krayon/pinball-OPP/MPF/SS3/images/sal_girl.jpg

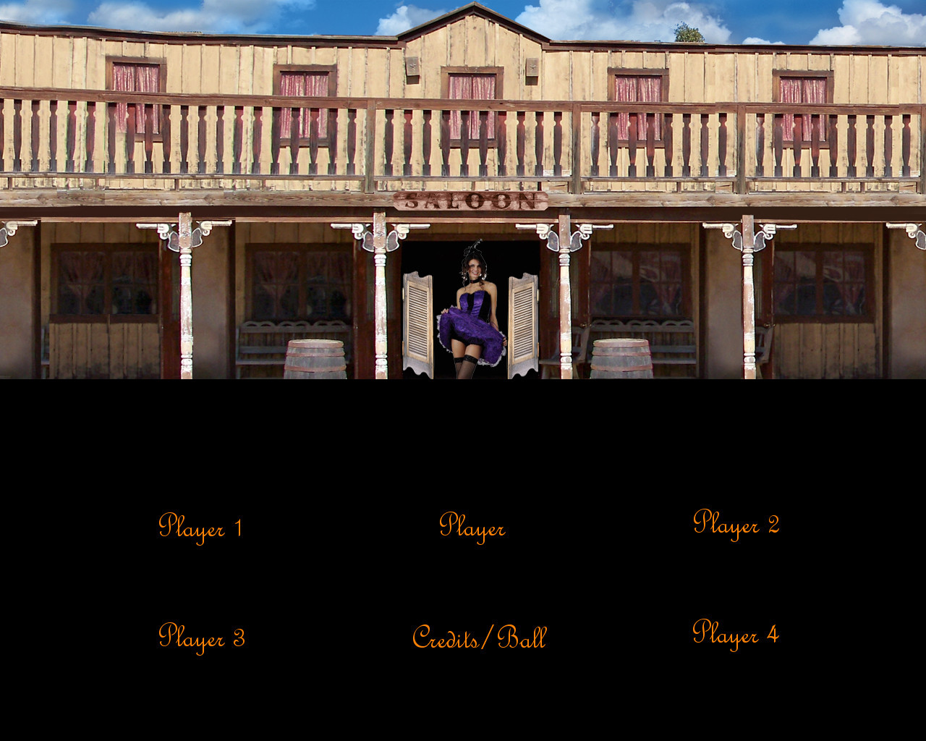
MPF/SS3/images/sal_girl.jpg
