krayon/pinball-OPP/Docs/opp_inside.jpg

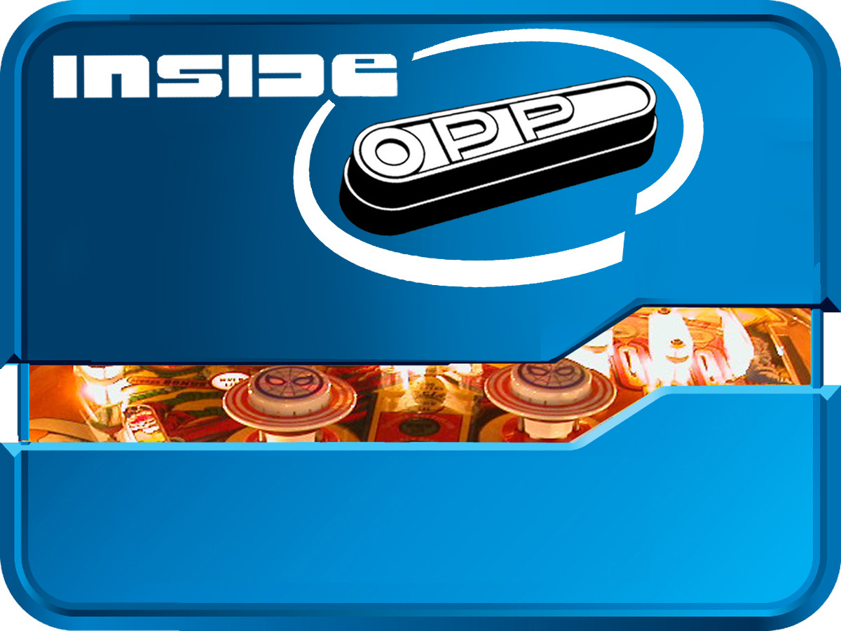
Docs/opp_inside.jpg
