krayon/pinball-OPP/Eclipse/0200-CodeDownload/CodeDownload.odt

CodeDownload

Software Design Document

Released under GPL

(Project: Code Download)

Rev 1.2

Revision Chart

Version | Author(s) | Description | Date
0.1 | Hugh Spahr | Initial version | 10/19/05
1.0 | Hugh Spahr | Initial Release | 11/12/2007
1.1 | Hugh Spahr | Added support for Freescale Processors | 04/24/2008
1.2 | Hugh Spahr | Added smaller Freescale Processor | 04/05/12

###### Contents

# Purpose

Code Download is a java executable application that allows customers to update application software using a serial port. It also provides the ability to verify that the embedded code matches a hex or srec object file.

# Product Overview

Code Download will be used for all products that use the boot loader. The user chooses the correct COM port and a connect message is sent to verify a valid link. The PIC or Freescale processor is chosen to load the correct configuration bit mask or memory map. The user can then dump EEPROM memory, program memory, or choose a hex object file to download or verify.

# Applicable Documents

None

# Terms, Definitions & Acronyms

SDD Software Design Document

CRC Cyclic Redundancy Checksum

HEC Header Error Correction

ATM Asynchronous Transfer Mode

GUI Graphical User Interface

DLL Dynamic Linked Library

# System Design Description Overview

Code Download contains java files that create the GUI and a hex filter to find object files. It also contains third party code for interfacing with a serial port, grouping all of the class files into a single jar file, and windows drivers to create a native executable. The majority of the code is in a single java file. The remainder of the pieces is used during the build process to allow for easy deployment of the application.

# Major File and Data Structures

## CodeDownload.java

CodeDownload.java contains the code for the GUI. It requires java 1.5.0 or above. The program first discovers if it is running out of a jar file. If so, it extracts the windows device driver out of the jar file and writes it to the working directory. The GUI is started and creates the menu bar, status bar, button bar, and information tabs.

A 500ms timer is used to pick up commands from the user. If a button is pressed, a bit is set in a bit mask field and processed when the timer expires. Only a single command is allowed at a time. Once a button is pressed, the rest of the buttons are “grayed” out so they aren’t active except for the connect button which is changed to cancel command button. The cancel command cancels the currently running command before transmitting another message so that the unit is ready to accept the next command.

### Menu Bar

The menu bar allows user to select the object file, serial port, baud rate, and processor. Program revision and a help message can also be accessed using the menu bar.

### Status Bar

Status bar contains COM port configuration, checksum, connection status, selected processor, and selected object file. The COM port configuration lists current COM port, baud rate, and serial port parameters. Checksum lists the checksum of the currently selected object file but is currently unimplemented. Connection status lists whether a valid connection message has been received across the serial port. Processor lists the processor that has been chosen through the menu bar. File status lists the location of the current file image that is loaded in memory.

### Button Bar

Button bar contains Connect, Download, Verify, Read Flash, Read EEPROM, Boot and a command status window. Connect sends a connect message and verifies a valid response is received. Download transmits the current file image to the unit, and runs verify on the memory after the download has completed. (Note: The code download takes approximately five minutes for a 56K file, while the verify takes approximately three minutes.) Verify insures that the program memory image on the unit matches the file image. Read Flash reads the flash memory from the unit displays it on the Prog Mem tab. Read EEPROM reads the EEPROM memory from the unit and displays it on the EEPROM tab. The Boot button resets the unit and jumps to the application if the application CRC is correct. The CRC is compared to the first flash memory location after the end of code to insure that it is correct. The command status window shows the command that is running and whether commands are being sent or received.

### Information Tabs

Five different tabs of information can be displayed. The tabs include Main, Msgs, Prog Mem, EEPROM and EEPROM Write. The Main tab displays generic high level messages such as connect msg sent, connect msg received, COM port selected, or object file read successfully. The Msgs tab displays all of the messages that have been sent and received in a hex byte format. This tab is normally used for debugging a failed command. The Prog Mem tab displays program memory read from the unit. It is not populated until the Read Flash command is run. The EEPROM tab displays the EEPROM memory read from the unit. It is not populated until the Read EEPROM is run. The EEPROM Write tab is used to write a byte of information into the EEPROM. The address and data windows need to be filled out, then the Write button can be pressed to write the byte to memory.

## HexFilter.java

HexFilter.java contains the code to only show files with the .hex or .sx extension when choosing an object file.

## RXTXcomm.jar (from rxtx.org)

RXTXcomm.jar is a library file that contains the java classes to interface with serial ports. It has the ability to open, close, read, and write on serial communication channels.

## rxtxSerial.dll (from rxtx.org)

RxtxSerial.dll is the native windows DLL that enables serial communication on a PC. Note: The rxtx package also contains librxtxSerial.so to be used on boxes running *nix. Since this wasn’t tested, it is not included in the jar file.

## one-jar-boot-0.95.jar

Java library utility to encapsulate multiple java classes into a single jar file. This allows classes and libraries to be combined so an executable jar can be formed.

## Launch4j application

The launch4j application encapsulates a java executable jar into a native executable for a PC. Launch4j allows a user to simply double click on the application to run it. The application verifies that a valid version of java is found, and if not, it takes the user to the Sun website to download the newest version of java. Since CodeDownload contains windows native DLLs, the application must be deployed as two files: an executable program, and an executable jar file. The executable jar file is needed so that the DLL can be extracted from it and the java code can be linked to this DLL.

# Build Instructions

Build instructions are located in the subversion repository as build_notes.txt.

# Appendix

No supporting documentation.

CodeDownload Page 7 Software Design Document – Rev 1.2 April 5, 2012

Hugh Spahr © 2005-2012
