krayon/pinball-OPP/CodeWarrior8bit/0100-StdLib/stdlib.odt

Standard Library

Software Design Document

(Project: StdLib)

Project # : Not applicable

P/N: Not applicable

Rev 0.4

This program is free software: you can redistribute it and/or modify it under the terms of the GNU General Public License as published by the Free Software Foundation, either version 3 of the License, or (at your option) any later version.

This program is distributed in the hope that it will be useful, but WITHOUT ANY WARRANTY; without even the implied warranty of MERCHANTABILITY or FITNESS FOR A PARTICULAR PURPOSE. See the GNU General Public License for more details.

You should have received a copy of the GNU General Public License along with this program. If not, see <http://www.gnu.org/licenses/>.

| PREPARED: | APPROVAL: LEAD ENGINEER | APPROVAL: ENGINEERING MANAGER
NAME | Hugh Spahr
SIGNED
DATE

Revision History

Version | Primary Author(s) | Description of Version | Date Completed
0.1 | Hugh Spahr | Initial version | April 22, 2008
0.2 | Hugh Spahr | Added i2c functions, added code headers | December 1, 2009
0.3 | Hugh Spahr | Added SPI functions | March 5, 2010
0.4 | Hugh Spahr | Added proper GPL banner. | May 1, 2012

# Purpose

The Standard Library provides a standard group of functionality for the HCS08 family of Freescale microcontrollers. The main features include:

- Timing functions such as tick, time stamping, one-shot and repetitive events.
- Logging and K_FATAL functions store in non-volatile storage.
- Pulse Width Modulation utilities
- Analog to Digital Conversion utilities
- Count functions for frequency calculations
- EEPROM erase/write functions
- Serial Port Transmit/Receive utilities
- Initialize digital input/output ports

# Product Overview

StdLib is a standard library for the HCS08 which enables re-use of code. By creating a library, only the functions that are needed are added to the end firmware. Use of a library allows bugs found in one project to be fixed in other projects. This document identifies the APIs

# Applicable Documents

None

# Terms, Definitions & Acronyms

ADC Analog to Digital Converter

API Application Program Interface

EEPROM Electrically Eraseable Programmable Read Only Memory

msb most significant bit

PWM Pulse Width Modulation

RTC Real Time Clock

SDD Software Design Document

TPM Timer Pulse-Width Modulator

# System Design Description Overview

StdLib is broken into separate code files based on the function. This enables the linker to remove code if it is not used in a project. The core functionality is included by all projects using the Standard Library. These include the timing and logging (including EEPROM/Flash write). It is assumed that the HCS08 is initialized with a 16 MHz processor clock, an 8 MHz bus clock, and serial port 1 is initialized as 19.2 kbps, 8, N, 1. This setup is not re-created here.

# Timing Functions

The system tick provides a tick timer with a period from 1 to 255 ms.

The system timer uses TPM2 timer with a 1 µs resolution. This means that the maximum period of a PWM channel can be 500 KHz.

The following timing structures are used for timing functions:

typedef struct

{

U16 usec;

U16 msec;

U16 sec;

} STDLI_TIMER_T;

typedef struct

{

STDLI_TIMER_T startTime;

STDLI_TIMER_T elapsedTime;

} STDLI_ELAPSED_TIME_T;

#define STDLI_REPETITIVE_EVT 0x8000

typedef struct stdli_timer_s

{

U16 time;

void (*timeout_fp)(U16 cbParm);

U16 cbParm;

U16 timeoutTicks; /* Filled by utility */

struct stdli_timer_s *next_p; /* Filled by utility */

} STDLI_TIMER_EVENT_T;

## Start Timing Clock

/*

* ===============================================================================

*

* Name: stdltime_start_timing_clock

*

* ===============================================================================

*/

/**

* Start the timing clock.

*

* Start the 1 us timing clock. This allows timestamping and logging functions to

* store the time of the event.

*

* @param poll [in] TRUE if polled instead of interrupt driven

* @return None

*

* @pre None

* @note This does not use the RTC circuitry of the HCS08. It uses timer 2 to

* enable resolutions down to 1 us. This must be called before

* stdltime_start_tick. This assumes the bus clock is 8 MHz.

*

* ===============================================================================

*/

void stdltime_start_timing_clock(

BOOL poll) /* True if polled */

## Poll Timer

/*

* ===============================================================================

*

* Name: stdltime_timer2_poll

*

* ===============================================================================

*/

/**

* Poll timer

*

* Check if a timer overflow occurred. If so, call the interrupts service routine

* to process and clear the interrupt.

*

* @param None

* @return None

*

* @pre None

* @note None

*

* ===============================================================================

*/

void stdltime_timer2_poll(void)

## Get Current Time

/*

* ===============================================================================

*

* Name: stdltime_get_curr_time

*

* ===============================================================================

*/

/**

* Get current time

*

* Read the current time and pass it back to the calling function

*

* @param time_p [out] ptr to structure with current time

* @return None

*

* @pre None

* @note None

*

* ===============================================================================

*/

void stdltime_get_curr_time(

STDLI_TIMER_T *time_p) /* ptr to returned current time struct */

## Get Elapsed Time

/*

* ===============================================================================

*

* Name: stdltime_get_elapsed_time

*

* ===============================================================================

*/

/**

* Get elapsed time

*

* Read the current time. Subtract the starting time and pass the difference

* back as elapsed time.

*

* @param elapsed_p [in/out]ptr to structure with start and elapsed time

* @return None

*

* @pre None

* @note None

*

* ===============================================================================

*/

void stdltime_get_elapsed_time(

STDLI_ELAPSED_TIME_T *elapsed_p) /* ptr to elapsed time struct*/

## Start Tick

/*

* ===============================================================================

*

* Name: stdltime_start_tick

*

* ===============================================================================

*/

/**

* Start system tick

*

* Start the system tick timer.

*

* @param numMsec [in] number of msec between ticks

* @return None

*

* @pre stdltime_start_tick - must have been called to reset numTickFunc.

* @note Uses timer 2, same as timing clock

*

* ===============================================================================

*/

void stdltime_start_tick(

U8 numMsec) /* num msec per system tick */

## Register Timer Function (One-shot, repetitive or every system tick)

/*

* ===============================================================================

*

* Name: stdltime_reg_timer_func

*

* ===============================================================================

*/

/**

* Register a timer function as either one-shot, repetitive, or system tick

*

* A system tick timer is indicated by setting the time variable to one. Since

* the callback_fp, and passedParam are copied, the passed structure can be

* allocated on the stack.

*

* A one-shot timer is indicated when the time variable > 1 system tick,

* and the msb of the time variable is clear. The passed structure is added

* to the timer linked list so it must be statically allocated.

*

* A repetitive timer is indicated when the time variable > 1 system tick,

* and the msb of the time variable is set using the STDLI_REPETITIVE_EVT

* define. The passed structure is added to the timer linked list, so it

* must be statically allocated.

*

* @param timeEvt_p [in] ptr to time event structure to be inserted

* @param offset [in] offset to the first timer event (only repetitive)

* @return None

*

* @pre None

* @note Interrupts are disabled so events can be added at non-interrupt

* level.

*

* ===============================================================================

*/

STDLI_ERR_E stdltime_reg_timer_func(

STDLI_TIMER_EVENT_T *timeEvt_p, /* ptr to time event struct to insert */

U8 offset) /* offset to first timer event, only

* for repetetive timers

*/

# Digital I/O Functions

The following enumeration is used to identify ports for read/write port operations, and to set pins as input/output, low/high drive strength for outputs, and internal pullup enable for inputs for configuration.

typedef enum

{

STDLI_DIG_PORT_A = 0x00,

STDLI_DIG_PORT_B = 0x01,

STDLI_DIG_PORT_C = 0x02,

STDLI_DIG_PORT_D = 0x03,

STDLI_DIG_PORT_E = 0x04,

STDLI_DIG_PORT_F = 0x05,

STDLI_DIG_PORT_G = 0x06,

STDLI_DIG_PORT_MASK = 0x07,

STDLI_DIG_OUT = 0x10,

STDLI_DIG_HI_DRIVE = 0x20,

STDLI_DIG_PULLUP = 0x40,

STDLI_DIG_SMALL_MODEL = 0x80, /* set if PTAPE = 0x1840, PTBPE = 0x1844 */

} STDLI_DIG_PORT_INFO_E;

## Configure digital port

/*

* ===============================================================================

*

* Name: stdldigio_config_dig_port

*

* ===============================================================================

*/

/**

* Configure digital port

*

* Configure the digital port by setting up direction, pullups if it is an input,

* or drive strength if it is an output.

*

* @param portInfo [in] port, input/output, drive, and pullup

* @param mask [in] mask of bits to change

* @param data [in] data for output bits

* @return None

*

* @pre None

* @note None

*

* ===============================================================================

*/

void stdldigio_config_dig_port(

STDLI_DIG_PORT_INFO_E portInfo, /* port, input/output, drive, and pullup */

U8 mask, /* mask of data bits to change */

U8 data) /* data if output bits, unused if input */

## Read digital port

/*

* ===============================================================================

*

* Name: stdldigio_read_port

*

* ===============================================================================

*/

/**

* Read digital port

*

* Use a mask to read and return the digital port data.

*

* @param port [in] port such as STDLI_DIG_PORT_A

* @param mask [in] mask of bits to change

* @return data data read

*

* @pre None

* @note None

*

* ===============================================================================

*/

U8 stdldigio_read_port(

STDLI_DIG_PORT_INFO_E port, /* data port, ex. NATHI_DIG_PORT_A */

U8 mask) /* mask of data bits to read */

## Write digital port

/*

* ===============================================================================

*

* Name: stdldigio_write_port

*

* ===============================================================================

*/

/**

* Write digital port

*

* Write to a digital port using a bit mask.

*

* @param port [in] port such as STDLI_DIG_PORT_A

* @param mask [in] mask of bits to change

* @param data [in] data to be written

* @return None

*

* @pre None

* @note None

*

* ===============================================================================

*/

void stdldigio_write_port(

STDLI_DIG_PORT_INFO_E port, /* data port, ex. STDLI_DIG_PORT_A */

U8 mask, /* mask of data bits to written */

U8 data) /* data to write */

# ADC Functions

The following enumeration is used to identify the ADC port. The structure is used to register an ADC channel to be sampled.

typedef enum

{

STDLI_ADC_PORT0 = 0x00,

STDLI_ADC_PORT1 = 0x01,

STDLI_ADC_PORT2 = 0x02,

STDLI_ADC_PORT3 = 0x03,

STDLI_ADC_PORT4 = 0x04,

STDLI_ADC_PORT5 = 0x05,

STDLI_ADC_PORT6 = 0x06,

STDLI_ADC_PORT7 = 0x07,

STDLI_ADC_PORT8 = 0x08,

STDLI_ADC_PORT9 = 0x09,

STDLI_ADC_PORT10 = 0x0a,

STDLI_ADC_PORT11 = 0x0b,

STDLI_ADC_PORT12 = 0x0c,

STDLI_ADC_PORT13 = 0x0d,

STDLI_ADC_PORT14 = 0x0e,

STDLI_ADC_PORT15 = 0x0f,

STDLI_ADC_PORT16 = 0x10,

STDLI_ADC_PORT17 = 0x11,

STDLI_ADC_PORT18 = 0x12,

STDLI_ADC_PORT19 = 0x13,

STDLI_ADC_PORT20 = 0x14,

STDLI_ADC_PORT21 = 0x15,

STDLI_ADC_PORT22 = 0x16,

STDLI_ADC_PORT23 = 0x17,

STDLI_ADC_TEMP_SENSOR = 0x1a,

STDLI_ADC_BANDGAP = 0x1b,

STDLI_ADC_REFHI = 0x1d,

STDLI_ADC_REFLO = 0x1e,

STDLI_ADC_MOD_DISABLE = 0x1f,

STDLI_ADC_PORT_MASK = 0x1f,

STDLI_ADC_POLL_MODE = 0x40, /* set if ADC channel is polled */

STDLI_ADC_DIG_SMALL_MODEL = 0x80, /* set if PTAPE = 0x1840, PTBPE = 0x1844 */

} STDLI_ADC_PORT_E;

typedef struct stdli_adc_chan_s

{

STDLI_ADC_PORT_E chan;

void (*adcSample_fp)(U16 cbParam, U16 sample);

U16 cbParm;

struct stdli_adc_chan_s *next_p; /* Filled by utility */

} STDLI_ADC_CHAN_T;

## Initialize ADC

/*

* ===============================================================================

*

* Name: stdladc_init_adc

*

* ===============================================================================

*/

/**

* Initialize the ADC

*

* Initialize the ADC including setting up a clock

*

* @param adcCfg [in] STDLI_ADC_FAST every 1 ms, STDLI_ADC_SLOW once/tick

* @return None

*

* @pre None

* @note None

*

* ===============================================================================

*/

void stdladc_init_adc(void)

## Register ADC channel

/*

* ===============================================================================

*

* Name: stdladc_reg_adc_chan

*

* ===============================================================================

*/

/**

* Register the ADC channel to be sampled

*

* Register the ADC channel by adding it to the ADC linked list. If the

* ADC channel is previously configured, an error is returned. Set up the

* pin control and the digital port.

*

* @param chanInfo [in] ptr to ADC chan, and callback info

* @return None

*

* @pre None

* @note None

*

* ===============================================================================

*/

STDLI_ERR_E stdladc_reg_adc_chan(

STDLI_ADC_CHAN_T *adcChan_p) /* ptr to ADC chan, callback info */

## Poll ADC Complete

/*

* ===============================================================================

*

* Name: stdladc_adc_complete_poll

*

* ===============================================================================

*/

/**

* Poll ADC Complete

*

* Check if ADC complete occurred. If so, call the interrupts service routine

* to process and clear the interrupt.

*

* @param None

* @return None

*

* @pre None

* @note None

*

* ===============================================================================

*/

void stdladc_adc_complete_poll(void)

## Start ADC sampling

/*

* ===============================================================================

*

* Name: stdladc_start_adc_sampling

*

* ===============================================================================

*/

/**

* Start the ADC sampling

*

* At the next 1 ms clock tick, the ADC will start sampling, and move from the

* lowest channel to the highest channel.

*

* @param None

* @return STDLI_ADC_NO_CHAN_REG - No ADC channels registered

*

* @pre None

* @note None

*

* ===============================================================================

*/

STDLI_ERR_E stdladc_start_adc_sampling(void)

# EEPROM/Flash Functions

The following functions are used to erase or write to EEPROM/Flash.

## Initialize EEPROM address

/*

* ===============================================================================

*

* Name: stdleeprom_init_eeprom_addr

*

* ===============================================================================

*/

/**

* Initialize EEPROM address

*

* Initialize EEPROM address. The EEPROM address allows the library to support

* multiple processors.

*

* @param addr_p [in] ptr to first addr of eeprom

* @return None

*

* @pre None

* @note None

*

* ===============================================================================

*/

void stdleeprom_init_eeprom_addr(

U8 *addr_p) /* ptr to first addr of eeprom */

## Start EEPROM Sector Erase

/*

* ===============================================================================

*

* Name: stdleeprom_start_sector_erase

*

* ===============================================================================

*/

/**

* Start EEPROM sector erase

*

* Initiate a sector erase in the EEPROM.

*

* @param addr_p [in] ptr to EEPROM sector address to erase

* @return None

*

* @pre None

* @note None

*

* ===============================================================================

*/

void stdleeprom_start_sector_erase(

U8 *addr_p) /* ptr to sector addr in eeprom */

## Check Command Done

/*

* ===============================================================================

*

* Name: stdleeprom_check_cmd_done

*

* ===============================================================================

*/

/**

* Check if an EEPROM cmd is done

*

* Check if the EEPROM cmd is done by checking if the FCCF bit is set.

*

* @param None

* @return None

*

* @pre None

* @note None

*

* ===============================================================================

*/

BOOL stdleeprom_check_cmd_done(void)

## Start EEPROM Write

/*

* ===============================================================================

*

* Name: stdleeprom_start_write

*

* ===============================================================================

*/

/**

* Start EEPROM write byte

*

* Initiate a write byte to the EEPROM.

*

* @param addr_p [in] ptr to EEPROM sector address to write

* @param data [in] data to write

* @return None

*

* @pre None

* @note User must insure that the data is erased.

*

* ===============================================================================

*/

void stdleeprom_start_write(

U8 *addr_p, /* ptr to addr in eeprom to write */

U8 data) /* data to write */

## Start Flash Sector Erase

/*

* ===============================================================================

*

* Name: stdleeprom_start_flash_sector_erase

*

* ===============================================================================

*/

/**

* Start Flash sector erase

*

* Initiate a sector erase in the Flash.

*

* @param addr_p [in] ptr to Flash sector address to erase

* @return None

*

* @pre None

* @note None

*

* ===============================================================================

*/

void stdleeprom_start_flash_sector_erase(

U8 *addr_p) /* ptr to sector addr in eeprom */

## Start Flash Write

/*

* ===============================================================================

*

* Name: stdleeprom_start_flash_write

*

* ===============================================================================

*/

/**

* Start Flash write byte

*

* Initiate a write byte to the Flash.

*

* @param addr_p [in] ptr to Flash sector address to write

* @param data [in] data to write

* @return None

*

* @pre None

* @note User must insure that the data is erased.

*

* ===============================================================================

*/

void stdleeprom_start_flash_write(

U8 *addr_p, /* ptr to addr in eeprom to write */

U8 data) /* data to write */

# Event Functions

The structure is used as an event log:

typedef struct

{

U32 event;

U32 timeStamp;

U16 data[2];

} STDLI_EVENT_LOG_T;

## Initialize event log

/*

* ===============================================================================

*

* Name: stdlevt_init_log_event

*

* ===============================================================================

*/

/**

* Initialize the event log.

*

* Initialize the event log. It must be handed in the address of the first event

* log entry, the address of the end of the log, and the starting EEPROM address.

* The EEPROM address allows the library to support multiple processors. If the

* event log is to be stored in Flash instead of EEPROM, eeprom_p must be 0.

*

* @param firstEvt_p [in] ptr to first event log entry

* @param endLog_p [in] ptr to the end of the log

* @param eeprom_p [in] ptr to first addr of EEPROM, or 0 for Flash

* @return STDLI_NO_EVENTS_AVAIL - Event log is completely filled

*

* @pre None

* @note First and end addresses must be within the EEPROM memory.

*

* ===============================================================================

*/

STDLI_ERR_E stdlevt_init_log_event(

STDLI_EVENT_LOG_T *firstEvt_p, /* ptr to first event log entry */

U8 *endLog_p, /* ptr to the end of the log */

U8 *eeprom_p) /* EEPROM start or 0 for log in Flash */

## Log Event

/*

* ===============================================================================

*

* Name: stdlevt_log_event

*

* ===============================================================================

*/

/**

* Log an event

*

* This function is usually called through a macro. The macro fills out the

* fileId and lineNum. The current time is grabbed, and the next unused event

* is located. The log record is stored in the EEPROM. If this is a k_fatal

* event, the processor is reset.

*

* @param eventId [in] (event << 20) | (fileId << 12) | lineNum

* @param data1 [in] 16 bits of extra info which is event specific

* @param data2 [in] 16 bits of extra info which is event specific

* @param k_fatal [in] TRUE if this is a k_fatal event.

* @return None

*

* @pre stdlevt_start_timing_clock

* @note None

*

* ===============================================================================

*/

void stdlevt_log_event(

U32 eventId, /* event id, includes event/file/line */

U16 data1, /* event spec data */

U16 data2, /* event spec data */

BOOL kFatal) /* TRUE if this is a k_fatal */

## STDLI_K_FATAL_M

/*

* ===============================================================================

*

* Name: STDLI_K_FATAL_M

*

* ===============================================================================

*/

/**

* The K_FATAL macro

*

* The K_FATAL macro fills out an event record with current fileId and lineNum.

* The current time is grabbed, and the next unused event is located.

* The log record is stored in the EEPROM. The processor is reset.

*

* @param eventId [in] 12 bit event identifier

* @param data1 [in] 16 bits of extra info which is event specific

* @param data2 [in] 16 bits of extra info which is event specific

* @return None

*

* @pre stdltime_start_timing_clock

* @note Processor is reset

*

* ===============================================================================

*/

#define STDLI_K_FATAL_M(event, data1, data2) \

## STDLI_LOG_EVENT_M

/*

* ===============================================================================

*

* Name: STDLI_LOG_EVENT_M

*

* ===============================================================================

*/

/**

* The LOG_EVENT macro

*

* The LOG_EVENT macro fills out an event record with current fileId and lineNum.

* The current time is grabbed, and the next unused event is located.

* The log record is stored in the EEPROM.

*

* @param eventId [in] 12 bit event identifier

* @param data1 [in] 16 bits of extra info which is event specific

* @param data2 [in] 16 bits of extra info which is event specific

* @return None

*

* @pre stdltime_start_timing_clock

* @note None

*

* ===============================================================================

*/

#define STDLI_LOG_EVENT_M(event, data1, data2) \

# Serial Functions

The following enumeration is used to identify the serial port:

typedef enum

{

STDLI_SER_PORT_1 = 0x00,

STDLI_SER_PORT_2 = 0x01,

STDLI_NUM_SER_PORT = 0x02,

STDLI_POLL_SER_PORT = 0x80,

} STDLI_SER_PORT_E;

The following structure is used to initialize the serial port:

typedef struct

{

U8 *txBuf_p;

U8 txBufSize;

void (*rxSerChar_fp)(U16 cbParm, U8 data);

U16 cbParm;

U8 curTxHead; /* Filled by utility */

U8 curTxTail; /* Filled by utility */

BOOL txAct; /* Filled by utility */

U8 pollBit; /* Filled by utility */

} STDLI_SER_INFO_T;

## Initialize serial module

/*

* ===============================================================================

*

* Name: stdlser_ser_module_init

*

* ===============================================================================

*/

/**

* Initialize the serial port module

*

* Initialize the global serial port data.

*

* @param None

* @return None

*

* @pre None

* @note None

*

* ===============================================================================

*/

void stdlser_ser_module_init(void)

## Initialize serial port

/*

* ===============================================================================

*

* Name: stdlser_init_ser_port

*

* ===============================================================================

*/

/**

* Initialize a serial port

*

* Initialize head and tail to 0, and make xmt inactive. Configure the port

* to 19.2 kbps, 8, N, 1, and enable the rcv interrupt.

*

* @param portNum [in] Either STDLI_SER_PORT_1 or STDLI_SER_PORT_2

* OR in STDLI_POLL_SER_PORT if polling

* @param serInfo_p [in] Info for the serial port state. Since the passed

* structure is not copied, it must be statically

* allocated. Serial state contains ptr to txBuf,

* size of txBuf, rxChar callback function addr,

* callback parameter handed to rxChar function.

* @return None

*

* @pre stdlser_init_ser_module must be called first.

* @note None

*

* ===============================================================================

*/

void stdlser_init_ser_port(

STDLI_SER_PORT_E portNum, /* Serial port number or poll port*/

STDLI_SER_INFO_T *serInfo_p) /* Ser state, txBuf addr, txBuf size, rx

* callback func.

*/

## Poll Serial Port

/*

* ===============================================================================

*

* Name: stdlser_portx_poll

*

* ===============================================================================

*/

/**

* Poll the serial port

*

* Poll the serial port to see if any data has been transmitted or received.

*

* @param None

* @return None

*

* @pre None

* @note None

*

* ===============================================================================

*/

void stdlser_port1_poll(void)

void stdlser_port2_poll(void)

## Transmit data

/*

* ===============================================================================

*

* Name: stdlser_xmt_data

*

* ===============================================================================

*/

/**

* Function for transmitting data on a serial port

*

* Copy xmt data to the xmt data queue if space is available. If no space is

* avail, either block waiting for space (while petting the watchdog), or return

* the number of chars that were sent.

*

* @param portNum [in] Either STDLI_SER_PORT_1 or STDLI_SER_PORT_2

* @param blocking [in] TRUE if wait forever put the tx data on the queue

* @param data_p [in] Ptr to data to xmt

* @param numChar [in] Num chars to xmt

* @return Num chars sent, always numChar if blocking = TRUE

*

* @pre stdlser_init_ser_port must be called first.

* @note None

*

* ===============================================================================

*/

U8 stdlser_xmt_data(

STDLI_SER_PORT_E portNum, /* Serial port number */

BOOL blocking, /* TRUE to block when queuing xmt data */

U8 *data_p, /* Ptr to data to xmt */

U16 numChar) /* Num chars to xmt */

## Calculate CRC8

/*

* ===============================================================================

*

* Name: stdlser_calc_crc8

*

* ===============================================================================

*/

/**

* Function for calculating the CRC8 of a data stream

*

* Set the initial value of the CRC8 to 0xff, and run the CRC8 calculation using

* a 16 entry lookup table.

*

* @param length [in] Num chars in data stream

* @param data_p [in] Ptr to data stream

* @return CRC8

*

* @pre None

* @note Generator polynomial is x^8+x^2+x+1. Initial value is 0xff to

* conform to the ATM HEC CRC8

*

* ===============================================================================

*/

U8 stdlser_calc_crc8(

U8 length, /* Num chars in data stream */

U8 *data_p) /* Ptr to data stream */

# PWM Functions

The following enumeration is used to identify the TPM number, and PWM channel:

typedef enum

{

STDLI_TPM_1 = 0x00,

STDLI_TPM_2 = 0x40,

STDLI_PWM_CHAN_0 = 0x00,

STDLI_PWM_CHAN_1 = 0x01,

STDLI_PWM_CHAN_2 = 0x02,

STDLI_PWM_CHAN_3 = 0x03,

STDLI_PWM_CHAN_4 = 0x04,

STDLI_PWM_CHAN_5 = 0x05,

STDLI_MAX_PWM_CHAN = 0x06,

STDLI_PWM_CHAN_MASK = 0x07,

STDLI_TPM_MASK = 0x40, /* Note: Matches with HW addr offset */

} STDLI_TPM_CHAN_E;

The following enumeration are the states that a capture channel uses, these are not needed by the StdLib client:

typedef enum

{

STDLI_CAP_IDLE = 0x00,

STDLI_CAP_START = 0x01,

STDLI_CAP_FIRST_SMPLE = 0x02,

} STDLI_CAP_STATE_E;

The following structure is used to configure a capture channel:

typedef struct stdli_cap_s

{

STDLI_TPM_CHAN_E capChan;

void (*capDone_fp)(U16 cbParm, U16 data);

U16 cbParm;

U8 maxTicks;

U16 startCnt; /* Filled by utility */

STDLI_CAP_STATE_E state; /* Filled by utility */

U8 tickCnt; /* Filled by utility */

struct stdlii_cap_s *next_p; /* Filled by utility */

} STDLI_CAP_T;

## Initialize PWM module

/*

* ===============================================================================

*

* Name: stdlpwm_init_pwm_module

*

* ===============================================================================

*/

/**

* Initialize the PWM module

*

* Clear the capture ptr and configed PWM channel bitmask.

*

* @param None

* @return None

*

* @pre None

* @note None

*

* ===============================================================================

*/

void stdlpwm_init_pwm_module(void)

## Set TPM1 period

/*

* ===============================================================================

*

* Name: stdlpwm_set_tpm1_period

*

* ===============================================================================

*/

/**

* Set TPM1 period

*

* Initialize the PWM timer to a period.

*

* @param maxPeriod [in] Maximum period in ticks. Each tick is 1 us.

* @return None

*

* @pre None

* @note This assumes the bus clock is 8 MHz. It sets the base clock

* frequency to 1 us.

*

* ===============================================================================

*/

void stdlpwm_set_tpm1_period(

U16 maxPeriod) /* Max period in ticks */

## Configure capture channel

/*

* ===============================================================================

*

* Name: stdlpwm_config_cap_chan

*

* ===============================================================================

*/

/**

* Configure a PWM capture channel

*

* Verify the channel has not been previously configured. Insure the clock

* is configured. Initialize the state and add to the capture linked list.

*

* @param capChan [in] TPM number and channel

* @param capDone_fp [in] Capture done function ptr

* @param cbParm [in] Callback param

* @return STDLI_CAP_CHAN_PREV_CFG - capture channel previously configed

* STDLI_TIMER_NOT_CFG - TPM timer is not started

*

* @pre TPM timer must be started.

* @note The passed structure is added to the capture linked list, so it

* must be statically allocated.

*

* ===============================================================================

*/

STDLI_ERR_E stdlpwm_config_cap_chan(

STDLI_CAP_T *capCfg_p) /* Capture cfg with TPM num, chan num,

* done func ptr, and callback param.

*/

## Start capture channel

/*

* ===============================================================================

*

* Name: stdlpwm_start_cap_chan

*

* ===============================================================================

*/

/**

* Start a PWM capture channel

*

* Start a prev configed capture channel. Find capture channel on linked

* list, verify it isn't currently running, and start a new capture calculation.

*

* @param capChan [in] TPM number and channel

* @return STDLI_CAP_CHAN_NOT_CFG - capture channel not configed

* STDLI_CAP_CUR_RUNNING - capture is currently running

*

* @pre None

* @note None

*

* ===============================================================================

*/

STDLI_ERR_E stdlpwm_start_cap_chan(

STDLI_TPM_CHAN_E capChan) /* TPM number and channel */

## Start PWM channel

/*

* ===============================================================================

*

* Name: stdlpwm_start_pwm_chan

*

* ===============================================================================

*/

/**

* Start a PWM channel

*

* If the PWM channel was not previously configed, verify the timer

* is started, set up the digital port, and config the PWM. Verify the

* on count is less than the period and program.

*

* @param capChan [in] TPM number and channel

* @return STDLI_TIMER_NOT_CFG - timer not configed

*

* @pre None

* @note None

*

* ===============================================================================

*/

STDLI_ERR_E stdlpwm_start_pwm_chan(

STDLI_TPM_CHAN_E capChan, /* TPM number and channel */

# I2c Functions

The following enumeration is used return i2c errors.

typedef enum

{

STDLI_I2C_XFER_OK = 0x00,

STDLI_I2C_NO_RESP = 0x01,

} STDLI_I2C_RESP_E;

The following enumeration is used to indicate a message address is for reading or writing.

typedef enum

{

STDLI_I2C_WRITE_ADDR = 0x00,

STDLI_I2C_READ_ADDR = 0x01,

} STDLI_I2C_ADDR_E;

The following structure is used to send or receive an i2c message.

typedef struct

{

U8 addr;

U8 *data_p;

U8 numDataBytes;

void (*i2cDone_fp)(U16 cbParm, STDLI_I2C_RESP_E status);

U16 cbParm;

} STDLI_I2C_XFER_T;

## Initialize i2c

/*

* ===============================================================================

*

* Name: stdli2c_init_i2c

*

* ===============================================================================

*/

/**

* Initialize the i2c bus

*

* Set the i2c to 200 kbps,

*

* @param poll [in] TRUE if polled instead of interrupt driven

* @return None

*

* @pre None

* @note None

*

* ===============================================================================

*/

void stdli2c_init_i2c(

BOOL poll) /* True if polled */

## Poll i2c

/*

* ===============================================================================

*

* Name: stdli2c_i2c_complete_poll

*

* ===============================================================================

*/

/**

* Poll I2C to see if interrupt occurred

*

* Test if the i2c interrupt flag bit is set. If so call the interrupt service

* routine to process and clear the interrupt.

*

* @param None

* @return None

*

* @pre None

* @note None

*

* ===============================================================================

*/

void stdli2c_i2c_complete_poll(void)

## Send i2c Msg

/*

* ===============================================================================

*

* Name: stdli2c_send_i2c_msg

*

* ===============================================================================

*/

/**

* Send an i2c message to read/write data

*

* Verify the i2c state machine is idle. Set i2c controller to start

* transmitting. Write the address of the slave to access.

*

* @param i2cXfer_p [in] ptr that contains address, data_p, num bytes, and

* call back information.

* @return STDLI_I2C_NOT_IDLE if bus not idle

*

* @pre None

* @note None

*

* ===============================================================================

*/

STDLI_ERR_E stdli2c_send_i2c_msg(

STDLI_I2C_XFER_T *i2cXfer_p) /* ptr to i2c xfer structure */

# SPI Functions

The following enumeration is used initialize the SPI clock, and set whether the SPI functions are interrupt driven or polled.

typedef enum

{

SPI_CLK_DIV2 = 0x00,

SPI_CLK_DIV4 = 0x01,

SPI_CLK_DIV8 = 0x02,

SPI_CLK_DIV16 = 0x03,

SPI_CLK_DIV32 = 0x04,

SPI_CLK_DIV64 = 0x05,

SPI_CLK_DIV128 = 0x06,

SPI_CLK_DIV256 = 0x07,

SPI_CLK_DIV_MASK = 0x07,

SPI_POLL = 0x80,

} STDLI_SPI_PARAM_E;

The following enumeration is used to indicate a the clock and phase for the SPI transaction, and if the transaction is a read or a write.

typedef enum

{

STDLI_SPI_READ = 0x00,

STDLI_SPI_WRITE = 0x01,

STDLI_SPI_CPHA0 = 0x00, /* First SCLK trans latches data */

STDLI_SPI_CPHA1 = 0x04, /* Sec SCLK trans latches data */

STDLI_SPI_CPOL0 = 0x00, /* SCLK idles low */

STDLI_SPI_CPOL1 = 0x08, /* SCLK idles high */

STDLI_SPI_CPOL_CPHA_MASK = 0x0c,

} STDLI_SPI_DIR_E;

The following structure is used to send or receive a SPI message.

typedef struct stldi_spi_xfer_s

{

STDLI_SPI_DIR_E dir;

U8 *data_p;

U8 numDataBytes;

STDLI_DIG_PORT_INFO_E csPort;

U8 csMask;

void (*spiDone_fp)(U16 cbParm);

U16 cbParm;

struct stldi_spi_xfer_s *next_p;

} STDLI_SPI_XFER_T;

## Initialize SPI

/*

* ===============================================================================

*

* Name: stdlspi_init_spi

*

* ===============================================================================

*/

/**

* Initialize the SPI bus

*

* Set the i2c to 200 kbps or 100 kbps for Freescale.

*

* @param param [in] poll mode and clk div

* @return None

*

* @pre None

* @note The chip select signal is not set up during the init. It is up to

* caller of this function to initialize the digital I/O port.

*

* ===============================================================================

*/

void stdlspi_init_spi(

STDLI_SPI_PARAM_E param) /* set poll mode and clk div */

## Send SPI Message

/*

* ===============================================================================

*

* Name: stdlspi_send_spi_msg

*

* ===============================================================================

*/

/**

* Send a SPI message to read/write data

*

* If the SPI is idle, put it on the linked list, and start the transfer.

* If the SPI is not idle, add the transfer to the end of the list.

*

* @param spiXfer_p [in] ptr that contains opt, data_p, num bytes, chip

* select, and call back information.

* @return None

*

* @pre None

* @note None

*

* ===============================================================================

*/

void stdlspi_send_spi_msg(

STDLI_SPI_XFER_T *spiXfer_p) /* ptr to SPI xfer structure */

## Poll SPI

/*

* ===============================================================================

*

* Name: stdlspi_spi_complete_poll

*

* ===============================================================================

*/

/**

* SPI interrupt service routine

*

* If writing, check if done transmitting. If not, clear status and send next

* byte. If reading, check if done. If not, write the next dummy data value

* to be sent. If the transfer is complete, clear the CS, and call the callback

* function. Check to see if another SPI xfer is pending and start it if it

* exists.

*

* @param None

* @return None

*

* @pre None

* @note None

*

* ===============================================================================

*/

void stdlspi_spi_complete_poll(void)

# Appendix

No supporting documentation.

Standard Library Page 2 Software Design Document – Rev 0.4 May 1, 2012

Copyright © 2012 Hugh Spahr
