krayon/pinball-OPP/Python/PinballFramework/SS3/RuleSheet.odt

Rule Sheet for SharpeShooter III

SharpeShooter III (SS3), has four levels and eleven modes. To move to the next level, all eleven modes have to be completed. The game starts at the easiest level and moves towards wizard mode. There may be an option to start the game in eithereasy, medium or hard mode. Wizard mode needs to be earned.

Multiplier:

The multiplier is increased by completing all the inlanes. Inlanes completed to start a mode or complete a sub-mode do not count to increase the multiplier. The state of the inlanes is stored when passing through states that require all lanes completed, so when the state is done, the inlane progress can be restored. Multipliers are reset when a ball is drained. The multiplier is applied to the spinner target. Sinking the kickout hole when not in a mode collects the current bonus (num spins for ball times multipler).

The levels are:

- Easy: Flipper buttons can rotate between all inlanes. The status towards starting a mode is remembered between balls. A mode is completed when the ball drains. Jackpot shot is available for 30 seconds. A jackpot resets the timer for another 30 seconds. A ball drain completes the mode, the next ball will begin working towards starting another mode. (Allows a difficult mode to be completed by losing the ball).
- Medium: Flipper buttons can rotate top inlanes and can rotate bottom inlanes separately. The status towards starting a mode is remembered between balls. The status within a mode is remembered between balls. Kickout hole must be hit again to restart the mode. Jackpot timer is 20 seconds. A jackpot resets the timer for another 20 seconds. (Can use multiple balls to complete a mode).
- Hard: Flipper buttons do not rotate inlanes. The status towards starting a mode is reset when a ball drains. Jackpot timer is 60 seconds. A jackpot does not reset the timer.
- Wizard: Flipper buttons do not rotate inlanes. Cradling is disabled. The status towards starting a mode is reset when a ball drains. Jackpot timer is 45 seconds. A jackpot does not reset the timer.

A mode is entered by completing all the inlanes, completing all the SHOOTER drop targets and finally shooting the kickout hole. In easy level, inlanes and shooter targets can be collected in any order. In all other levels, inlanes must be collected, shooter targets are then reset and shooter targets must be collected before shooting kickout hole. Making the skillshot in easy or medium level advances the player toward starting a mode by completing the inlanes or shooter drop targets.

The modes are:

1. Call Posse: Spinner lane ten times then kickout hole. State contains number of spins. Future will give two ball multiball.
2. Hustle and Jive: Complete all inlanes. Flipper button rotate and tilt bob are disabled. State contains inlanes already completed.
3. Target Practice: Blink random pop, random shooter target, random inlane, spinner orbit, and finish with kickout hole. State contains next target to hit.
4. Check Hideouts: Must hit standup targets 5 times each. Top target is abandoned mine, lower target is abandoned house. Blink left pop bumper to indicate where shots should be aimed. Verbal cues are used to indicate which target needs to be hit the most. State contains number of times standups have been hit with top 16 bits number of abandoned mine hits.
5. Sniper: Hit five individual drop targets. In easy and medium levels, the targets next to the blinking target is allowed to be hit. Pop bumpers (lower?) are disabled.
6. Sharpe Attack: Hit five individual drop targets with no cradling allowed. In easy and medium levels, the targets next to the blinking target are allowed to be hit.
7. Track Bandits: Collect all lanes. Rotate of flippers is dictated by the level. Jackpot lane must also be collected. Then knock down all the shooter targets.
8. Kill 'em All: Drop all shooter targets 3 times. (This might be a timed mode where a bank must be completed within x seconds).
9. Bar Fight: Hit each pop bumper 10 times. As the bumpers get hit more, the pop bmpers stay lit longer. When a pop bumper is completed, the light is full on. Pop bumper is disabled after ten hits.
10. Duel: Hit a blinking drop target within certain period of time. If missed, there is a reload time, and then another random drop target blinks. There is a chance during the mode that the dueler will be hit.
11. Ride for Help: Five orbits (either jackpot loop, or spinner loop), then sink the kickout hole. Future will give two ball multiball.

Completing a mode awards 500 points on easy, 750 points on medium, 1000 points on hard, and 1500 points on the wizard level. Jackpots are worth 100 points on easy, 150 points on medium, 200 points on hard, and 300 points on wizard level.

When starting a game, the level can be selected as easy, medium or hard. To get to wizard level, you have to earn it. Each player can set their level.

Completing the inlanes awards 50 points on easy, 75 points on medium, 100 points on hard, and 150 points on wizard level.

Inlanes, 2 points if already lit, 5 points if not lit.

Drop targets, 2 points if not currently targetted, 5 points if being targetted.
