krayon/pinball-OPP/Docs/CCodingStds.odt

Software Coding Standards

Rev: 0.3

Author: Hugh Spahr

Date: 4/28/2014

# Revision History

Version | Primary Author(s) | Description of Version | Date Completed
0.1 | Hugh Spahr | Initial draft | 04/23/06
0.2 | Hugh Spahr | Update and rewrite changes lost around 2010. Added GPLv3 statements to header. | 04/28/14
0.3 | Hugh Spahr | Update file headers/function headers with changes that were lost. | 05/01/14

Table of Contents

# Introduction

Standards are important, and coding standards can help code development significantly.

Here are a couple of reasons that companies use coding standards:

- Understanding another person’s code takes less time.
- Inspecting/reviewing another person’s code is simpler since they use the same style encouraging reviews.
- Reviews can spend more time focusing on issues instead of style differences.
- Programmers new to a project can understand the project and layout more quickly.
- Coding standards can reduce common mistakes that can occur because C is a loosely typed language.
- Coders make fewer mistakes in a consistent environment, especially interfacing between two different styles. (Was 0 a good returned value or a bad returned value?)

There are many reasons that people don’t like coding standards. These seem to boil down to “I don’t write code in that style.” Books and papers on rapid code development that address this topic all agree that coding standards are a good thing. See Steve McConnell’s, Code Complete, or many papers on Carnegie Mellon’s software development site if you are interested in researching this topic.

# Module Structuring

Module files shall always be grouped within a functional subdirectory. An example for a module might be GUI (graphical user interface) or connmgr (connection manager). A module is a group of files that contain a xxxxglob.h file, xxxxintf.h file, and up to sixteen .c files. The xxxxglob.h file contains structures and variables shared between all files within the module, while the xxxxintf.h file contains structures and prototypes that are shared to other modules.

Within a module, all files can optionally use the module identifier as the first few characters in their name. This helps programmers to quickly understand where functions can be found.

The XXXXG_INSTANTIATE constant is found in the xxxxglob.h file to instantiate the module wide variables.

Example:

#ifndef SERG_INSTANTIATE
extern
#endif

SERG_INFO_DS serg_info

#ifdef SERG_INSTANTIATE

= {NULL}

#endif

;

The #define SERG_INSTANTIATE is typically found in the main .c file of the module.

# Naming Conventions

Naming conventions are the basics of all good coding standards. Using enumerations instead of defines allows the compiler to perform extra checking. The compiler is your friend. Let it find as many bugs as possible because it will just make your life that much easier.

## Variable Names

All variables shall use mixed case names. All variables shall start with a lower case letter and the beginning of each word within a variable name should be capitalized for clarity. A suffix may be added for extra clarity.

### Normal Variables

Examples:

localCnt - a local counter

atmHEC - ATM Header error correction. Some coders hate the all capital HEC acronym, but if it looks like a variable name it should be OK. A bad version of this variable name would be ATMHEC. It is both unreadable, and it looks like a constant.

### Pointer Variables

All pointers should have a _p as a suffix, or _pp if they are pointers to pointers. This style should be used instead of Hungarian notation because map files usually alphabetize variables, and this would put all pointers together.

Examples:

tmpCfg_p - a temporary pointer to a configuration structure

lnkLst_pp - a pointer to pointer for a linked list element

This easily allows you to notice that the following statement is incorrect:

commIntf_p->intfCnt = intfCnt_p;

## Constant Names

All constants shall use all upper case letters with underscores between each word.

Examples:

#define MAX_PRESSURE 400

#define MAX_U16 0xffffU

#define COMMG_MAX_NUM_ENTRIES 64

The last constant name example contains a prefix to indicate that the constant is defined in the commglob.h file.

## Macro Names

All macros shall use all upper case letters with underscores between each word and a _M at the end. Macros shall pass all variables that are used into them instead of relying on variables within the function.

Examples:

#define MAX_PRESS_M(pressA, pressB) (((pressA) > (pressB)) ? pressA: pressB)

#define AVG_PRESS_M(press_p, numEntries, tmp, avgPress) \

{ \

(avgPress) = 0; \

for ((tmp) = 0; (tmp) < (numEntries); (tmp)++, (press_p)++) \

{ \

(avgPress) += *(press_p); \

} \

}

The last example shows a multi-line macro. A multi-line macro shall include a standard header which is not displayed here.

## Function Names

All functions shall use all lower case letters with underscores between each word. Optionally, a function name may use a prefix that identifies the file where it resides. This is very useful for functions that are shared across modules, and illustrates the importance of creating file names that are short and concise.

Example:

commhw_remove_intf()

## Enumerations

All enumerations shall use type definitions and are named using all upper case letters with underscores between each word and a _E at the end. Optionally a prefix identifying the where the enumeration resides may be included. In the following example, the enumeration is defined in the tunglob.h. This style helps particularly during code inspections to insure that all required information is available, and other modules are not accessing information that should be hidden from them.

Examples:

typedef enum

{

INITIAL_STATE = 0x00,

START_STATE,

TX_STATE,

RX_STATE,

REMOVE_STATE,

MAX_TUNNEL_STATE,

TUNNEL_STATE_SIZE = MAX_U16

} TUNG_STATE_E;

This example shows an enumeration of tunnel states. The last tunnel state entry is included so that the enumeration can be properly sized using the packed keyword. If the size of the enumeration does not matter, this entry can be removed. This same enumeration style can be used to define bits within a register. Compiler bit definitions shall not be used because it makes code non-portable.

## Typedef’d Structures

All structures shall use a type definition, and are named using all upper case letters with underscores between each word and a _T at the end.

Examples:

typedef struct tunnel_state_s

{

struct tunnel_state_s *next_p;

U32 txPkts; /* Num tx packets */

INT ovfCnt; /* Overflow count */

TUNG_STATE_E state; /* Current state of the tunnel */

} TUNNEL_STATE_T;

This example shows a tunnel state structure which is part of a linked list. The structure tunnel_state_s should never be used unless it is referring to the structure itself. All references should variables of type TUNNEL_STATE_T so that the compiler can use more stringent type checking.

## Array Names

Array names are named just like variable names. When accessing an array, and index shall always be used.

Examples:

SERG_PORT_INFO serPortInfo[SERG_MAX_SER_PORTS];

SERG_PORT_INFO *portInfo_p;

for (portInfo_p = &serPortInfo[0];

portInfo_p < &serPortInfo[SERG_MAX_SER_PORTS]; portInfo_p++)

{

/* Rest of the code */

In the above example, note that indexes are always used instead of just using the variable name. This immediately indicates that the variable is an array. One last example below.

portInfo_p = serPortInfo; /* !!!! Wrong !!!! Don’t use this construct */

The compiler allows this construct, but by inspection, it looks like a non-pointer is being assigned to a pointer. Note: The compiler compiles these two pieces of code to exactly the same code because 0 and SERG_MAX_SER_PORTS are constants, and the compiler can compute the addresses before run time.

## Filenames

Filenames can use both upper and lower case letters for clarity. All versions of windows that don't know the difference between upper and lower case letters seem to have disappeared. Most of the tools also now recognize the difference between upper and lower case letters and don't automatically convert to upper case. File names are of the form xxxxyyyy.c or xxxxyyyy.h. The xxxx portion identifies the code in the file, while yyyy identifies the level of the code. File names shall not contain underscores within the name.

Examples:

serhw.c - serial port hardware file (implements the hardware abstraction layer)

serintf.c - serial interface file (usually helper functions that provide services such as queuing, and higher level functionality

serproc.c - serial processing file

fftutil.c - FFT processing utility

fuelcutoffproc.c - fuel cutoff processing

refuelglob.h - global defines for the refuel module

refuelintf.h - interface for the refuel module

The xxxx identification of the code can be any length, but it should be as short as possible while still being understandable. Four to seven letters is a really good number to keep the file names relatively short.

### xxxxhw.c

This file contains all the hardware dependent functions that interface directly to the hardware. If the hardware is changed, such as creating a new product or using a different processor with a different communications interface, only this file should need to be changed. This file contains the hardware abstraction layer.

Example: Let’s say you are implementing a serial port. This file may contain functions to write a byte to the serial port, read the serial port, poll the serial port to see if any data is available.

### xxxxintf.c

This file contains the higher level interface. It calls into the hardware abstraction layer, but provides higher level functions to enable easier processing. If no processing needs to be done at this layer, don’t just make a function that calls the HW function with the same passed parameters, but have the upper layer directly call the hardware abstraction layer. A function with no processing makes code that much more difficult to follow.

Example: Continuing with our serial port example, this file may contain functions to write to the serial port buffer, read from a serial port buffer if an end of message has been connected, and register callback functions. This file contains the helper functions to make communication easier.

### xxxxproc.c

This file contains the processing for the interface. It may call into the hardware abstraction layer or the interface layer depending on the type of interface.

Example: With the serial port, maybe a simple protocol is running on the serial port. Each serial port message has a start character, message, CRC8, and an end character. The processing module may provide the error checking to make sure that the message is valid before sending it to higher layers.

### xxxxintf.h

The interface file contains the interface to other modules in the system. This file shall contain all constants, function prototypes, and structures that are required to use functions from this module. Other modules include this file.

Example: If the shell module needs to communicate using the serial port, it would include the serintf.h file.

All include files should include all subfiles that they need to compile by themselves. This means that if serintf.h requires serport.h to be included before it is included, serintf.h should include a #include of serport.h.

### xxxxglob.h

The global file contains all the structures and defines that are needed by a single module. Only files from the xxxx module shall include this file. Files in a module first include their module interface file, then their module global file.

Example: serhw.c, serintf.c, and serproc.c include serglob.h to have access to information such as serial port state, registered callback functions, and transmit and receive buffers. The shell module that communicates with the serial port does not include serglob.h because all interface information that it needs is contained in serintf.h.

All include files should include all subfiles that they need to compile by themselves. This means that serglob.h requires serintf.h to be included before it is included, serglob.h should include a #include of serintf.h.

### xxxxyyyy.h

Some coders really like to make an included file for each code file that they generate. Files of the format xxxxyyyy.h shall not be created. This style confuses me to this day. If it is something that should be shared with other code within the module, include the information in the xxxxglob.h file. If it is code that should be shared to the world, include it in the xxxxintf.h file. By only having two files, one that is shared, and one that is private, all information can be quickly binned into the correct category. If it is not understood where a structure should be defined, first define it in the xxxxglob.h, and if necessary promote it to the xxxxintf.h file. When promoting a structure or a constant, continually re-evaluate your design and figure out if the code uses the correct architecture/design. Maybe the code should have been broken down differently, or maybe the interface isn’t as clean as it could be.

# Style Conventions

Style conventions help to make all code “look” the same. If two people use the same style, their code tends to look pleasant in their eyes. Style can also help to reduce common C coding bugs, such as adding a second statement to the body of an if statement and forgetting to add the curly braces.

## Generic style guidelines

### One statement per line

Only a single statement shall occur per a line. The only semicolons that should occur are at the end of a line unless within a for statement.

Bad example:

b = 13; b = 22; /* Two statements on a single line. */

### Stack variables

Stack variables, or a variable local to a function shall only be declared at the top of the function. Do not declare a variable within a block of the code or after the initial setup of the function. Most compilers now work properly, but it makes it nearly impossible to detect stack overflows. By declaring variables at the top of a function, the stack does not change unless calling other functions.

Bad example:

functionA(void)

{

U32 tmpA;

for (tmpA = 0; tmpA < MAX; tmpA++)

{

U32 tmpB; /* Wrong! Defines tmpB only for this loop */

/* More statements */

}

}

Good example:

functionB(void)

{

U32 tmpB; /* Define is at top of function */

/* More statements */

}

functionA(void)

{

U32 tmpA;

for (tmpA = 0; tmpA < MAX; tmpA++)

{

functionB();

U32 tmpB; /* Wrong! Defines tmpB only for this loop */

/* More statements */

}

}

### Indentation

No tabs shall be used in the code. Instead, tabs should be replaced using spaces. This forces all text editors to display the code in the same way. The tab stops should be set for 3 spaces. This means tab stops are in columns 4, 7, 10, etc.

## Line Length

Line lengths for C code should be a maximum of 80 characters.

## File Length

File lengths for C code should not exceed 4096 lines. See the discussion on K_FATAL why this limit exists. This limit can easily be increased to 8192 if a project contains less modules.

## Comments

Comments shall look as follows.

Example:

/* Single line comment */

functionA();

/* Multiple line comment because I have a really large amount of information

* that I feel that I need to convey to the reader of the code.

*/

functionB();

What about C++ style comments? C++ comments start with a // and go until the end of the line. These should be avoided for two reasons. Some code checkers (PC-lint) kick this style of comment out as a warning. This warning can be disabled, but it is questionable if using this style of comment really saves that much time. DO-178B doesn’t currently support this type of comment since ANSI-C doesn’t support it. I believe DO-178C does support this style of comments.

## Magic Numbers

No magic numbers shall be used. Instead of throwing random constants in the code, make sure that a define is used which helps identify what the number means.

Bad example:

for (tmpA = 0; tmpA < 32; tmpA++) /* What does 32 mean in this case? */

Good example:

#define MAX_PORTS 32

for (tmpA = 0; tmpA < MAX_PORTS; tmpA++) /* Oh yeah, it was the max number

* of ports

*/

The other good reason to do this is that now instead of searching the code for all occurrences of 32, you only need to change the value in a single place.

## Curly Braces

Each if, for, or while statement shall have a set of curly braces. The curly braces shall always appear on the next line at the left edge indented the same amount as the previous statement.

### if statements

If and else statement shall always use curly braces. This prevents adding a line of code, and forgetting to add the curly braces.

Examples:

if (a == b)

{

a = c;

}

else

{

a = d;

}

### while statements

Examples:

while (a < b)

{

a++;

}

do

{

a++;

} while (a < b);

### for statements

For statements shall always use curly braces. If all the processing is done on a single line, a comment contained within the curly braces should specifically note that no processing happens within the loop.

Examples:

for (a = 0; a < b; a++)

{

someFunction(a);

}

for (tmp_p = start_p; tmp_p != NULL; tmp_p = tmp_p->next_p)

{

/* Note: No statements needed */

}

The fact that no statements were required in the second for loop is explicitly spelled out in the comment so reviewers immediately know that this isn’t a bug.

### case statements

Case statements shall use curly braces for each case. If a case falls through to the next case, a comment explicitly stating this shall be included. A default case shall always be included to catch software bugs.

Examples:

switch (state)

{

case INIT_STATE:

{

/* Some processing */

break;

}

case START_STATE:

{

someFunction(a);

/* !! Fall through to next state to continue processing !! */

}

case RUNNING_STATE:

case TX_STATE:

{

/* More processing */

break;

}

default:

{

K_FATAL(state, etc);

}

}

## Function Style

Each function shall have a header associated with it. The header allows other coders to understand the code that they are calling. The header shall be just previous to the function, not in the header file. If the header is disjointed from the code there is that much more chance that it won’t be updated when the code is updated.

### file header

The following is an example of a header that shall be used for all files.

Example:

/*

*===============================================================================

*/

/**

* @file serproc.c

* @author Hugh Spahr

* @date 4/28/2014

*

* @note Project Name

* @note Copyright 2014, Hugh Spahr

*/

/* This program is free software: you can redistribute it and/or modify

* it under the terms of the GNU General Public License as published by

* the Free Software Foundation, either version 3 of the License, or

* (at your option) any later version.

*

* This program is distributed in the hope that it will be useful,

* but WITHOUT ANY WARRANTY; without even the implied warranty of

* MERCHANTABILITY or FITNESS FOR A PARTICULAR PURPOSE. See the

* GNU General Public License for more details.

*

* You should have received a copy of the GNU General Public License

* along with this program. If not, see <http://www.gnu.org/licenses/>.

*

*===============================================================================

*/

/**

* Serial processing contains functions to implement the serial port such as

* transmit and receive queuing. It allows multiple modules to register with

* a single physical serial port using different start of message bytes.

*/

/*===============================================================================

*/

Note @file, @author, @date, and @note. These are tags used by Doxygen to automatically create documentation. The “/**” construct allows Doxygen to pull out the description for the file. If the software is being developed for a company and is not open source, remember to delete the GPLv3 section of the file header.

### function header

The following is an example of a header that shall be used for all functions.

Example:

/*

* ===============================================================================

*

* Name: serproc_tx_data

*

* ===============================================================================

*/

/**

* Transmit serial data

*

* The transmit serial data puts the transmit data on the pending queue. If no

* space is available, an error is returned.

*

* @param buf_p [in] ptr to data to be transmitted

* @param len_p [in, out] ptr to num tx bytes, returns num sent bytes on fail

* @return SERI_SUCCESS if it works

* @return SERI_TX_BUF_OVF Tx buffer overflow

*

* @pre Serial port must be initialized

* @note None

*/

/* ===============================================================================

*/

SERI_ERR_E serproc_tx_data(

U8 *buf_p, /* data to be transmitted */

INT *len_p) /* num tx bytes, returns num bytes sent on fail */

{

/* Processing */

} /* End serproc_tx_data */

### function prototype

If a prototype of this function is included in a header file, the prototype should look as follows:

SERI_ERR_E serproc_tx_data(

U8 *buf_p, /* data to be transmitted */

INT *len_p); /* num tx bytes, returns num bytes sent on fail */

This allows the comments on the passed parameters to be saved. If the passed parameters are changed, it is very easy to copy the function prototype from the function declaration.

### function return values

If a function needs to return if it worked or not, the function shall return 0 for successful, and non-zero for failure. This allows much more information to be returned as to the reason that the call failed. By limiting yourself to a single value for a function failure, no error information can be returned.

# The Beloved/Despised K_FATAL

K_FATAL is simply a macro around the k_fatal function. The macro allows more context to be passed to k_fatal.

Coders shall use the beloved K_FATAL appropriately. I have argued with people time and time again about the value of K_FATAL. In the end, it has reduced integration time between modules significantly. It catches people miscalling other coder’s modules. It also catches errors in assumptions about modules. If a module only supports ten users, and suddenly twelve users are trying to register with it, K_FATAL. Catching this during code integration is much more powerful than returning an error code and hoping that the user propagates it to the appropriate level. This doesn’t allow users to ignore error codes being returned to them. It catches run away pointers. It catches people walking past the end of their data structures. Sometimes it points directly to the culprit. Other times, it forces the designer to dig into the code and find out what the problem is.

Create a K_FATAL for every project that you ever work on. It only takes a second, and it will save you time within the first couple of days of a project. The k_fatal function can be as simple as loop that never exits, to a logging function that logs the time, date, and location and stores it in non-volatile storage.

## Explanation of K_FATAL

K_FATAL is a macro that is called when something happens that should never occur. Let’s say that you have a state variable that can only be in state A, B or C. If a switch statement is used, and the state variable is another value such as D, K_FATAL. That is a state that should never have occurred.

K_FATAL should not be used if it is a simple error condition. If code tries to get memory, and it is handed back a NULL pointer, don’t call K_FATAL if you are too lazy to code the error case. Call K_FATAL if the code should never run out of memory.

If another module calls a function, and the passed parameters are bad, call K_FATAL. No K_FATAL should ever be called if bad information is passed from somebody typing on a keyboard. K_FATAL is not for bad user information; it is for capturing corrupted data, stopping code from running with bad parameters, etc.

## K_FATAL as a macro

Notice that K_FATAL is in all capital letters. It is a macro. (Hmmmm, it probably should be K_FATAL_M but it isn’t for historic reasons.) The reason is that it is a macro so that information about where it occurred can be included in the error log. Most compilers use __LINE__ to identify the line number in a C file. In this way, an error log can be created generated with the line number. Usually a module value and file value are also identified. These three pieces of information can be or’d together so that a 32 bit number uniquely. Usually 8 bits identify the module, 4 bits identify the file, and 12 bits identify the line number. This limits files to 4096 lines.

K_FATAL is typically passed in a number of parameters which give even more information about the error that occurred. Depending on the system and how large it is depends on how many parameters may be passed. I have seen systems where the number of parameters is not limited, but I have noticed diminishing returns after about three passed parameters.

Example:

/*

* ===============================================================================

*

* Name: K_FATAL

*

* ===============================================================================

*/

/**

* K_FATAL macro

*

* The K_FATAL macro halts the processor when an unrecoverable fault is detected.

*

* @param parm1 [in] first parameter

* @param parm2 [in] second parameter

* @param parm3 [in] third parameter

* @return None

*

* @pre None

* @note K_FATAL never returns

*

* ===============================================================================

*/

#define K_FATAL(parm1, parm2, parm3) \

{ \

k_fatal((MODULE << MODULE_SHIFT) | (FILE << FILE_SHIFT) | \

(__LINE__ & LINE_MASK), parm1, parm2, parm3); \

} /* End K_FATAL */

## Compiling out K_FATAL

Since K_FATAL should never be called, why bother compiling it out of the code? Nobody could ever possibly release software with latent bugs, could they? If a company has a piece of software that can’t run more than five or ten minutes without hitting a K_FATAL, that company does not have a product that should be released.

If you are working on a huge project where it is millions of lines of code, and you have characterized all of the K_FATAL occurrences such that they only occur infrequently, then release the software. Hitting a switch to disable all the K_FATALs just guarantees that a customer will not be able to give you that information if it is accessible. Customers will exercise your box in ways that you can never imagine. It is much easier to debug an issue where the box K_FATALs after 20,000 add and removes of a port instead of finding out that the port couldn’t allocate a pulse mask, and therefore is currently using a random location in memory for the pulse mask.

# Integrating COTS code

COTS (Commercial Off The Shelf) software should not be modified if at all possible. When a piece of COTS software comes in immediately save it in your repository without any changes whatsoever. Next study the code and find a way to integrate it into your code base with minimal changes. If you hate the style of code, tough! Your company paid for it, and as soon as you change it, it can’t be supported by the company where you purchased it. Only if you are willing to completely assimilate the code and support it yourself, should the code every go through significant modifications.

One way to minimize changes is to create an xxxxintf.h file to map information from the COTS software to the native code base. This is the best way since it doesn’t require any changes to the COTS code. Make sure that code isn’t copied from the COTS header files because the company may give you a new version of the code which changes these headers.

Another way to minimize changes to the COTS code is to create a shim layer. This can contain the filth from the COTS code to one or two files, so that it doesn’t start bleeding into your good code base. This may make it possible to create a library or incremental object so you don’t even need to bother with their strange build rules in your code base. If an incremental object is created, save the finished incremental object as part of your build and only reference it. This can further distance your code from the COTS code so their definition of TRUE and FALSE, YES and NO, doesn’t make it into your code.

# Standard Types

All projects will include the following standard types in the file procdefs.h:

U8, I8, U16, I16, U32, I32, INT, UINT, TRUE and FALSE.

Example of procdefs.h:

/*

*===============================================================================

*

* Joe’s Really Cool Company Banner

*

* @file: procdefs.h

* @author: Hugh Spahr

* @date: 4/28/2014

*

* @note: Project Name

* Copyright 2014, Company Name

* Company Address

*

*===============================================================================

*/

/**

* Processor definitions for the tms320f28xx DSP

*

*===============================================================================

*/

#ifndef PROCDEFS_H_

#define PROCDEFS_H_

typedef unsigned char U8;

typedef char I8;

typedef unsigned short U16;

typedef short I16;

typedef unsigned int U32;

typedef int I32;

typedef int INT;

typedef unsigned int UINT;

typedef enum

{

FALSE = 0,

TRUE = !FALSE,

} BOOL;

#endif /* PROCDEFS_H_*/

Why include INT and UINT? INT specifically states to me as a reviewer of your code that you specifically chose an integer because you don’t care what size it is. You are will to use whatever the native size of the processors.

Another reason to type define all of these is that the compiler can assist you in looking for errors in your code. If you want to simulate your code on let’s say a Linux box, or a windows box, all you have to do is change these definitions and you are up and running.

Here is a real life example. I was working on the 787 refueling system, and we only had one system that could run the code. I changed the procdefs.h file so that it could run on a windows box and started simulating the fueling system with less than three hours of work. The real system had no debugging capability, so they were using printf debugging. I was running on a windows box (MinW, gcc, gdb, and Eclipse CDT IDE) and used GDB to quickly find and locate bugs. The simulation environment ended up saving weeks of debugging time.

# Tools

PC lint, electric fence, running on a PC/Linux, Doxygen

Add section on array initialization, code inspections
