krayon/pinball-OPP/Eclipse/0202-HexMerge/HexMerge.odt

Hex Merge

Software Design Document

Project # : Not applicable

P/N: Not Applicable

Rev 1.2

| PREPARED: | APPROVAL: LEAD ENGINEER | APPROVAL: ENGINEERING MANAGER
NAME | Hugh Spahr
SIGNED
DATE

Revision Chart

Version | Primary Author(s) | Description of Version | Date Completed
0.1 | Hugh Spahr | Initial version | 10/17/2007
1.0 | Hugh Spahr | Updated for release. | 04/22/2008
1.1 | Hugh Spahr | Added smsrec option | 08/09/2010
1.2 | Hugh Spahr | Added appaddr option | 02/16/2011

# Purpose

Hex Merge is a command prompt utility that combines an application hex object file with a boot loader hex object file. The hex merge accepts S-Record format so Freescale parts can be supported. The programmer allows manufacturing to download a single image instead of individually downloading the boot loader and the application.

# Product Overview

Hex Merge will be used for all products that use the boot loader. It copies the data from the boot loader and application into the output hex or S-Record file.

# Applicable Documents

HCS08MiniBoot.odt - Bootloader documentation for Freescale microcontrollers

# Terms, Definitions & Acronyms

SDD Software Design Document

CRC Cyclic Redundancy Checksum

HEC Header Error Correction

ATM Asynchronous Transfer Mode

# System Design Description Overview

Hex Merge first reads in the passed parameters and verifies all the required flags are present or prints out the usage message if not present. It copies the boot object file into the output object file noting the size of the boot loader. It then reads in the application object file noting the start address, length, and CRC. It verifies the application doesn’t overwrite the boot code. It creates a hex record or s-record depending on file inputs to store application size, copies the application hex records, creates a checksum hex record, and stores configuration byte hex records into the output hex or output s-record file. Each of these pieces of processing is broken out into an individual function.

The CRC-8 used is the standard ATM CRC8 used as HEC. The generating polynomial is x^8+x^2+x+1 with an initial value of 0xff.

HexMerge calculates the CRC32 of the bootloader file, the application file, and the combined bootloader/application file. If HexMerge is operating on S-Record files the S0 record is not part of the CRC because it contains the build path. The generating polynomial is 0x04c11db7 with an initial value of 0xffffffff. The result is exclusive OR’d with 0xffffffff. When combining the bootloader and application files, only program memory that is used is included in the calculation.

# Major File and Data Structures

There is only one file and it is HexMerge.c. It is commented exceedingly well, so why not take the time and look at that if you are interested. Auto-generated documentation is available using doxygen.

# Supported flags

The –boot, -app, and –out flags are required if actually performing a merge. The -boot, and -crc32 flags can also be used to calculate the CRC32 of the bootloader without doing a merge.

## -?, not required

Prints out the usage message.

## –boot Filename, required

Input boot loader hex/s-record filename.

## –app Filename, required

Input application hex/s-record filename.

## –out Filename, required

Output hex/s-record filename.

## –crc32, not required

Output the CRC32 of the bootloader. This option requires the –boot Filename option to also be used.

## –sn serialNumber, not required

Output the CRC32 of the bootloader. This option requires the –boot Filename option to also be used.

## –sectsize sectorSize, not required

Input the sector size for a Freescale processor. Sector size defaults to 0x300.

## –smsrec fileName, not required

Output a small Srec application file that only has eight bytes of data per S-record. This can be used to upgrade remote applications that support the bootloader.

## –appaddr address, not required

Input the location of the start of the application. This option is used for Coldfire based bootloader/applications. It contains the address of the start of the application table so that the length of the application can be found.

# Examples

HexMerge –boot 18F6620boot.hex –app application.hex –out applicationBoot.hex

Merge the 18F6620boot.hex file with the application.hex file and form the applicationBoot.hex (bootable hex file).

HexMerge –boot bootload.asm.60k.sx –app application.abs.s19 –out applicationBoot.s19

Merge the bootload.asm.60k.sx file with the application.abs.s19 file and form the applicationBoot.s19 (bootable hex file). In this case, the bootloader is configured for a processor with 60k of program memory.

HexMerge –crc32 –boot bootload.asm.60k.sx

Print the CRC32 of the bootloader.

HexMerge –boot HCS08MiniBoot.asm.16k.sx –app 38000.sx –out 38000Boot.sx –sn 1234 -sectsize 0x200

Merge the HCS08MiniBoot.asm.16k.sx file with the 38000.sx file and form the 38000Boot.sx (bootable hex file). The serial number of 1234 is stored at the beginning of the bootloader image. In this case, the bootloader is configured for a processor with 16k of program memory. The sector size is set to 512 bytes.

HexMerge –app 10001.elf.s19 –out 10001.crc.s19 –appaddr 0x4000

Add the CRC32 of the application to the 10001.crc.s19 output file. Note: The bootloader is already contained in the Coldfire application file. This also outputs the CRC32 of the bootloader and the entire image.

# Appendix

No supporting documentation.

Hex Merge Page 7 Software Design Document – Rev 1.2 February 16, 2011

Copyright © 2011 Hugh Spahr
