krayon/pinball-OPP/CodeWarrior8bit/0103-HcsMiniBoot/HCS08MiniBootloader.odt

HCS08 Mini Bootloader

Software Design Document

Project # : Not applicable

P/N: Not Applicable

Rev 0.2

This program is free software: you can redistribute it and/or modify it under the terms of the GNU General Public License as published by the Free Software Foundation, either version 3 of the License, or (at your option) any later version.

This program is distributed in the hope that it will be useful, but WITHOUT ANY WARRANTY; without even the implied warranty of MERCHANTABILITY or FITNESS FOR A PARTICULAR PURPOSE. See the GNU General Public License for more details.

You should have received a copy of the GNU General Public License along with this program. If not, see <http://www.gnu.org/licenses/>.

| PREPARED: | APPROVAL: LEAD ENGINEER | APPROVAL: ENGINEERING MANAGER
NAME | Hugh Spahr
SIGNED
DATE

Revision History

Version | Primary Author(s) | Description of Version | Date Completed
0.2 | Hugh Spahr | Initial version | July 30, 2009

# Purpose

HCS08 Mini Boot provides boot loader functionality for the HCS08 family of Freescale microcontrollers. The main features include:

1. Verifying the integrity of the application code before starting
2. Providing a serial interface to allow reading and writing program memory
3. Transmitting a boot version message if the application is corrupted
4. Remap the interrupt vectors from boot area of flash to application

# Product Overview

When a product using HCS08 Mini Boot first boots, it verifies that the size of the application code is valid. If the size is valid, a CRC-8 is performed over the application code to insure the integrity of the application. If the CRC-8 matches the CRC-8 found at the end of the code, the application is started. If not, a boot version message is transmitted out the serial port, and boot command mode is entered. Boot command mode accepts read program memory, write program memory, transmit boot version, and reset commands.

# Applicable Documents

None

# Terms, Definitions & Acronyms

SDD Software Design Document

STX Start of transmission

CRC Cyclic Redundancy Checksum

HEC Header Error Correction

ATM Asynchronous Transfer Mode

# System Design Description Overview

HCS08 Mini Boot uses a simple command/acknowledge protocol. All the intelligence and timeouts are included in the host application to keep the boot loader as simple as possible. If a command needs to be canceled a string of STX bytes can be sent to clear the current command. For example, the boot loader will wait indefinitely to receive all the bytes in a message. It is up to the host to recognize that a response has not been received, and to flush the command and retransmit it.

HCS08 Mini Boot requires the application to support the following memory map:

------------------- Application (Start of flash to 0xfc00)

| offset = 0x00 | Length of application (4 bytes)

| offset = 0x04 | Remapped vector table (3 bytes per vector for jmp inst)

| offset = 0x61 | Re-mapped reset vector (start of application address)

| offset = 0x64 | Remaining application

|offset = appLen | App CRC (Start of flash + appLength)

|offset = appLen+1| End marker (Start of flash + appLength + 1) 0xa5

------------------- Bootloader (0xfc00)

| 0xfc00 | Serial Number (Filled out by HexMerge.exe)

| 0xfc10 | Bootloader code

| 0xffc0 | Boot intrpt vectors, point to remapped vector table

| 0xfffe | Boot vector (goes boot start address)

Message integrity is guaranteed using a CRC-8. The generating polynomial is x^8+x^2+x+1 with an initial value of 0xff. This is the standard ATM CRC8 used as HEC. The CRC is only included to insure data integrity when needed.

# Major File and Data Structures

There is only one file and it is HCS08MiniBoot.asm. It is commented exceedingly well, so why not take the time and look at that if you are interested.

# Build Instructions

Build instructions are located in the subversion repository as build_notes.txt.

# Message Protocol

## Write program memory (Cmd 0x00)

Write 8 bytes of data to program memory.

Cmd: <STX><0x00><ADDRU><ADDRH><ADDRL><DATA[0..7]><CRC8>

Resp: <STX><0x00><ADDRU><ADDRH><ADDRL>

Verify that address is below the boot loader (address 0xfc00). Verify the CRC8 is correct. If either error occurs, go back to looking for another command. If this write is on a 512 byte boundary, erase the flash memory first. Write the data to the flash memory. Send the response.

Note: All writes to flash must be 8 byte aligned. This is guaranteed by the host and not checked here.

## Read program memory (Cmd 0x01)

Read 8 bytes of data from program memory.

Cmd: <STX><0x01><ADDRU><ADDRH><ADDRL>

Resp: <STX><0x01><ADDRU><ADDRH><ADDRL><DATA[0..7]><CRC8>

Read the data from flash, calculate the CRC8 and put in response message. Send the response.

## Write EEPROM memory (Cmd 0x02)

This command is unimplemented in the Freescale Mini bootloader

## Read EEPROM memory (Cmd 0x03)

This command is unimplemented in the Freescale Mini bootloader

## Write Config Bits (Cmd 0x04)

This command is unimplemented in the Freescale parts

## Get boot version (Cmd 0x05)

Request the boot version. This command is used to verify that the host is connected to the target.

Cmd: <STX><0x05>

Resp: The string “Boot0.0\r”

Send the boot version string.

## Reboot (Cmd 0x80)

Reboot the target. If the application CRC is correct, no response is expected.

Cmd: <STX><0x80>

Resp: None

# Required Application Changes

The following changes to the application are required. They allow debugging to occur transparently.

Add bootload.app.asm, version.h, interrupt.h, and projintrpts.h to the application project file. These files can be found in the HCS08MiniBoo project build. At the beginning of the bootload.app.asm file, verify the ROMStart and RAMEnd addresses are correct for the processor. Change the Build Options for the compiler/assembler. Choose Edit->Standard Settings and add –DDEBUG=0 to command line arguments for both the compiler and assembler. To debug the code, set these flags to 1 so that a monolithic bootload/application file is created.

In the main C code file, include the following lines:

#include "version.h"

#define INTERRUPT_INSTANTIATE

#include "interrupt.h"

Within the projintrpts.h file, define the interrupts that are used. The POPULATED_INTS bitfield defines can be found at the top of the interrupt.h file. For each interrupt define a prototype, and create a #define for the correct vector number. An example for the timer 1 overflow interrupt is contained in the example file.

Change the version.h file to contain the current version of the software. In the interrupt.h file, change the location of the appStart table to the address at the beginning of ROM. In the project.prm file, change the start of ROM to start of ROM + 0x70. This reserves the 0x70 bytes for size of the application and the application vector table.

The last piece of code is to look for the ‘Z’ character to go back to boot the boot loader. Add the following code to the serial port handler:

#define BOOT_MODE_CHAR 'Z' // Boot mode character (force back to boot)

/* Check if being forced back to boot mode */

if (rcvChar == BOOT_MODE_CHAR)

{

forceBootMode();

}

The code itself:

/*

* ===============================================================================

*

* Name: forceBootMode

*

* ===============================================================================

*/

/**

* Force boot loader

*

* Write a 0xa5 at the beginning of RAM and reset processor.

*

* @param None

* @return None (resets processor)

*

* @pre None

* @note None

*

* ===============================================================================

*/

void forceBootMode(void)

{

#define MAGIC_NUM 0xa5

#define RAM_FIRST_ADDR 0x80

/* Write the magic number */

*(U8 *)RAM_FIRST_ADDR = MAGIC_NUM;

/* Reset the processor */

asm DCB 0x8D ; /* Use illegal instruction to cause reset */

}/* End forceBootMode */

# Appendix

No supporting documentation.

HCS08 Mini Bootloader Page 9 Software Design Document – Rev 0.2 July 30, 2009

Copyright © 2009 Hugh Spahr
