krayon/pinball-OPP/MPF/SS3/images/sal_empty.jpg

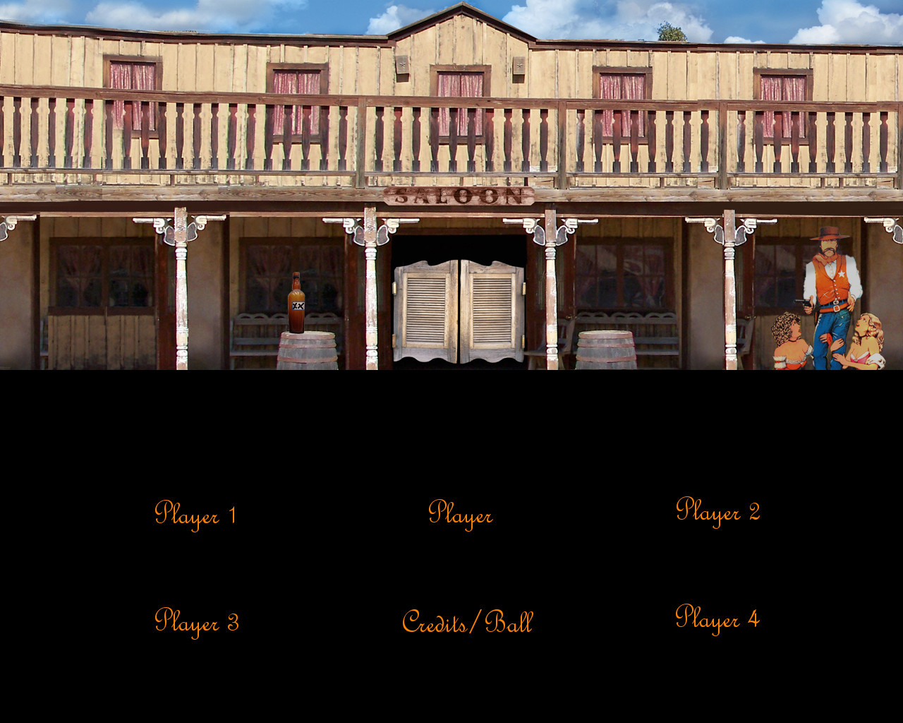
MPF/SS3/images/sal_empty.jpg
