krayon/pinball-OPP/MPF/SS3/images/sal_guy.jpg

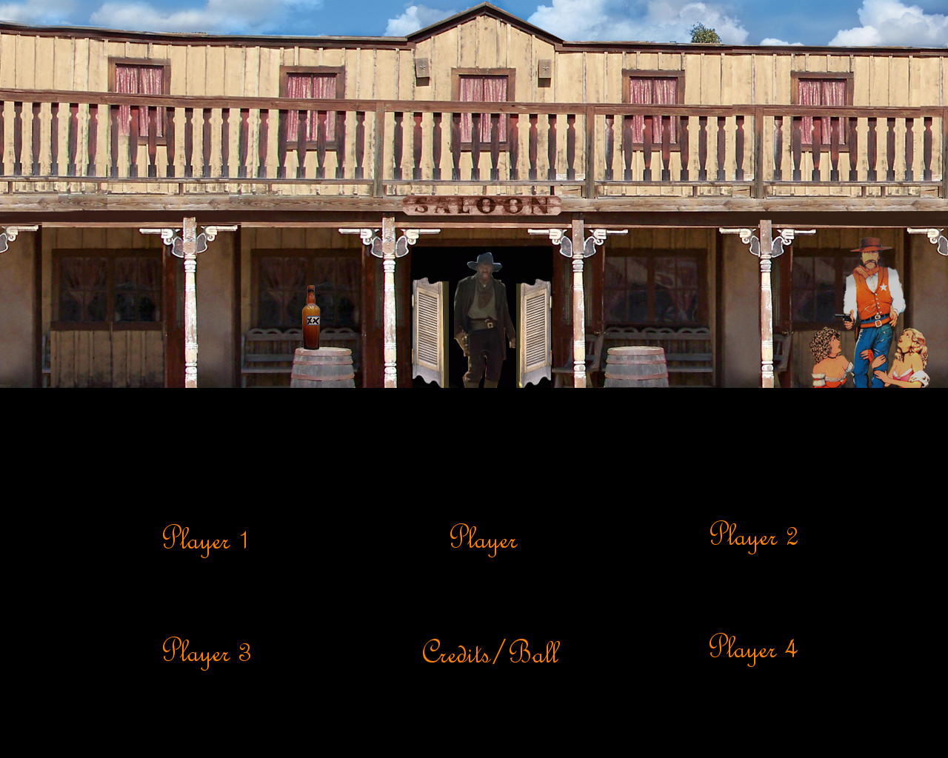
MPF/SS3/images/sal_guy.jpg
