krayon/pinball-OPP/Python/PinballFramework/BlueOct/graphics/full_bgnd_image.jpg

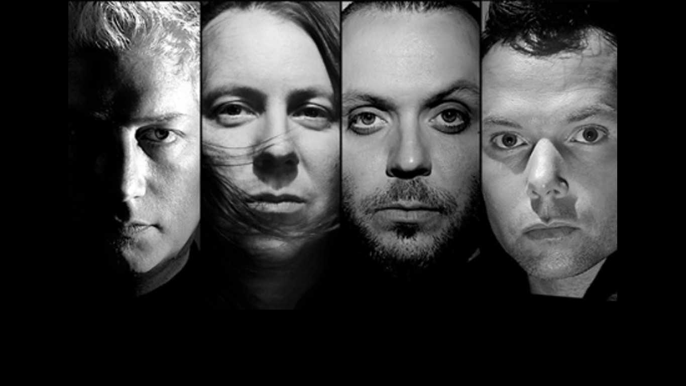
Python/PinballFramework/BlueOct/graphics/full_bgnd_image.jpg
