krayon/pinball-OPP/Python/PinballFramework/BlueOct/graphics/left_guy.jpg

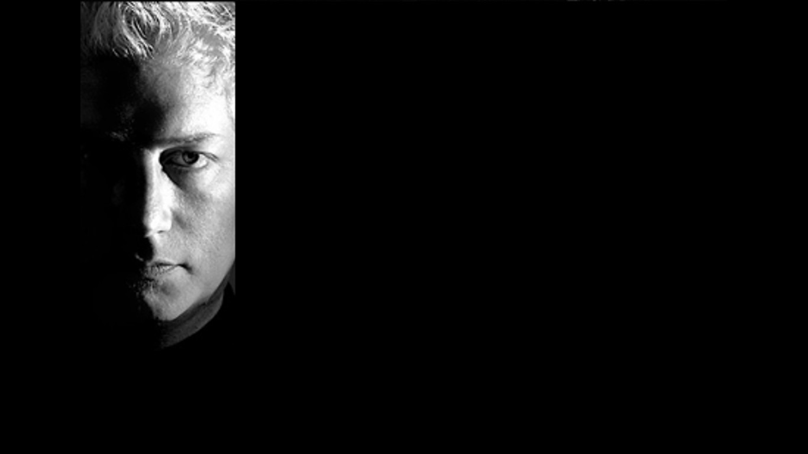
Python/PinballFramework/BlueOct/graphics/left_guy.jpg
