krayon/pinball-OPP/Python/PinballFramework/BlueOct/graphics/lftctr_guy.jpg

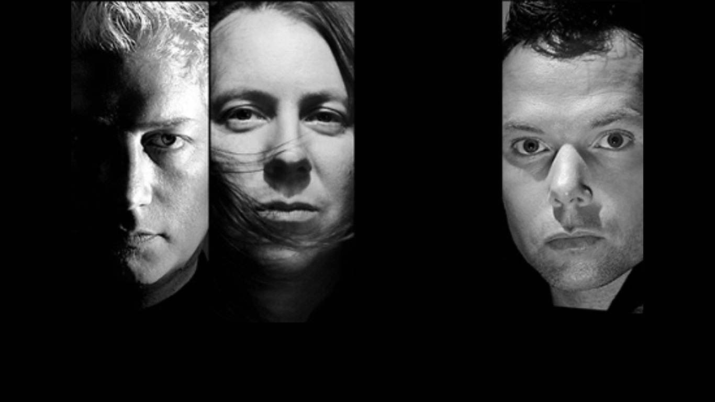
Python/PinballFramework/BlueOct/graphics/lftctr_guy.jpg
