krayon/pinball-OPP/Python/PinballFramework/VH/graphics/attract_mode.jpg

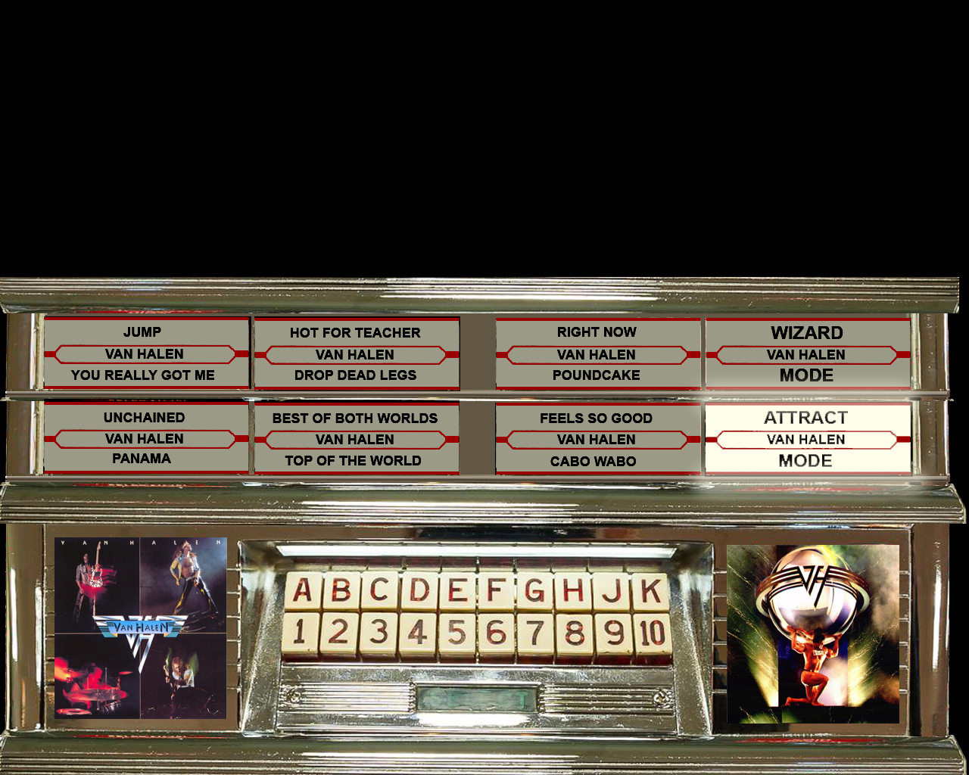
Python/PinballFramework/VH/graphics/attract_mode.jpg
