krayon/pinball-OPP/Python/PinballFramework/VH/graphics/best_of_both_worlds.jpg

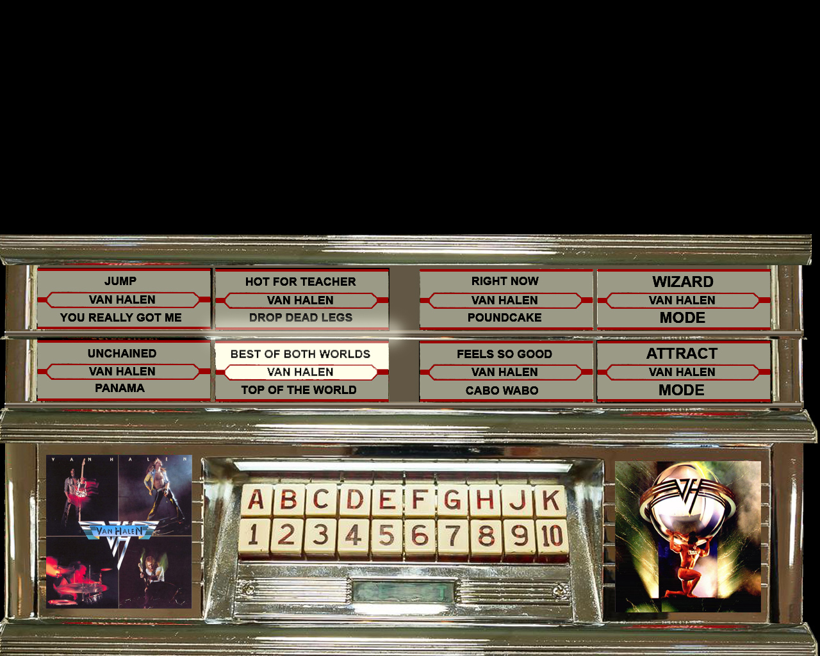
Python/PinballFramework/VH/graphics/best_of_both_worlds.jpg
