krayon/pinball-OPP/Python/PinballFramework/VH/graphics/chooseDavid.jpg

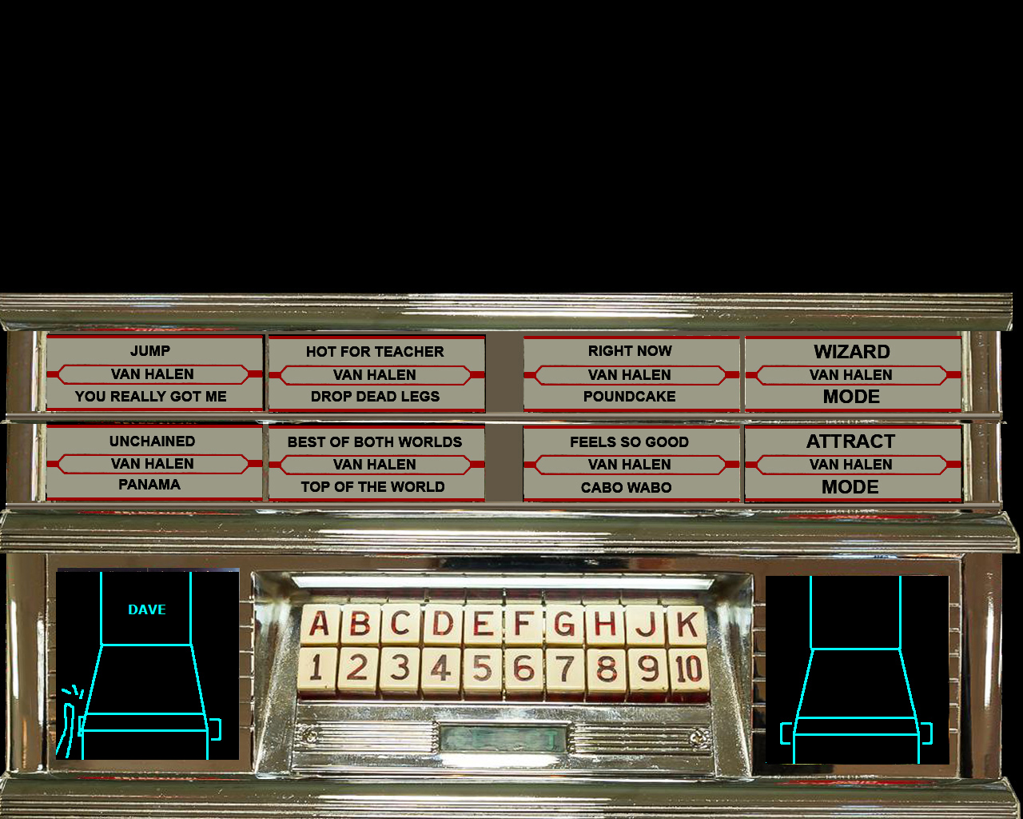
Python/PinballFramework/VH/graphics/chooseDavid.jpg
