krayon/pinball-OPP/Python/PinballFramework/VH/graphics/feels_so_good.jpg

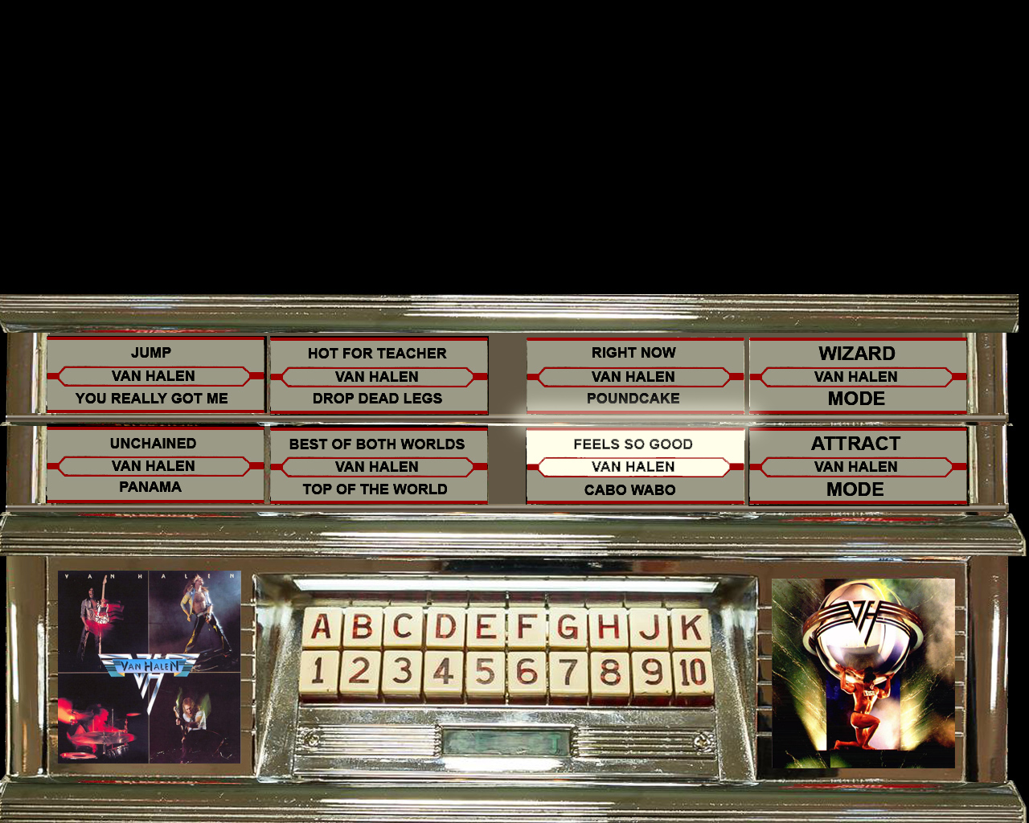
Python/PinballFramework/VH/graphics/feels_so_good.jpg
