krayon/pinball-OPP/Python/PinballFramework/VH/graphics/panama.jpg

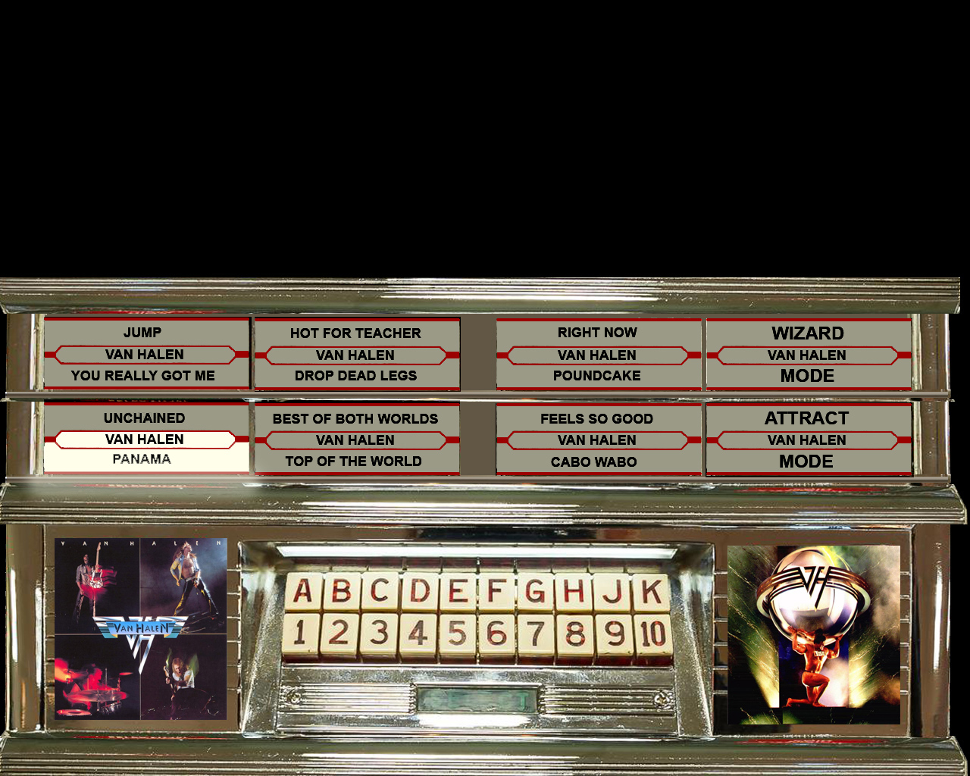
Python/PinballFramework/VH/graphics/panama.jpg
