krayon/pinball-OPP/CodeWarrior8bit/oppBrdCost.ods

Part | Cost/Part | Num Parts | Total
RS232 interface card
1 uF cap | $0.20 | 5 | $1.00
Max232 | $1.15 | 1 | $1.15
4pin hdr | $0.17 | 1 | $0.17
DB9 | $0.64 | 1 | $0.64
Solenoid Driver Card
10 uF cap | $0.28 | 1 | $0.28
MC9S08SE8 | $1.83 | 1 | $1.83
2 pin hdr | $0.07 | 10 | $0.70
4 pin hdr | $0.17 | 2 | $0.34
mtg hdw | $0.25 | 4 | $1.00
Spade term | $0.07 | 10 | $0.70
3.3K resist | $0.03 | 2 | $0.06
6 pin hdr | $0.14 | 1 | $0.14
MOSFETs | $0.80 | 8 | $6.40
PCB | $1.00 | 1 | $1.00
Input Card
10 uF cap | $0.28 | 1 | $0.28
MC9S08SE8 | $1.83 | 1 | $1.83
2 pin hdr | $0.07 | 18 | $1.26
4 pin hdr | $0.17 | 2 | $0.34
mtg hdw | $0.25 | 3 | $0.75
Spade term | $0.07 | 10 | $0.70
3.3K resist | $0.03 | 2 | $0.06
6 pin hdr | $0.14 | 1 | $0.14
PCB | $1.00 | 1 | $1.00
Cables
Sol Cable | $0.15 | 8 | $1.20
Sol input wire crimp | $0.10 | 8 | $0.80
Sol input wire housing | $0.06 | 8 | $0.48
Switch input crimp | $0.10 | 16 | $1.60
Switch input housing | $0.06 | 16 | $0.96
Brd interconnect crimps | $0.10 | 20 | $2.00
Brd interconnect housings | $0.14 | 5 | $0.70
PCB | $1.00 | 1 | $1.00
Mouser Shipping | $3.00 | 1 | $3.00
Total |  |  | $33.51
