krayon/pinball-OPP/Docs/BulbMeasurements.ods

Bulb Type | Manufacturer (Pinball Life) | Voltage (V) | Current (mA) | Cost/1
44 |  | 5.0 | 220 | $0.15
44 |  | 6.3 | 249 | $0.15
44 |  | 7.5 | 274 | $0.15
44 |  | 9.0 | 310 | $0.15
44 |  | 10.0 | 322 | $0.15
44 |  | 11.0 | 341 | $0.15
47 |  | 5.0 | 136 | $0.15
47 |  | 6.3 | 154 | $0.15
White Frosted LED | Ablaze 1 LED Frosted Lens | 5.0 | 17 | $0.39
White Frosted LED | Ablaze 1 LED Frosted Lens | 6.3 | 43 | $0.39
Blue Frosted LED | Ablaze 1 LED Frosted Lens | 5.0 | 16 | $0.39
Blue Frosted LED | Ablaze 1 LED Frosted Lens | 6.3 | 40 | $0.39
Orange Frosted LED | Ablaze 1 LED Frosted Lens | 5.0 | Not enough power | $0.39
Orange Frosted LED | Ablaze 1 LED Frosted Lens | 6.3 | 5 | $0.39
Green 4 SMD LED | Ablaze 4 SMD LED | 5.0 | 35 | $0.89
Green 4 SMD LED | Ablaze 4 SMD LED | 6.3 | 77 | $0.89
Blue 4 SMD LED | Ablaze 4 SMD LED | 5.0 | 29 | $0.89
Blue 4 SMD LED | Ablaze 4 SMD LED | 6.3 | 75 | $0.89
Red 4 SMD LED | Ablaze 4 SMD LED | 5.0 | 34 | $0.89
Red 4 SMD LED | Ablaze 4 SMD LED | 6.3 | 59 | $0.89
White 4 SMD LED | Ablaze 4 SMD LED | 5.0 | 30 | $0.89
White 4 SMD LED | Ablaze 4 SMD LED | 6.3 | 76 | $0.89
