krayon/pinball-OPP/CodeWarrior8bit/1003-InpDrv/build_notes.txt

In the following instructions replace xxxxxx with the project name.  For example, if
the project name is application, the project file for CodeWarrior is application.mcp.

1.  Create a directory that is going to contain the application files.

2.  Highlight the directory, right-click,TortoiseSVN->Export.  Under URL of repository:
Choose https://open-pinball-project.googlecode.com/svn/tag/tagxx.yy.xx/CodeWarrior8bit/1003-InpDrv
where xx is major revision, yy is minor revision, and zz is engineering revision.
This extracts all the files from the repository.

3.  Browse to the MiniBoot repository,
https://open-pinball-project.googlecode.com/svn/trunk/CodeWarrior8bit/0103-HcsMiniBoot/bin/HCS08MiniBoot.asm.slow.8k.sx
Save Link As... and save it into the xxxxxx\bin directory that was just created.

4.  If HexMerge.exe isn't installed, browse to the subversion repository,
https://open-pinball-project.googlecode.com/svn/trunk/Eclipse/0202-HexMerge/Debug/HexMerge.exe
(right-click) Save Link As... and save it into the c:\WINDOWS\system32.  Rev 1.2 is the current version.

5.  Start CodeWarrior IDE

6.  Under File->Open... Browse to the directory and choose xxxxxx.mcp

7.  Project->Make

8.  The linker will output a file called xxxxxx.sx in the "project\bin" directory.

9.  Open a command prompt and change the directory to the project directory.

10. Run "build.bat".  This will create "xxxxxxBoot.sx which contains the bootloader
and the application code, and "xxxxxxUpgrade.sx" which contains S records for upgrading
a input controller.

Version		Proc		StdLib		Upgrade CRC32	App CRC32	Image CRC32	Notes:
00.00.01	MC9S08SE08	00.00.05	0xdce94158	0xb9d49d83	0x7bd99710	Initial version
00.00.02	MC9S08SE08	00.00.05	0x75f80832	0x793e63c	0xbeee3835	Fix location of APP_TABLE.  Processor should use small memory model.
00.00.03	MC9S08SE08	00.00.05	0xbf273823	0xb279f41b	0x6d1f334e	Change osc to slow.  Fix addr compare to use input card.
00.00.04	MC9S08SE08	00.00.05	0xefbc1f05	0x9884ac80	0x7c69081c	Updated bootloader for slow clock.
00.00.06	MC9S08SE08	00.00.05	0x0776c0a1	0x7b9c478e	0x0c9809c1	Initialize stateMask so rise/fall edge inputs work
