krayon/pinball-OPP/Eclipse/1009-HostCtl/build_notes.txt

Program arguments:
-debug -com=COM1 -scrSize=FULL -rules=rules/simplerules.txt

VM arguments:
-Djava.library.path=lib -Djna.library.path=lib

Set VLC_PLUGIN_PATH to C:\Program Files\VideoLAN\VLC\plugins
