krayon/pinball-OPP/Kicad/1017-IncandSMG2/1017.kicad_pcb

## KiCad design Kicad/1017-IncandSMG2/1017.kicad_pcb (2020-02-25)

Schematic: 1017.sch, Surface Mount Incandescent Driver (Gen 2)

Parts:
P1, P3: CONN_4; Manufacturer PN 68001-436HLF
P2, P7: CONN_8
P4: SPADE_187; Manufacturer PN 1285
P5: CONN_2
P6: TST
Q1, Q2, Q3, Q4, Q5, Q6, Q7, Q8, Q9, Q10, Q11, Q12, Q13, Q14, Q15, Q16, Q17, Q18, Q19, Q20, Q21, Q22, Q23, Q24: MOSFET_N; Manufacturer PN 2N7000TA
R1, R2, R3, R4, R5, R6, R7, R8: 10K

Connections:
+5V: P1.3, P3.3
+12V1: P1.2, P3.2, R1.2, R2.2, R3.2, R4.2, R5.2, R6.2, R7.2, R8.2
+VLED: P1.1, P3.1, P4.1, P4.2, P5.1, P5.2 (PM), Q1.D, Q2.D, Q3.D, Q4.D, Q5.D, Q6.D, Q7.D, Q8.D, Q17.S, Q18.S, Q19.S, Q20.S, Q21.S, Q22.S, Q23.S, Q24.S
/P0: P2.1, Q9.G, Q17.G
/P1: P2.2, Q10.G, Q18.G
/P2: P2.3, Q11.G, Q19.G
/P3: P2.4, Q12.G, Q20.G
/P4: P2.5, Q13.G, Q21.G
/P5: P2.6, Q14.G, Q22.G
/P6: P2.7, Q15.G, Q23.G
/P7: P2.8, Q16.G, Q24.G
GND: P1.4, P3.4, Q9.S, Q10.S, Q11.S, Q12.S, Q13.S, Q14.S, Q15.S, Q16.S
unnamed: Q2.G, Q10.D, R2.1
unnamed: P7.8, Q8.S, Q24.D
unnamed: P7.7, Q7.S, Q23.D
unnamed: P7.6, Q6.S, Q22.D
unnamed: P7.5, Q5.S, Q21.D
unnamed: P7.4, Q4.S, Q20.D
unnamed: Q7.G, Q15.D, R7.1
unnamed: Q5.G, Q13.D, R5.1
unnamed: P7.2, Q2.S, Q18.D
unnamed: P7.1, Q1.S, Q17.D
unnamed: Q1.G, Q9.D, R1.1
unnamed: P7.3, Q3.S, Q19.D
unnamed: Q8.G, Q16.D, R8.1
unnamed: Q6.G, Q14.D, R6.1
unnamed: Q4.G, Q12.D, R4.1
unnamed: Q3.G, Q11.D, R3.1

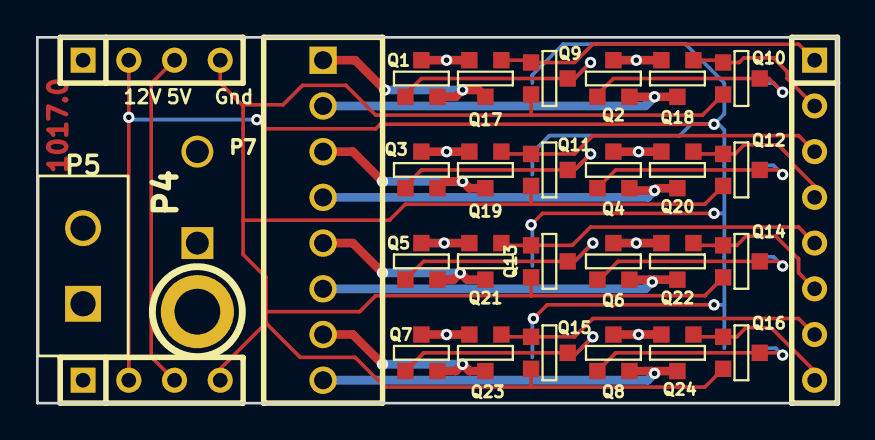
[picture p87: board 1017.kicad_pcb from above]

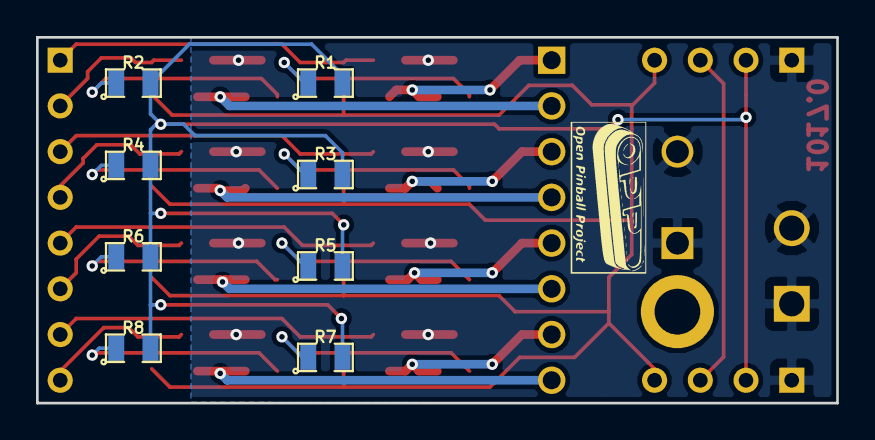
[picture p88: board 1017.kicad_pcb from below]

Board: 2 copper layers, 44.4 x 20.3 mm, 40 parts (8 on the bottom side), 28 nets.

Other parts of the board:
VAL: REF; opp_logo_backsilk
