krayon/pinball-OPP/Kicad/1014-IncandBrdG2/1014.kicad_pcb

## KiCad design Kicad/1014-IncandBrdG2/1014.kicad_pcb (2020-02-25)

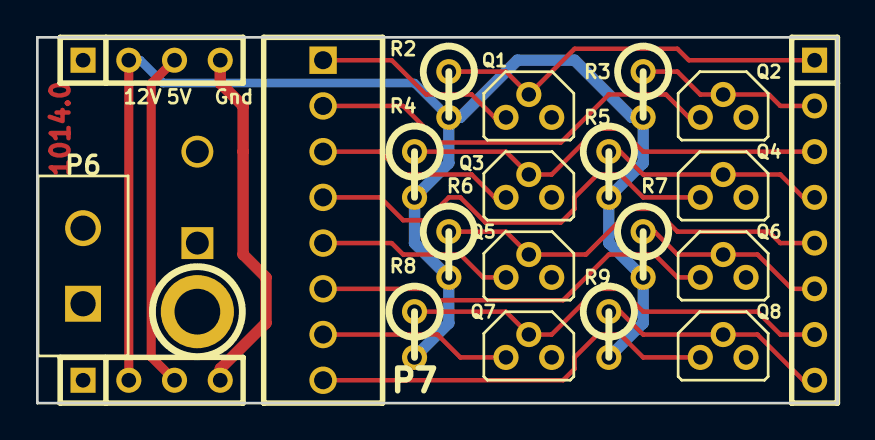
[picture p89: board 1014.kicad_pcb from above]

Board: 2 copper layers, 44.4 x 20.3 mm, 24 parts (0 on the bottom side), 20 nets.

Parts:
P1: TST; 00_mtg_hole-2-56
P2, P3: CONN_4; SIL-4
P4: SPADE_187; 00_th1x2x200
P5: CONN_8; SIL-8
P6: CONN_2; 00_th1x2x4.2mm_cheap
P7: CONN_8; 00_th1x8x100-lock
Q1, Q2, Q3, Q4, Q5, Q6, Q7, Q8: MOSFET_N; 00_to92_sgd
R2, R3, R4, R5, R6, R7, R8, R9: 10K; R1
VAL: REF; opp_logo_backsilk

Connections:
+5V: P2.3, P3.3
+12V1: P2.2, P3.2, R2.2, R3.2, R4.2, R5.2, R6.2, R7.2, R8.2, R9.2
+VLED: P2.1, P3.1, P4.1, P4.2, P6.1, P6.2, Q1.D, Q2.D, Q3.D, Q4.D, Q5.D, Q6.D, Q7.D, Q8.D
/P0: P5.1, Q1.G, R2.1
/P1: P5.2, Q2.G, R3.1
/P2: P5.3, Q3.G, R4.1
/P3: P5.4, Q4.G, R5.1
/P4: P5.5, Q5.G, R6.1
/P5: P5.6, Q6.G, R7.1
/P6: P5.7, Q7.G, R8.1
/P7: P5.8, Q8.G, R9.1
GND: P2.4, P3.4
unnamed: P7.3, Q3.S
unnamed: P7.1, Q1.S
unnamed: P7.2, Q2.S
unnamed: P7.4, Q4.S
unnamed: P7.5, Q5.S
unnamed: P7.6, Q6.S
unnamed: P7.7, Q7.S
unnamed: P7.8, Q8.S
