krayon/pinball-OPP/Kicad/1018-PwrFilter/1018.kicad_pcb

## KiCad design Kicad/1018-PwrFilter/1018.kicad_pcb (2020-02-25)

Schematic: 1018.sch, Power Filter

Parts:
C1, C2, C3: CP1
D1, D2: LED
P1, P8, P9: CONN2X3MOLEX
P4, P7, P11, P12, P13, P14, P15, P16: TST
P10: CONN_6
Q1, Q2: MOSFET_P
R1, R2, R3, R6, R7, R8: 100K
R4, R5: 900K
TH1, TH2: THERMISTOR

Connections:
+48V1: P1.4, P1.5, P7.1, TH2.1
+48V2: P1.6, P4.1, TH1.1
GND1: C2.2, C3.2, D2.2 (K), P1.1, P1.2, P9.1, P9.2, P9.3, P10.1, P16.1, R8.1
GND2: C1.2, D1.2 (K), P1.3, P8.1, P8.2, P8.3, P10.6, P15.1, R7.1
unnamed: D2.1 (A), R6.1
unnamed: D1.1 (A), R3.1
unnamed: C1.1, Q1.S, R1.2, TH1.2
unnamed: P9.4, P9.5, P9.6, Q2.D, R5.2, R6.2
unnamed: P8.4, P8.5, P8.6, Q1.D, R3.2, R4.2
unnamed: P10.2, Q2.G, R2.1
unnamed: P10.5, Q1.G, R1.1
unnamed: P10.4, R4.1, R7.2
unnamed: P10.3, R5.1, R8.2
unnamed: C2.1, C3.1, Q2.S, R2.2, TH2.2

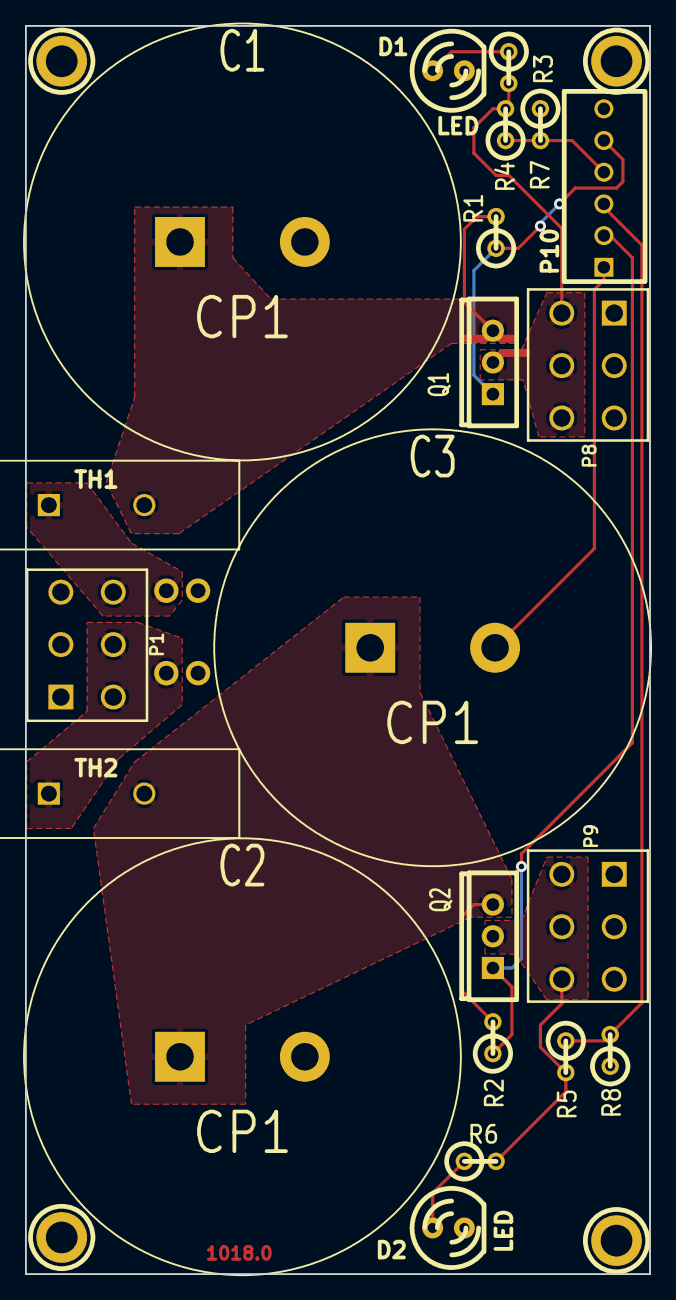
[picture p90: board 1018.kicad_pcb from above]

Board: 2 copper layers, 50.0 x 100.0 mm, 30 parts (0 on the bottom side), 14 nets.

Other parts of the board:
VAL: REF; opp_logo_backsilk
