krayon/pinball-OPP/Kicad/1016-IntfBrdG2/1016.kicad_pcb

## KiCad design Kicad/1016-IntfBrdG2/1016.kicad_pcb (2020-02-25)

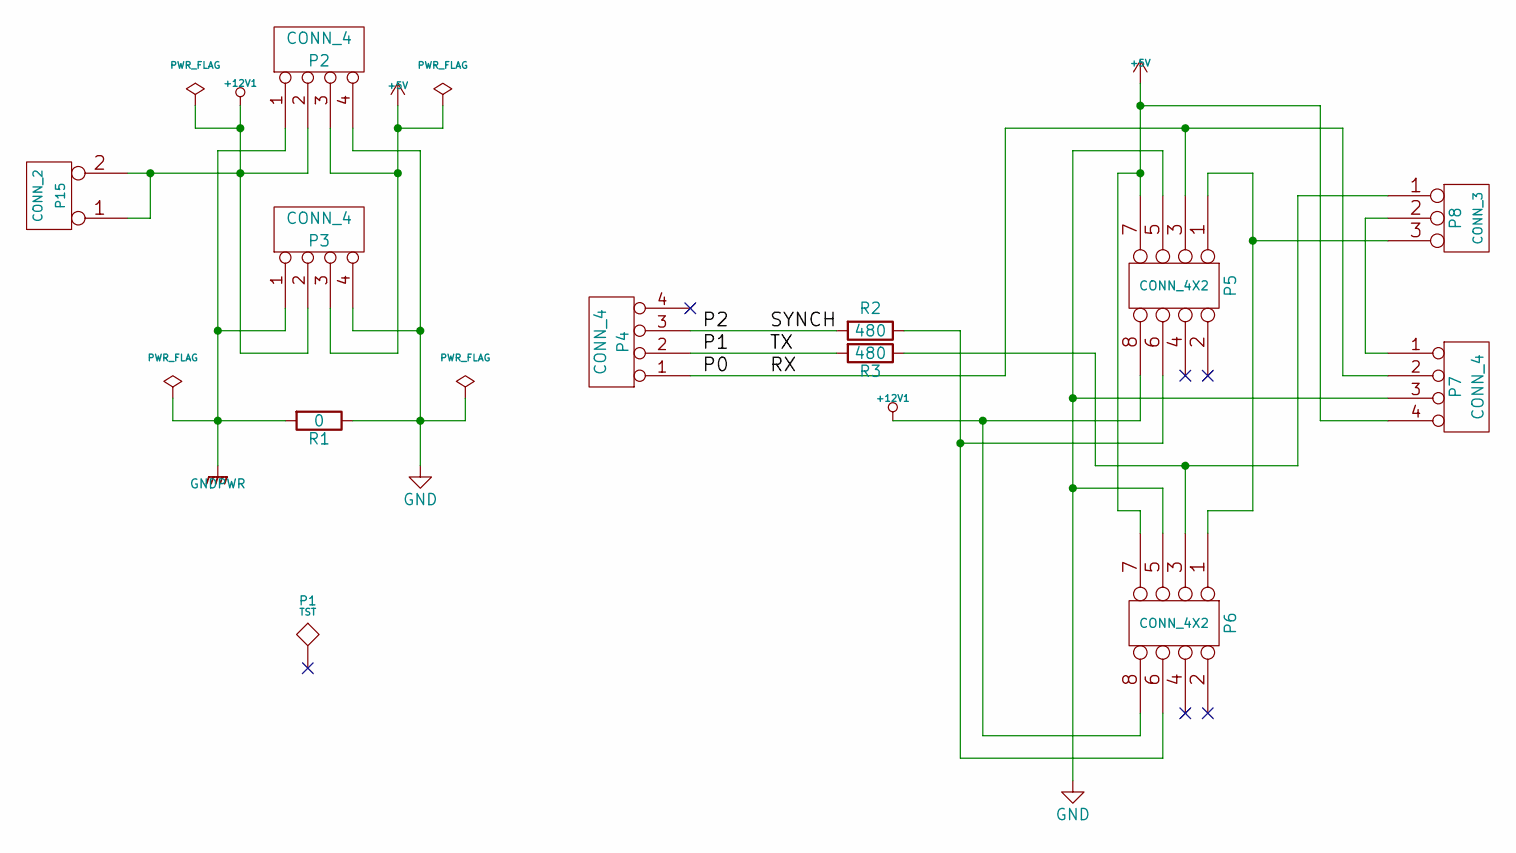
[picture p91: schematic 1016.sch, Interface Board (Gen 2)]

Parts:
P1: TST
P2, P3, P4, P7: CONN_4; Manufacturer PN 68001-436HLF
P5, P6: CONN_4X2
P8: CONN_3
P15: CONN_2
R1: 0
R2, R3: 480

Connections:
+5V: P2.3, P3.3, P5.7, P6.7, P7.4
+12V1: P2.2, P3.2, P5.8, P6.8, P15.1, P15.2 (PM)
/P0: P4.1, P5.3, P7.2
/P1: P4.2, R3.2
/P2: P4.3, R2.2
GND: P2.4, P3.4, P5.5, P6.5, P7.3, R1.1
GNDPWR: P2.1, P3.1, R1.2
unnamed: P6.3, P8.1, R3.1
unnamed: P7.1, P8.2 (PM)
unnamed: P5.1, P6.1, P8.3
unnamed: P5.6, P6.6, R2.1

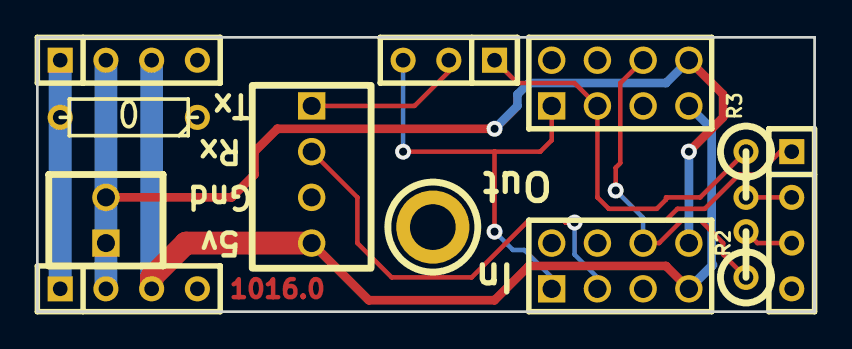
[picture p92: board 1016.kicad_pcb from above]

Board: 2 copper layers, 43.2 x 15.2 mm, 13 parts (0 on the bottom side), 11 nets.

Other parts of the board:
VAL: REF; opp_logo_backsilk
