krayon/pinball-OPP/Kicad/1009-MaxPwr/1009.kicad_pcb

## KiCad design Kicad/1009-MaxPwr/1009.kicad_pcb (2014-01-05)

Schematic: 1009.sch, 1009-MaxPwr

Parts:
P1, P2, P3, P4, P5, P6, P9, P10, P14, P18, P22: SPADE_187
P7, P12, P16, P20: CONN2X3PCP6MB
P8, P13, P17, P21: CONN2X12PCPWR
P11, P15, P19, P23: CONN_2
P24: CONN2X12
P25, P26, P27, P28: TST
R1, R2, R3: 100K

Connections:
3.3V: P8.1, P8.2, P8.13, P10.1, P10.2, P24.17, P24.18
5V: P6.1, P6.2, P8.22, P8.23
5VSTBY: P5.1, P5.2, P8.9, P24.4
5V_1: P8.4, P8.6, P24.5
12V: P7.4, P7.5, P7.6, P12.1, P12.2, P12.3, P24.6
12V_1: P8.10, P8.11, P9.1, P9.2, P13.18, P13.19, P13.24, R1.2, R2.1
24V: P12.4, P12.5, P12.6, P16.1, P16.2, P16.3, P24.3, P24.15
24V_1: P13.10, P13.11, P14.1, P14.2, P17.18, P17.19, P17.24, R2.2, R3.1
36V: P16.4, P16.5, P16.6, P20.1, P20.2, P20.3
36V_1: P17.10, P17.11, P18.1, P18.2, P21.18, P21.19, P21.24, R3.2
48V: P20.4, P20.5, P20.6, P21.10, P21.11, P22.1, P22.2, P24.1, P24.2, P24.13, P24.14
GND: P1.1, P1.2, P2.1, P2.2, P3.1, P3.2, P4.1, P4.2, P7.1, P7.2, P7.3, P8.3, P8.5, P8.7, P8.15, P8.17, P8.18, P8.19, P8.24, P11.2 (PM), P24.7, P24.8, P24.9, P24.10, P24.11, P24.12, P24.19, P24.20, P24.21, P24.22, P24.23, P24.24, R1.1
unnamed: P21.15, P23.2 (PM)
unnamed: P13.16, P15.1
unnamed: P17.16, P19.1
unnamed: P21.16, P23.1
unnamed: P17.15, P19.2 (PM)
unnamed: P13.15, P15.2 (PM)
PS_ON*: P8.16, P11.1, P24.16

Notes on the sheet:
3.3V

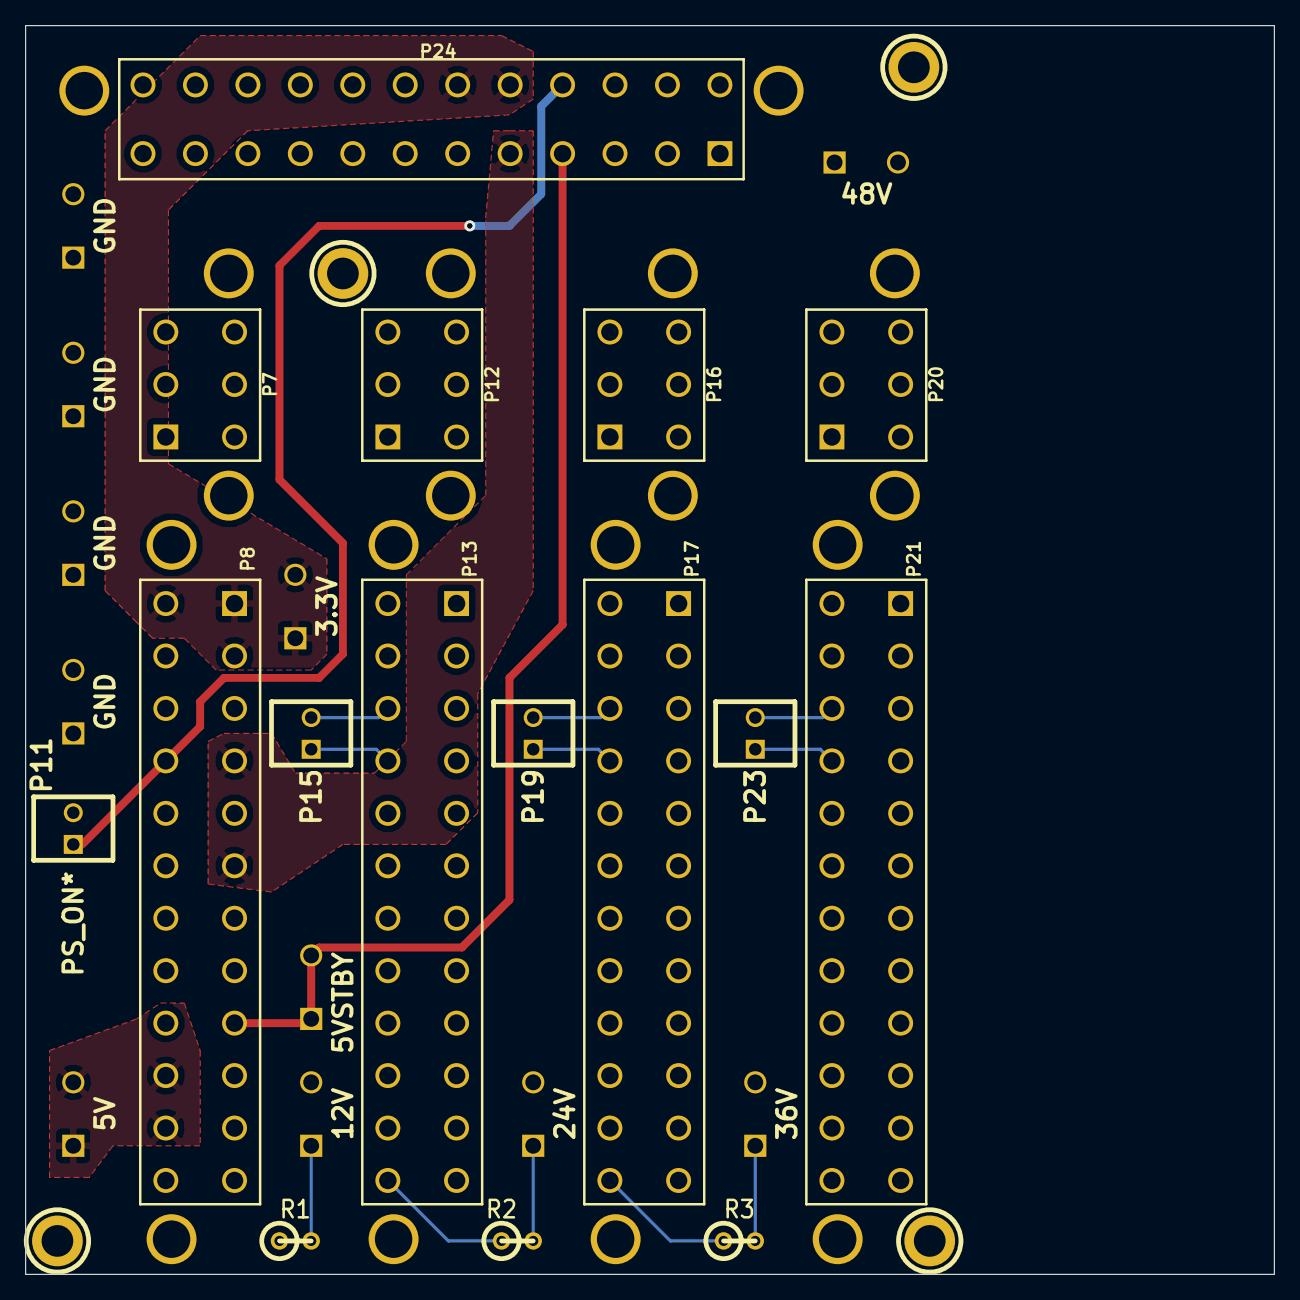
[picture p93: board 1009.kicad_pcb from above]

Board: 2 copper layers, 100.0 x 100.0 mm, 31 parts (0 on the bottom side), 19 nets.
