krayon/pinball-OPP/Kicad/1006-Rs232/1006.sch

## KiCad design Kicad/1006-Rs232/1006.sch (2014-01-05)


Parts:
C1, C2, C3, C4, C5: 1uF
J1: DB9
P1: CONN_4
U1: TRS322ECN

Connections:
+5V: C5.2, P1.4, U1.16 (VCC)
GND: C2.2, C3.2, C5.1, J1.5, P1.3, U1.15 (GND)
unnamed: C1.1, U1.4 (C2+)
unnamed: C1.2, U1.5 (C2-)
unnamed: C2.1, U1.2 (VS+)
unnamed: C3.1, U1.6 (VS-)
unnamed: C4.1, U1.1 (C1+)
unnamed: C4.2, U1.3 (C1-)
unnamed: J1.2, U1.14 (DOUT1)
unnamed: J1.3, U1.13 (RIN1)
unnamed: P1.1, U1.11 (DIN1)
unnamed: P1.2, U1.12 (ROUT1)
