krayon/pinball-OPP/Kicad/1009-MaxPwr/1009.sch

## KiCad design Kicad/1009-MaxPwr/1009.sch (2014-01-05)

Schematic: 1009.sch

Parts:
P1, P2, P3, P4, P5, P6, P9, P10, P14, P18, P22: SPADE_187
P7, P12, P16, P20: CONN2X3PCP6MB
P8, P13, P17, P21: CONN2X12PCPWR
P11, P15, P19, P23: CONN_2
P24: CONN2X12
P25, P26, P27, P28: TST
R1, R2, R3: 100K

Notes on the sheet:
3.3V
