krayon/pinball-OPP/Kicad/1012-STM32F0InpSol/1012-p1.sch

## KiCad design Kicad/1012-STM32F0InpSol/1012-p1.sch (2014-08-24)

Schematic: 1012-p1.sch

Parts:
P1: CONN_33
P3, P4: TST
P5: CONN_3X2
P6, P8, P9, P10, P11, P12, P13, P18, P19: CONN_2; Manufacturer PN 22-23-2021
P14, P15, P16, P17, P20, P21, P22, P23, P24, P25: SPADE_187; Manufacturer PN 1285
Q1, Q2, Q3, Q4, Q5, Q6, Q7, Q8: MOSFET_N; Manufacturer PN IRL520NPBF
R1, R2, R3, R4, R5, R6, R7, R8: 10K; Manufacturer PN CFR25J3K3
