krayon/pinball-OPP/Kicad/1012-STM32F0InpSol/1012-p2.sch

## KiCad design Kicad/1012-STM32F0InpSol/1012-p2.sch (2014-08-24)

Schematic: 1012-p2.sch

Parts:
P2: CONN_33
P26, P27: TST
P28, P29, P30, P31, P32, P33, P38, P39, P50: CONN_2; Manufacturer PN 22-23-2021
P34, P35, P36, P37, P40, P41, P42, P43, P44, P49: SPADE_187; Manufacturer PN 1285
P45, P46, P47, P48: CONN_4; Manufacturer PN 68001-436HLF
Q9, Q10, Q11, Q12, Q13, Q14, Q15, Q16: MOSFET_N; Manufacturer PN IRL520NPBF
R9, R10, R11, R12, R13, R14, R15, R16: 10K; Manufacturer PN CFR25J3K3
R17, R18: 3.3K; Manufacturer PN CFR25J3K3
