krayon/pinball-OPP/Kicad/1013-SolDrvG2/1013.sch

## KiCad design Kicad/1013-SolDrvG2/1013.sch (2018-01-23)


Parts:
P1: TST
P2, P3, P5: CONN_4; Manufacturer PN 68001-436HLF
P4: CONN2X3MOLEX
P6: CONN_8
P10: SPADE_187; Manufacturer PN 1285
Q1, Q2, Q3, Q4: MOSFET_N; Manufacturer PN IRL540NPBF
R1: 0
R2, R3, R4, R5: 100K

Connections:
+5V: P2.3, P3.3
+12V1: P2.2, P3.2
GND: P2.4, P3.4, R1.1, R2.1, R3.1, R4.1, R5.1
GNDPWR: P2.1, P3.1, P4.3, P4.6, P10.1, P10.2 (PM), Q1.S, Q2.S, Q3.S, Q4.S, R1.2
unnamed: P4.1, Q1.D
unnamed: P4.2, Q2.D
unnamed: P4.4, Q4.D
unnamed: P4.5, Q3.D
P0: P5.1, P6.1
P1: P5.2, P6.2
P2: P5.3, P6.3
P3: P5.4, P6.4
P4: P6.5, Q1.G, R2.2
P5: P6.6, Q2.G, R3.2
P6: P6.7, Q3.G, R4.2
P7: P6.8, Q4.G, R5.2
