krayon/pinball-OPP/Kicad/1014-IncandBrdG2/1014.sch

## KiCad design Kicad/1014-IncandBrdG2/1014.sch (2018-01-23)

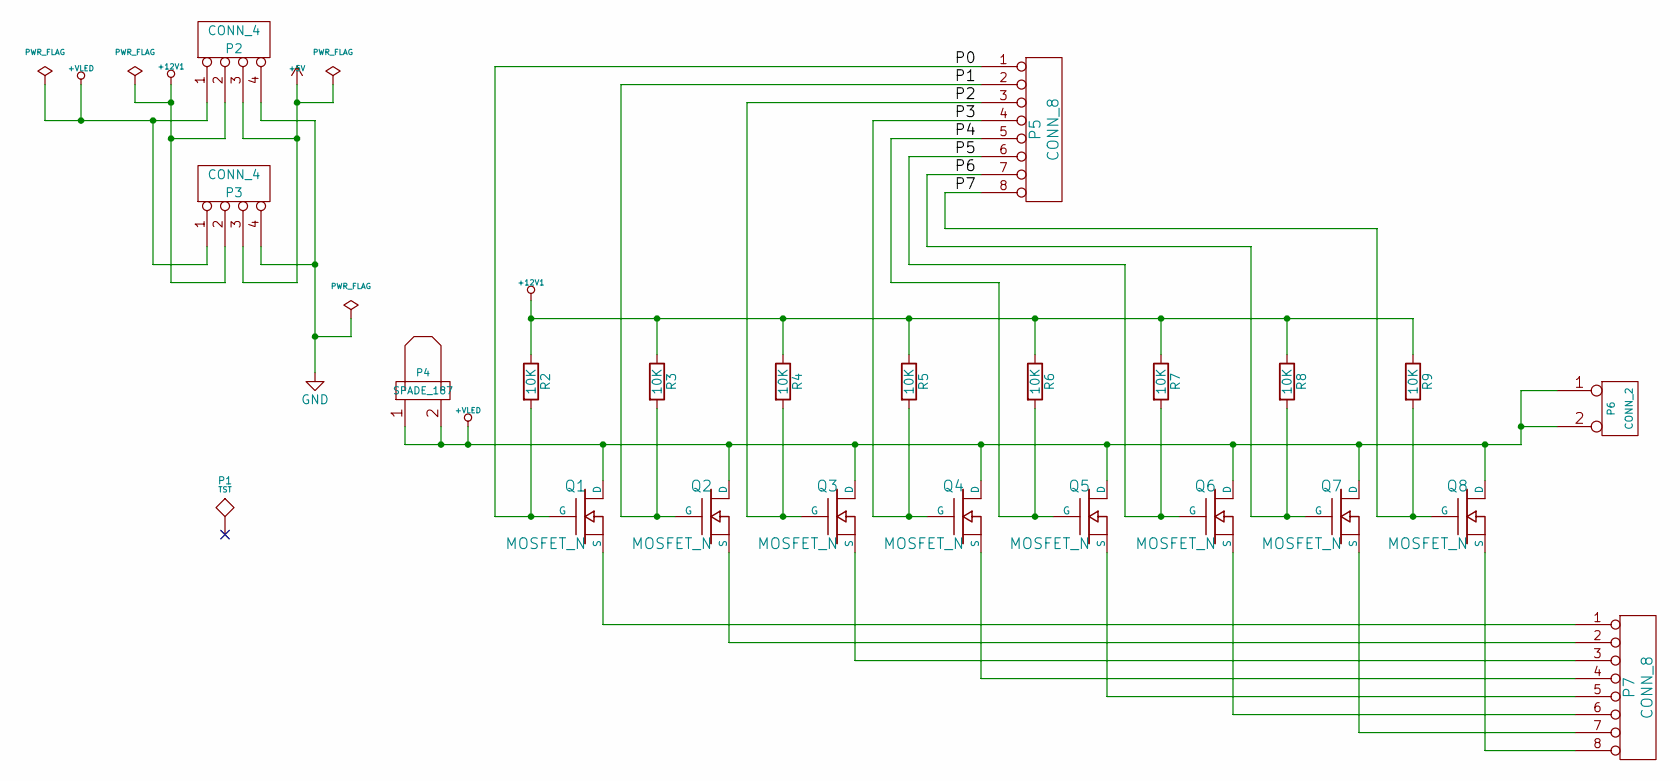
[picture p96: schematic 1014.sch]

Parts:
P1: TST
P2, P3: CONN_4; Manufacturer PN 68001-436HLF
P4: SPADE_187; Manufacturer PN 1285
P5, P7: CONN_8
P6: CONN_2
Q1, Q2, Q3, Q4, Q5, Q6, Q7, Q8: MOSFET_N; Manufacturer PN 2N7000TA
R2, R3, R4, R5, R6, R7, R8, R9: 10K

Connections:
+5V: P2.3, P3.3
+12V1: P2.2, P3.2, R2.1, R3.1, R4.1, R5.1, R6.1, R7.1, R8.1, R9.1
+VLED: P2.1, P3.1, P4.1, P4.2 (PM), P6.1, P6.2 (PM), Q1.D, Q2.D, Q3.D, Q4.D, Q5.D, Q6.D, Q7.D, Q8.D
GND: P2.4, P3.4
unnamed: P7.1, Q1.S
unnamed: P7.2, Q2.S
unnamed: P7.3, Q3.S
unnamed: P7.4, Q4.S
unnamed: P7.5, Q5.S
unnamed: P7.6, Q6.S
unnamed: P7.7, Q7.S
unnamed: P7.8, Q8.S
P0: P5.1, Q1.G, R2.2
P1: P5.2, Q2.G, R3.2
P2: P5.3, Q3.G, R4.2
P3: P5.4, Q4.G, R5.2
P4: P5.5, Q5.G, R6.2
P5: P5.6, Q6.G, R7.2
P6: P5.7, Q7.G, R8.2
P7: P5.8, Q8.G, R9.2
