krayon/pinball-OPP/Kicad/1017-IncandSMG2/1017.sch

## KiCad design Kicad/1017-IncandSMG2/1017.sch (2016-04-08)

Schematic: 1017.sch

Parts:
P1, P3: CONN_4; Manufacturer PN 68001-436HLF
P2, P7: CONN_8
P4: SPADE_187; Manufacturer PN 1285
P5: CONN_2
P6: TST
Q1, Q2, Q3, Q4, Q5, Q6, Q7, Q8, Q9, Q10, Q11, Q12, Q13, Q14, Q15, Q16, Q17, Q18, Q19, Q20, Q21, Q22, Q23, Q24: MOSFET_N; Manufacturer PN 2N7000TA
R1, R2, R3, R4, R5, R6, R7, R8: 10K
