krayon/pinball-OPP/Kicad/1018-PwrFilter/1018.sch

## KiCad design Kicad/1018-PwrFilter/1018.sch (2016-12-24)

Schematic: 1018.sch

Parts:
C1, C2, C3: CP1
D1, D2: LED
P1, P8, P9: CONN2X3MOLEX
P4, P7, P11, P12, P13, P14, P15, P16: TST
P10: CONN_6
Q1, Q2: MOSFET_P
R1, R2, R3, R6, R7, R8: 100K
R4, R5: 900K
TH1, TH2: THERMISTOR
