krayon/pinball-OPP/Kicad/1019-SolPlankG2/1019.sch

## KiCad design Kicad/1019-SolPlankG2/1019.sch (2018-01-25)


Parts:
J1: Conn_02x06_Top_Bottom; 00_th2x6x4.2mm_cheap
J2: Conn_01x22; Pin_Header_Straight_1x22_Pitch2.54mm
P1, P2, P3, P4: TST; 00_mtg_hole-2-56
P5, P6: CONN_4X2; Pin_Header_Straight_2x04_Pitch2.54mm
P7: CONN_4; 00_th1x4x100-lock; Manufacturer PN 68001-436HLF
P8: CONN_8; 00_th1x8x100-lock
P10: SPADE_187; 00_th1x2x200; Manufacturer PN 1285
Q1, Q2, Q3, Q4, Q5, Q6, Q7, Q8: MOSFET_N; 00_to220_vert_gds; Manufacturer PN IRL540NPBF
R1, R12: 0; R_Axial_DIN0309_L9.0mm_D3.2mm_P2.54mm_Vertical
R2, R3, R4, R5, R6, R7, R8, R9: 100K; R_Axial_DIN0309_L9.0mm_D3.2mm_P2.54mm_Vertical
R10, R11: 480; R_Axial_DIN0309_L9.0mm_D3.2mm_P2.54mm_Vertical

Connections:
+5V: J2.22, P5.7, P6.7, P7.4
+12V1: P5.8, P6.8
GND: J2.21, P5.5, P6.5, P7.3, R1.2, R2.1, R3.1, R4.1, R5.1, R6.1, R7.1, R8.1, R9.1, R12.1
GNDPWR: J1.3, J1.6, J1.9, J1.12, P10.1, P10.2 (PM), Q1.S, Q2.S, Q3.S, Q4.S, Q5.S, Q6.S, Q7.S, Q8.S, R1.1
unnamed: J1.1, Q1.D
unnamed: J1.2, Q2.D
unnamed: J1.4, Q3.D
unnamed: J1.5, Q4.D
unnamed: J1.7, Q8.D
unnamed: J1.8, Q7.D
unnamed: J1.10, Q6.D
unnamed: J1.11, Q5.D
unnamed: P5.1, P6.1, P7.1
unnamed: P5.6, P6.6, R11.1
unnamed: P6.3, R10.1
P0.0: J2.5, P8.1
P0.1: J2.6, P8.2
P0.2: J2.7, P8.3
P0.3: J2.8, P8.4
P0.4: J2.9, Q8.G, R9.2
P0.5: J2.10, Q7.G, R8.2
P0.6: J2.11, Q6.G, R7.2
P0.7: J2.12, Q5.G, R6.2
P1.0: J2.13, P8.5
P1.1: J2.14, P8.6
P1.2: J2.15, P8.7
P1.3: J2.16, P8.8
P1.4: J2.17, Q4.G, R5.2
P1.5: J2.18, Q3.G, R4.2
P1.6: J2.19, Q2.G, R3.2
P1.7: J2.20, Q1.G, R2.2
P4.0: J2.1, P5.3, P7.2
P4.1: J2.2, R10.2
P4.2: J2.3, R11.2
P4.3: J2.4, R12.2

Notes on the sheet:
R12 only populated if on left side of PSOC4200
