krayon/pinball-OPP/Kicad/1020-IncandPlankG2/1020.sch

## KiCad design Kicad/1020-IncandPlankG2/1020.sch (2018-01-25)


Parts:
J1: Conn_01x22; Pin_Header_Straight_1x22_Pitch2.54mm
P1, P2: CONN_4X2; Pin_Header_Straight_2x04_Pitch2.54mm
P3: CONN_4; 00_th1x4x100-lock; Manufacturer PN 68001-436HLF
P4, P5, P6, P7: TST; 00_mtg_hole-2-56
P8, P9: CONN_8; 00_th1x8x100-lock
P10: CONN_2; 00_th1x2x4.2mm_cheap
P11: SPADE_187; 00_th1x2x200; Manufacturer PN 1285
Q1, Q2, Q3, Q4, Q5, Q6, Q7, Q8, Q9, Q10, Q11, Q12, Q13, Q14, Q15, Q16: MOSFET_N; 00_to92_dgs; Manufacturer PN 2N7000TA
R1, R4: 0; R_Axial_DIN0309_L9.0mm_D3.2mm_P2.54mm_Vertical
R2, R3: 480; R_Axial_DIN0309_L9.0mm_D3.2mm_P2.54mm_Vertical

Connections:
+5V: J1.22, P1.7, P2.7, P3.4
+12V1: P1.8, P2.8
GND: J1.21, P1.5, P2.5, P3.3, R1.1, R4.1
GNDPWR: P10.1, P10.2 (PM), P11.1, P11.2 (PM), Q1.S, Q2.S, Q3.S, Q4.S, Q5.S, Q6.S, Q7.S, Q8.S, Q9.S, Q10.S, Q11.S, Q12.S, Q13.S, Q14.S, Q15.S, Q16.S, R4.2
unnamed: P1.1, P2.1, P3.1
unnamed: P1.6, P2.6, R2.1
unnamed: P2.3, R3.1
unnamed: P8.1, Q1.D
unnamed: P8.2, Q3.D
unnamed: P8.3, Q5.D
unnamed: P8.4, Q7.D
unnamed: P8.5, Q9.D
unnamed: P8.6, Q11.D
unnamed: P8.7, Q13.D
unnamed: P8.8, Q15.D
unnamed: P9.1, Q16.D
unnamed: P9.2, Q14.D
unnamed: P9.3, Q12.D
unnamed: P9.4, Q10.D
unnamed: P9.5, Q8.D
unnamed: P9.6, Q6.D
unnamed: P9.7, Q4.D
unnamed: P9.8, Q2.D
P0.0: J1.5, Q16.G
P0.1: J1.6, Q14.G
P0.2: J1.7, Q12.G
P0.3: J1.8, Q10.G
P0.4: J1.9, Q8.G
P0.5: J1.10, Q6.G
P0.6: J1.11, Q4.G
P0.7: J1.12, Q2.G
P1.0: J1.13, Q1.G
P1.1: J1.14, Q3.G
P1.2: J1.15, Q5.G
P1.3: J1.16, Q7.G
P1.4: J1.17, Q9.G
P1.5: J1.18, Q11.G
P1.6: J1.19, Q13.G
P1.7: J1.20, Q15.G
P4.0: J1.1, P1.3, P3.2
P4.1: J1.2, R3.2
P4.2: J1.3, R2.2
P4.3: J1.4, R1.2

Notes on the sheet:
R1 only populated if on left side of PSOC4200
