krayon/pinball-OPP/MPF/SS3/modes/attract/shows/attract_light_loop.yaml

#show_version=4
#
#===============================================================================
## @mainpage
#
#                           OOOO
#                         OOOOOOOO
#        PPPPPPPPPPPPP   OOO    OOO   PPPPPPPPPPPPP
#      PPPPPPPPPPPPPP   OOO      OOO   PPPPPPPPPPPPPP
#     PPP         PPP   OOO      OOO   PPP         PPP
#    PPP          PPP   OOO      OOO   PPP          PPP
#    PPP          PPP   OOO      OOO   PPP          PPP
#    PPP          PPP   OOO      OOO   PPP          PPP
#     PPP         PPP   OOO      OOO   PPP         PPP
#      PPPPPPPPPPPPPP   OOO      OOO   PPPPPPPPPPPPPP
#       PPPPPPPPPPPPP   OOO      OOO   PPP
#                 PPP   OOO      OOO   PPP
#                 PPP   OOO      OOO   PPP
#                 PPP   OOO      OOO   PPP
#                 PPP    OOO    OOO    PPP
#                 PPP     OOOOOOOO     PPP
#                PPPPP      OOOO      PPPPP
#
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
#===============================================================================
##
# @file    attract_light_loop.yaml
# @author  Hugh Spahr
# @date    1/8/2016
#
# @note    Open Pinball Project
# @note    Copyright 2016, Hugh Spahr
#
# @brief yaml file that includes the light loop in attract mode

#===============================================================================


- time: 0
  lights:
    l_shoot_again: ff
    l_mode_sharpe: 0
    l_mode_sniper: 0
    l_mode_trkbndt: 0
    l_mode_chkhide: 0
    l_mode_killall: 0
    l_mode_trgtprac: 0
    l_mode_barfght: 0
    l_mode_hustlejive: 0
    l_mode_duel: 0
    l_mode_posse: 0
    l_mode_ridehelp: 0
    l_rookie: 0
    l_deputy: 0
    l_sheriff: 0
    l_marshal: 0
    l_dt_1: 0
    l_dt_2: 0
    l_dt_3: 0
    l_dt_4: 0
    l_dt_5: 0
    l_dt_6: 0
    l_dt_7: 0
    l_ko_duel: 0
    l_ko_pick_job: 0
    l_2x: 0
    l_3x: 0
    l_4x: 0
    l_5x: 0
    l_inln_lft: 0
    l_inln_ctr: 0
    l_inln_rght: 0
    l_roll_lft: 0
    l_roll_ctr: 0
    l_roll_rght: 0
- time: '+1'
  lights:
    l_mode_sharpe: ff
- time: '+1'
  lights:
    l_mode_sniper: ff
    l_mode_trkbndt: ff
- time: '+1'
  lights:
    l_mode_chkhide: ff
    l_mode_killall: ff
- time: '+1'
  lights:
    l_mode_trgtprac: ff
    l_mode_barfght: ff
- time: '+1'
  lights:
    l_mode_hustlejive: ff
    l_mode_duel: ff
- time: '+1'
  lights:
    l_mode_posse: ff
    l_mode_ridehelp: ff
- time: '+1'
  lights:
    l_rookie: ff
- time: '+1'
  lights:
    l_deputy: ff
- time: '+1'
  lights:
    l_sheriff: ff
- time: '+1'
  lights:
    l_marshal: ff
- time: '+1'
  lights:
    l_dt_1: ff
- time: '+1'
  lights:
    l_dt_1: 0
    l_dt_2: ff
- time: '+1'
  lights:
    l_dt_2: 0
    l_dt_3: ff
- time: '+1'
  lights:
    l_dt_3: 0
    l_dt_4: ff
- time: '+1'
  lights:
    l_dt_4: 0
    l_dt_5: ff
- time: '+1'
  lights:
    l_dt_5: 0
    l_dt_6: ff
- time: '+1'
  lights:
    l_dt_6: 0
    l_dt_7: ff
- time: '+1'
  lights:
    l_dt_7: 0
    l_dt_6: ff
- time: '+1'
  lights:
    l_dt_6: 0
    l_dt_5: ff
- time: '+1'
  lights:
    l_dt_5: 0
    l_dt_4: ff
- time: '+1'
  lights:
    l_dt_4: 0
    l_dt_3: ff
- time: '+1'
  lights:
    l_dt_3: 0
    l_dt_2: ff
- time: '+1'
  lights:
    l_dt_2: 0
    l_dt_1: ff
- time: '+1'
  lights:
    l_dt_1: 0
- time: '+1'
  lights:
    l_dt_1: ff
    l_dt_2: ff
    l_dt_3: ff
    l_dt_4: ff
    l_dt_5: ff
    l_dt_6: ff
    l_dt_7: ff
- time: '+1'
  lights:
    l_dt_1: 0
    l_dt_2: 0
    l_dt_3: 0
    l_dt_4: 0
    l_dt_5: 0
    l_dt_6: 0
    l_dt_7: 0
- time: '+5'
  lights:
    l_dt_1: ff
    l_dt_2: ff
    l_dt_3: ff
    l_dt_4: ff
    l_dt_5: ff
    l_dt_6: ff
    l_dt_7: ff
- time: '+1'
  lights:
    l_ko_duel: ff
- time: '+1'
  lights:
    l_ko_pick_job: ff
- time: '+1'
  lights:
    l_2x: ff
- time: '+1'
  lights:
    l_3x: ff
- time: '+1'
  lights:
    l_4x: ff
- time: '+1'
  lights:
    l_5x: ff
- time: '+1'
  lights:
    l_inln_lft: ff
- time: '+1'
  lights:
    l_inln_ctr: ff
- time: '+1'
  lights:
    l_inln_rght: ff
- time: '+1'
  lights:
    l_roll_lft: ff
- time: '+1'
  lights:
    l_roll_ctr: ff
- time: '+1'
  lights:
    l_roll_rght: ff
- time: '+1'
  lights:
    l_inln_lft: 0
    l_inln_ctr: 0
    l_inln_rght: 0
    l_roll_lft: 0
    l_roll_ctr: 0
    l_roll_rght: 0
- time: '+1'
  lights:
    l_inln_lft: ff
    l_inln_ctr: ff
    l_inln_rght: ff
    l_roll_lft: ff
    l_roll_ctr: ff
    l_roll_rght: ff
- time: '+5'
  lights:
    l_inln_lft: 0
    l_inln_ctr: 0
    l_inln_rght: 0
    l_roll_lft: 0
    l_roll_ctr: 0
    l_roll_rght: 0
- time: '+1'
  lights:
    l_inln_lft: ff
    l_inln_ctr: ff
    l_inln_rght: ff
    l_roll_lft: ff
    l_roll_ctr: ff
    l_roll_rght: ff
- time: '+5'
  lights:
    l_inln_lft: 0
    l_inln_ctr: 0
    l_inln_rght: 0
    l_roll_lft: 0
    l_roll_ctr: 0
    l_roll_rght: 0
- time: '+1'
  lights:
    l_inln_lft: ff
    l_inln_ctr: ff
    l_inln_rght: ff
    l_roll_lft: ff
    l_roll_ctr: ff
    l_roll_rght: ff
- time: '+5'
  lights:
    l_shoot_again: 0
    l_mode_sharpe: 0
    l_mode_sniper: 0
    l_mode_trkbndt: 0
    l_mode_chkhide: 0
    l_mode_killall: 0
    l_mode_trgtprac: 0
    l_mode_barfght: 0
    l_mode_hustlejive: 0
    l_mode_duel: 0
    l_mode_posse: 0
    l_mode_ridehelp: 0
    l_rookie: 0
    l_deputy: 0
    l_sheriff: 0
    l_marshal: 0
    l_dt_1: 0
    l_dt_2: 0
    l_dt_3: 0
    l_dt_4: 0
    l_dt_5: 0
    l_dt_6: 0
    l_dt_7: 0
    l_ko_duel: 0
    l_ko_pick_job: 0
    l_2x: 0
    l_3x: 0
    l_4x: 0
    l_5x: 0
    l_inln_lft: 0
    l_inln_ctr: 0
    l_inln_rght: 0
    l_roll_lft: 0
    l_roll_ctr: 0
    l_roll_rght: 0
- time: '+5'
  lights:
    l_shoot_again: ff
    l_mode_sharpe: ff
    l_mode_sniper: ff
    l_mode_trkbndt: ff
    l_mode_chkhide: ff
    l_mode_killall: ff
    l_mode_trgtprac: ff
    l_mode_barfght: ff
    l_mode_hustlejive: ff
    l_mode_duel: ff
    l_mode_posse: ff
    l_mode_ridehelp: ff
    l_rookie: ff
    l_deputy: ff
    l_sheriff: ff
    l_marshal: ff
    l_dt_1: ff
    l_dt_2: ff
    l_dt_3: ff
    l_dt_4: ff
    l_dt_5: ff
    l_dt_6: ff
    l_dt_7: ff
    l_ko_duel: ff
    l_ko_pick_job: ff
    l_2x: ff
    l_3x: ff
    l_4x: ff
    l_5x: ff
    l_inln_lft: ff
    l_inln_ctr: ff
    l_inln_rght: ff
    l_roll_lft: ff
    l_roll_ctr: ff
    l_roll_rght: ff
- time: '+5'
  lights:
    l_shoot_again: 0
    l_mode_sharpe: 0
    l_mode_sniper: 0
    l_mode_trkbndt: 0
    l_mode_chkhide: 0
    l_mode_killall: 0
    l_mode_trgtprac: 0
    l_mode_barfght: 0
    l_mode_hustlejive: 0
    l_mode_duel: 0
    l_mode_posse: 0
    l_mode_ridehelp: 0
    l_rookie: 0
    l_deputy: 0
    l_sheriff: 0
    l_marshal: 0
    l_dt_1: 0
    l_dt_2: 0
    l_dt_3: 0
    l_dt_4: 0
    l_dt_5: 0
    l_dt_6: 0
    l_dt_7: 0
    l_ko_duel: 0
    l_ko_pick_job: 0
    l_2x: 0
    l_3x: 0
    l_4x: 0
    l_5x: 0
    l_inln_lft: 0
    l_inln_ctr: 0
    l_inln_rght: 0
    l_roll_lft: 0
    l_roll_ctr: 0
    l_roll_rght: 0
- time: '+5'
  lights:
    l_shoot_again: ff
    l_mode_sharpe: ff
    l_mode_sniper: ff
    l_mode_trkbndt: ff
    l_mode_chkhide: ff
    l_mode_killall: ff
    l_mode_trgtprac: ff
    l_mode_barfght: ff
    l_mode_hustlejive: ff
    l_mode_duel: ff
    l_mode_posse: ff
    l_mode_ridehelp: ff
    l_rookie: ff
    l_deputy: ff
    l_sheriff: ff
    l_marshal: ff
    l_dt_1: ff
    l_dt_2: ff
    l_dt_3: ff
    l_dt_4: ff
    l_dt_5: ff
    l_dt_6: ff
    l_dt_7: ff
    l_ko_duel: ff
    l_ko_pick_job: ff
    l_2x: ff
    l_3x: ff
    l_4x: ff
    l_5x: ff
    l_inln_lft: ff
    l_inln_ctr: ff
    l_inln_rght: ff
    l_roll_lft: ff
    l_roll_ctr: ff
    l_roll_rght: ff
- time: '+5'
  lights:
    l_shoot_again: 0
    l_mode_sharpe: 0
    l_mode_sniper: 0
    l_mode_trkbndt: 0
    l_mode_chkhide: 0
    l_mode_killall: 0
    l_mode_trgtprac: 0
    l_mode_barfght: 0
    l_mode_hustlejive: 0
    l_mode_duel: 0
    l_mode_posse: 0
    l_mode_ridehelp: 0
    l_rookie: 0
    l_deputy: 0
    l_sheriff: 0
    l_marshal: 0
    l_dt_1: 0
    l_dt_2: 0
    l_dt_3: 0
    l_dt_4: 0
    l_dt_5: 0
    l_dt_6: 0
    l_dt_7: 0
    l_ko_duel: 0
    l_ko_pick_job: 0
    l_2x: 0
    l_3x: 0
    l_4x: 0
    l_5x: 0
    l_inln_lft: 0
    l_inln_ctr: 0
    l_inln_rght: 0
    l_roll_lft: 0
    l_roll_ctr: 0
    l_roll_rght: 0
- time: '+5'
  lights:
    l_shoot_again: ff
    l_mode_sharpe: ff
    l_mode_sniper: ff
    l_mode_trkbndt: ff
    l_mode_chkhide: ff
    l_mode_killall: ff
    l_mode_trgtprac: ff
    l_mode_barfght: ff
    l_mode_hustlejive: ff
    l_mode_duel: ff
    l_mode_posse: ff
    l_mode_ridehelp: ff
    l_rookie: ff
    l_deputy: ff
    l_sheriff: ff
    l_marshal: ff
    l_dt_1: ff
    l_dt_2: ff
    l_dt_3: ff
    l_dt_4: ff
    l_dt_5: ff
    l_dt_6: ff
    l_dt_7: ff
    l_ko_duel: ff
    l_ko_pick_job: ff
    l_2x: ff
    l_3x: ff
    l_4x: ff
    l_5x: ff
    l_inln_lft: ff
    l_inln_ctr: ff
    l_inln_rght: ff
    l_roll_lft: ff
    l_roll_ctr: ff
    l_roll_rght: ff
- time: '+5'
  lights:
    l_shoot_again: 0
    l_mode_sharpe: 0
    l_mode_sniper: 0
    l_mode_trkbndt: 0
    l_mode_chkhide: 0
    l_mode_killall: 0
    l_mode_trgtprac: 0
    l_mode_barfght: 0
    l_mode_hustlejive: 0
    l_mode_duel: 0
    l_mode_posse: 0
    l_mode_ridehelp: 0
    l_rookie: 0
    l_deputy: 0
    l_sheriff: 0
    l_marshal: 0
    l_dt_1: 0
    l_dt_2: 0
    l_dt_3: 0
    l_dt_4: 0
    l_dt_5: 0
    l_dt_6: 0
    l_dt_7: 0
    l_ko_duel: 0
    l_ko_pick_job: 0
    l_2x: 0
    l_3x: 0
    l_4x: 0
    l_5x: 0
    l_inln_lft: 0
    l_inln_ctr: 0
    l_inln_rght: 0
    l_roll_lft: 0
    l_roll_ctr: 0
    l_roll_rght: 0
- time: '+5'
