krayon/pinball-OPP/Python/GenPyCode/procLedCards.py

#!/usr/bin/env python
#
#===============================================================================
#
#                           OOOO
#                         OOOOOOOO
#        PPPPPPPPPPPPP   OOO    OOO   PPPPPPPPPPPPP
#      PPPPPPPPPPPPPP   OOO      OOO   PPPPPPPPPPPPPP
#     PPP         PPP   OOO      OOO   PPP         PPP
#    PPP          PPP   OOO      OOO   PPP          PPP
#    PPP          PPP   OOO      OOO   PPP          PPP
#    PPP          PPP   OOO      OOO   PPP          PPP
#     PPP         PPP   OOO      OOO   PPP         PPP
#      PPPPPPPPPPPPPP   OOO      OOO   PPPPPPPPPPPPPP
#       PPPPPPPPPPPPP   OOO      OOO   PPP
#                 PPP   OOO      OOO   PPP
#                 PPP   OOO      OOO   PPP
#                 PPP   OOO      OOO   PPP
#                 PPP    OOO    OOO    PPP
#                 PPP     OOOOOOOO     PPP
#                PPPPP      OOOO      PPPPP
#
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
#===============================================================================
##
# @file    procLedCards.py
# @author  Hugh Spahr
# @date    7/6/2014
#
# @note    Open Pinball Project
# @note    Copyright 2014, Hugh Spahr
#
# @brief Process LED_CARDS section.

#===============================================================================

import os
import time
from procChains import ProcChains
import rs232Intf

## Proc LED Cards class.
#
#  Contains functions for LED_CARDS section.
class ProcLedCards():
    numLedCards = 0

    ## Initialize the ProcLedCards class
    #
    #  Initialize LED cards to zero
    #
    #  @param  self          [in]   Object reference
    #  @return None
    def __init__(self):
        self.out = 0
        ProcLedCards.hasData = False
        ProcLedCards.ledCfgBits = []
        ProcLedCards.ledWingCards = []
        ProcLedCards.name = []
        ProcLedCards.cardNum = []
        ProcLedCards.pinNum = []
        ProcLedCards.desc = []
        ProcLedCards.hasLedWingMask = 0
        
        # Constants
        ProcLedCards.NUM_LED_BITS = 32

    ## Process section
    #
    #  @param  self          [in]   Object reference
    #  @return None
    def procSection(self, parent):
        if (ProcLedCards.hasData):
            parent.consoleObj.updateConsole("!!! Error !!! Found multiple LED_CARDS sections, at line num %d." %
               (parent.lineNumList[parent.currToken]))
            return (400)
        ProcLedCards.hasData = True
        parent.consoleObj.updateConsole("Processing LED_CARDS section")
        if (parent.tokens[parent.currToken] != "LED_CARDS"):
            parent.consoleObj.updateConsole("!!! SW Error !!! Expected LED_CARDS, read %s, at line num %d." %
               (parent.tokens[parent.currToken], parent.lineNumList[parent.currToken]))
            return (401)
        parent.currToken += 1
        for _ in xrange(parent.procSimple.numGen2Cards):
            ProcLedCards.ledCfgBits.append(0)
            ProcLedCards.ledWingCards.append(0)
        if not parent.helpFuncs.isOpenSym(parent.tokens[parent.currToken]):
            parent.consoleObj.updateConsole("!!! Error !!! Expected opening symbol, read %s, at line num %d." %
               (parent.tokens[parent.currToken], parent.lineNumList[parent.currToken]))
            return (403)
        closeSymb = parent.helpFuncs.findMatch(parent)
        parent.currToken += 1
        while parent.currToken < closeSymb:
            errVal = self.procLine(parent)
            if errVal:
                parent.currToken = closeSymb
        self.createLedBitNames(parent)
        parent.currToken += 1
        return (0)

    ## Process line
    #
    # Line consists of name, cardNum, pinNum, and description string.  
    #
    #  @param  self          [in]   Object reference
    #  @param  parent        [in]   Parent object for logging and tokens
    #  @return Error number if an error, or zero if no error
    def procLine(self, parent):
        name = parent.tokens[parent.currToken]
        ProcLedCards.name.append(name)
        if ProcChains.checkNameExists(parent.procChains, name):
            parent.consoleObj.updateConsole("!!! Error !!! LED bit name already exists, read %s, at line num %d." %
               (name, parent.lineNumList[parent.currToken]))
            return (410)           
        ProcChains.addName(parent.procChains, name, ProcChains.LED_BIT)
        
        # Verify card num
        if not parent.helpFuncs.isInt(parent.tokens[parent.currToken + 1]):
            parent.consoleObj.updateConsole("!!! Error !!! LED card num, read %s, at line num %d." %
               (parent.tokens[parent.currToken + 1], parent.lineNumList[parent.currToken + 1]))
            return (411)
        # Card num is now 0 based
        cardNum = parent.helpFuncs.out
        if (cardNum < 0) or (cardNum >= parent.procSimple.numGen2Cards):
            parent.consoleObj.updateConsole("!!! Error !!! Illegal LED card num, read %s, at line num %d." %
               (parent.tokens[parent.currToken + 1], parent.lineNumList[parent.currToken + 1]))
            return (412)
        ProcLedCards.hasLedWingMask |= (1 << cardNum)
        ProcLedCards.cardNum.append(cardNum)
        
        # Verify pin num
        if not parent.helpFuncs.isInt(parent.tokens[parent.currToken + 2]):
            parent.consoleObj.updateConsole("!!! Error !!! LED pin num, read %s, at line num %d." %
               (parent.tokens[parent.currToken + 2], parent.lineNumList[parent.currToken + 2]))
            return (413)
        # Pin num is now 0 based
        pinNum = parent.helpFuncs.out
        if (pinNum < 0) or (pinNum >= ProcLedCards.NUM_LED_BITS):
            parent.consoleObj.updateConsole("!!! Error !!! Illegal LED pin num, read %s, at line num %d." %
               (parent.tokens[parent.currToken + 2], parent.lineNumList[parent.currToken + 2]))
            return (414)
        if (ProcLedCards.ledCfgBits[cardNum] & (1 << pinNum)) != 0: 
            parent.consoleObj.updateConsole("!!! Error !!! LED pin configured multiple times, at line num %d." %
               (parent.lineNumList[parent.currToken + 2]))
            return (415)
        ProcLedCards.ledCfgBits[cardNum] |= (1 << pinNum)
        ProcLedCards.ledWingCards[cardNum] |= (1 << ((pinNum & 0x18) >> 3))
        ProcLedCards.pinNum.append(pinNum)
        
        # Grab description
        desc = parent.tokens[parent.currToken + 3]
        ProcLedCards.desc.append(desc)
        
        # increment currToken
        parent.currToken += 4
        return (0)

    ## Create ledBitNames.py file
    #
    # Create the LED bit names file.  
    #
    #  @param  self          [in]   Object reference
    #  @param  parent        [in]   Parent object for logging and tokens
    #  @return Error number if an error, or zero if no error
    def createLedBitNames(self, parent):
        HDR_COMMENTS = [
            "# @file    ledBitNames.py",
            "# @author  AutoGenerated",
            "# @date    ",
            "#",
            "# @note    Open Pinball Project",
            "# @note    Copyright 2014, Hugh Spahr",
            "#",
            "# @brief These are the LED bit names.  It has a bitmask for each LED.",
            "",
            "#===============================================================================",
            "",
            "## LED bit name enumeration.",
            "#  Contains a bit mask for each LED.  Can also contain bitfield masks.",
            "#  Top most nibble contains the index of the LED card base 0.",
            "class LedBitNames:",
            "    def __init__(self):",
            "        pass",
            ""]

        # Open the file or create if necessary
        outHndl = open(parent.consoleObj.outDir + os.sep + "ledBitNames.py", 'w+')
        stdHdrHndl = open("stdHdr.txt", 'r')
        for line in stdHdrHndl:
            outHndl.write(line)
        stdHdrHndl.close()
        for line in HDR_COMMENTS:
            if line.startswith("# @date"):
                outHndl.write(line + time.strftime("%m/%d/%Y") + "\n")
            else:
                outHndl.write(line + "\n")
        
        # Write out LED bit enumeration
        for cardIndex in xrange(parent.procSimple.numGen2Cards):
            if ((ProcLedCards.hasLedWingMask & (1 << cardIndex)) != 0):
                allLedMask = 0
                for wingIndex in xrange(rs232Intf.NUM_G2_WING_PER_BRD):
                    if ((ProcLedCards.ledWingCards[cardIndex] & (1 << wingIndex)) != 0):
                        allBitsName = "LED{0}W{1}_ALL_BITS_MSK".format(cardIndex, wingIndex)
                        outHndl.write("    {0:32} = 0x{1:08x}\n".format( allBitsName,
                            (cardIndex * 0x1000000) + (wingIndex << 16) + 0x00ff))
                        ProcChains.addName(parent.procChains, allBitsName, ProcChains.LED_BIT)
                        parent.procChains.ledDict[allBitsName] = (cardIndex * 0x1000000) + (wingIndex << 16) + 0x00ff
                        allLedMask |= 0xff << (wingIndex << 3)
                if (allLedMask != 0):
                    allBitsName = "LED_CRD{0}_LIST_BITS_MSK".format(cardIndex)
                    outHndl.write("    {0:32} = 0x{1:08x}\n".format(allBitsName, allLedMask))
            for bitIndex in xrange(ProcLedCards.NUM_LED_BITS):
                found = self.findBitIndex(cardIndex, bitIndex)
                if found:
                    offset = bitIndex & 0x07;
                    wingBrdIndex = (bitIndex & 0x18) >> 3;
                    # Look for any errors such as wing board being a different type
                    if ((parent.procSimple.cardWingInv[cardIndex][wingBrdIndex] != 0) and (parent.procSimple.cardWingInv[cardIndex][wingBrdIndex] != rs232Intf.WING_INCAND)):
                        parent.consoleObj.updateConsole("!!! Error !!! Gen2 wing board previous configured as 0x{0:02x}.".format(ord(parent.procSimple.cardWingInv[cardIndex][wingBrdIndex])))
                        return (420)
                    parent.procSimple.cardWingInv[cardIndex][wingBrdIndex] = rs232Intf.WING_INCAND
                    outHndl.write("    {0:32} = 0x{1:08x}\n".format(ProcLedCards.name[self.out].upper(),
                        ((cardIndex << 24) | (wingBrdIndex << 16) | (1 << offset))))
                    # Create the LED name dictionary
                    parent.procChains.ledDict[ProcLedCards.name[self.out].upper()] = ((cardIndex << 24) | (wingBrdIndex << 16) | (1 << offset))
        
        # Write out the bit masks enumerations
        outHndl.write("\n");
        for cardIndex in xrange(parent.procSimple.numGen2Cards):
            for bitIndex in xrange(ProcLedCards.NUM_LED_BITS):
                found = self.findBitIndex(cardIndex, bitIndex)
                if found:
                    offset = (bitIndex & 0x1f)
                    name = ProcLedCards.name[self.out].upper() + "_CRD{0}MSK".format(cardIndex)
                    outHndl.write("    {0:48} = 0x{1:08x}\n".format(name, (1 << offset)))

        # Write out the bit name strings
        outHndl.write("\n    ## LED board bit names\n")
        outHndl.write("    # Indexed into using the [LedBitNames](@ref ledBitNames.LedBitNames) class\n")
        outHndl.write("    LED_BRD_BIT_NAMES = [ ")
        for cardIndex in xrange(parent.procSimple.numGen2Cards):
            if (cardIndex != 0):
                outHndl.write(",\n        ")
            if (ProcLedCards.hasLedWingMask & (1 << cardIndex) == 0):
                outHndl.write("[ ]")
            else:
                outHndl.write("[")
                for bitIndex in xrange(ProcLedCards.NUM_LED_BITS):
                    if (bitIndex != 0):
                        if ((bitIndex % 4) == 0):
                            outHndl.write(",\n        ")
                        else:
                            outHndl.write(", ")
                    found = self.findBitIndex(cardIndex, bitIndex)
                    if found:
                        outHndl.write(ProcLedCards.desc[self.out])
                    else:
                        outHndl.write("\"Unused\"")
                outHndl.write("]")
        outHndl.write(" ]\n\n")
        outHndl.close()
        parent.consoleObj.updateConsole("Completed: ledBitNames.py file.")
        return (0)

    ## Find bit index
    #
    # Find index of the bit.  If no bit is found (i.e. it is not
    # configured, it returns false.
    #
    #  @param  self          [in]   Object reference
    #  @param  cardNum       [in]   Card number
    #  @param  bitNum        [in]   Bit number
    #  @return True if found, False if not found.  Passes index
    #   in out 
    def findBitIndex(self, cardNum, bitNum):
        for index in xrange(len(ProcLedCards.pinNum)):
            if (ProcLedCards.cardNum[index] == cardNum) and (ProcLedCards.pinNum[index] == bitNum):
                self.out = index
                return True
        return False
