krayon/pinball-OPP/Python/PinballFramework/dispThread.py

#!/usr/bin/env python
#
#===============================================================================
#
#                           OOOO
#                         OOOOOOOO
#        PPPPPPPPPPPPP   OOO    OOO   PPPPPPPPPPPPP
#      PPPPPPPPPPPPPP   OOO      OOO   PPPPPPPPPPPPPP
#     PPP         PPP   OOO      OOO   PPP         PPP
#    PPP          PPP   OOO      OOO   PPP          PPP
#    PPP          PPP   OOO      OOO   PPP          PPP
#    PPP          PPP   OOO      OOO   PPP          PPP
#     PPP         PPP   OOO      OOO   PPP         PPP
#      PPPPPPPPPPPPPP   OOO      OOO   PPPPPPPPPPPPPP
#       PPPPPPPPPPPPP   OOO      OOO   PPP
#                 PPP   OOO      OOO   PPP
#                 PPP   OOO      OOO   PPP
#                 PPP   OOO      OOO   PPP
#                 PPP    OOO    OOO    PPP
#                 PPP     OOOOOOOO     PPP
#                PPPPP      OOOO      PPPPP
#
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
#===============================================================================
##
# @file    dispThread.py
# @author  Hugh Spahr
# @date    1/18/2014
#
# @note    Open Pinball Project
# @note    Copyright 2014, Hugh Spahr
#
# @brief This is the display thread file that is used to display scores, GI lighting,
# and feature lights.

#===============================================================================

import thread
import pygame
from pygame.locals import *
from dispConstIntf import DispConst
import errIntf

# HRS:  This should be moved into a class.
updFeatList = []
updGiState = DispConst.LGHT_ON
sndPlyr = []
GameData = None

#Positions for score
xPos = []
yPos = []
clearRect = []
bgndRect = 0

#Pos for video
vidXPos = 0
vidWidth = 0
vidHeight = 0

#Positions for simulated lights
featureSimLghtPos = []
featOn = []
clearFeatRect = []
giSimLghtPos = []
clearGiRect = []

#Array to hold background images
imageArr = []

simRatio = 1.0
simWidth = 0
simHeight = 0
simLghtRadius = 0
runDispThread = True

orangeColor = (255, 131, 0)
whiteColor = (255, 255, 255)

## Update display function
#
#  Add the update to the update display list
#
#  @param  disp          [in]   Display to be updated
#  @return None
def updateDisp(disp):
    global digiFont
    global screen
    global background
    global clearRect
    global GameData

    screen.blit(background, clearRect[disp], clearRect[disp])
    if not GameData.blankDisp[disp]:
        text = digiFont.render(str(GameData.currDisp[disp]), 1, orangeColor)
        textpos = text.get_rect()
        textpos.midright = xPos[disp], yPos[disp]
        screen.blit(text, textpos)
    pygame.display.update(clearRect[disp])

## Create the sound player function
#
#  Add all the sound files into the player
#
#  @return None
def createSndPlyr():
    global sndPlyr
    
    for fileName in GameData.Sounds.SND_FILES:
        sndPlyr.append(pygame.mixer.Sound(GameData.rulesDir + "/" + fileName))

## Update a feature light to on/off or blink
#
#  Add the update to the update feature list
#
#  @param  num           [in]   Index of the feature light
#  @param  state         [in]   on/off or blink
#  @return None
def updateFeatLight(num, state):
    global screen
    global simLghtRadius
    global background
    
    if (num < len(featOn)):
        if (state == DispConst.LGHT_ON) or ((state == DispConst.LGHT_TOGGLE) and (not featOn[num])):
            pygame.draw.circle(screen, whiteColor, (featureSimLghtPos[num][0], featureSimLghtPos[num][1]), simLghtRadius)
            featOn[num] = True
        else:
            screen.blit(background, clearFeatRect[num], clearFeatRect[num])
            featOn[num] = False
        pygame.display.update(clearFeatRect[num])

## Update a general illumination lights
#
#  Change general illumination lights on or off
#
#  @param  on            [in]   True if on
#  @return None
def giLightOn(on):
    global screen
    global simLghtRadius
    global background
    
    if on:
        for tmpLghtPos in giSimLghtPos:
            pygame.draw.circle(screen, whiteColor, (tmpLghtPos[0], tmpLghtPos[1]), simLghtRadius)
    else:
        for tmpLghtRect in clearGiRect:
            screen.blit(background, tmpLghtRect, tmpLghtRect)
    for tmpLghtRect in clearGiRect:
        pygame.display.update(tmpLghtRect)

## Play a sound
#
#  @param  num           [in]   Index of sound to play
#  @return None
def playSound(num):
    global sndPlyr
    
    if (num < len(sndPlyr)):
        sndPlyr[num].play()

## Update background
#
#  @param  num           [in]   Index of image to show
#  @return None
def updateBgnd(num):
    global imageArr
    global screen
    global background
    global bgndRect
    
    if (num < len(imageArr)):
        #blit the background image and update all the displays
        screen.blit(background, bgndRect, bgndRect)
        screen.blit(imageArr[num], (0, 0))
        pygame.display.update(bgndRect)
        GameData.updDisp |= DispConst.UPD_ALL_DISPS

## Init the score displays
#
#  Figures out the size and sets up the clear rects to update the displays
#
#  @return None
def initScoreDisps():
    global digiFont
    global simWidth
    global simHeight
    global vidXPos
    global vidHeight
    global vidWidth
    global clearRect
    global bgndRect
    global simRatio
    
    #Make screen HD ratio, video will take up 80% of height/width
    hdRatio = 1920.0/1080.0
    videoRatio = .8
    vidWidth = int((simWidth * videoRatio) + .5)
    vidHeight = int((vidWidth/hdRatio) + .5)
    vidXPos = int((simWidth - vidWidth)/2.0 + .5)

    #Check if the requested size can be displayed
    pygame.init()
    infoObject = pygame.display.Info()
    if (simWidth > infoObject.current_w) or (simHeight > infoObject.current_h):
        print "Screen size: %d x %d not supported" % (simWidth, simHeight)
        return(errIntf.BAD_SCREEN_SIZE)

    #Convert score height and positions to simulation size
    if simRatio != 1.0:
        GameData.GameConst.SCORE_HEIGHT = int((GameData.GameConst.SCORE_HEIGHT * simRatio) + .5)
        for index in xrange(len(GameData.GameConst.SCORE_DISP_POS)):
            GameData.GameConst.SCORE_DISP_POS[index][0] = int((GameData.GameConst.SCORE_DISP_POS[index][0] * simRatio) + .5)
            GameData.GameConst.SCORE_DISP_POS[index][1] = int((GameData.GameConst.SCORE_DISP_POS[index][1] * simRatio) + .5)
        
    #Figure out size of score boxes
    plyrScoreHeight = GameData.GameConst.SCORE_HEIGHT

    #Optimize font size to height to plyrScoreHeight
    fontHeightGoal = int((plyrScoreHeight * .8) + .5)
    fontSize = 10
    fontHeight = 0
    while (fontHeight < fontHeightGoal):
        fontSize += 1
        digiFont = pygame.font.Font("font/LCDM2N__.TTF", fontSize)
        text = digiFont.render("0", 1, (10, 10, 10))
        fontHeight = text.get_height()
      
    #Active Player, single digit
    text = digiFont.render("8", 1, orangeColor)
    yPos.append(GameData.GameConst.SCORE_DISP_POS[DispConst.DISP_PLAYER_NUM][1])
    xPos.append(GameData.GameConst.SCORE_DISP_POS[DispConst.DISP_PLAYER_NUM][0] + int((text.get_width()/2.0) + .5))

    #Credits/Ball Num, two digits
    text = digiFont.render("88", 1, orangeColor)
    yPos.append(GameData.GameConst.SCORE_DISP_POS[DispConst.DISP_CREDIT_BALL_NUM][1])
    xPos.append(GameData.GameConst.SCORE_DISP_POS[DispConst.DISP_CREDIT_BALL_NUM][0] + int((text.get_width()/2.0) + .5))
    creditWidth = text.get_width()
    creditHeight = text.get_height()

    #Create clear rect for other displays
    tmpRect = pygame.Rect(0, 0, creditWidth, creditHeight)
    tmpRect.midright = xPos[DispConst.DISP_PLAYER_NUM], yPos[DispConst.DISP_PLAYER_NUM]
    clearRect.append(tmpRect)
    tmpRect = pygame.Rect(0, 0, creditWidth, creditHeight)
    tmpRect.midright = xPos[DispConst.DISP_CREDIT_BALL_NUM], yPos[DispConst.DISP_CREDIT_BALL_NUM]
    clearRect.append(tmpRect)
    
    #Figure out the player score width, create position arrays
    text = digiFont.render("8888888888", 1, orangeColor)
    scoreWidth = text.get_width()
    scoreHeight = text.get_height()

    #Create clear rect for player displays
    for index in xrange(GameData.GameConst.MAX_NUM_PLYRS):
        yPos.append(GameData.GameConst.SCORE_DISP_POS[DispConst.DISP_PLAYER1 + index][1])
        xPos.append(GameData.GameConst.SCORE_DISP_POS[DispConst.DISP_PLAYER1 + index][0] + int((scoreWidth/2.0) + .5))
        tmpRect = pygame.Rect(0, 0, scoreWidth, scoreHeight)
        tmpRect.midright = xPos[DispConst.DISP_PLAYER1 + index], yPos[DispConst.DISP_PLAYER1 + index]
        clearRect.append(tmpRect)

    #Create background rectangle for updating bgnd image
    bgndRect = pygame.Rect(0, 0, simWidth, simHeight)

## Init the feature lights
#
#  Figures out the size and sets up the clear rects to update the feature lights
#
#  @return None
def initFeatureLights():
    global simLghtRadius
    global simRatio
    
    simLghtRadius = int((float(GameData.GameConst.LGHT_RADIUS) * simRatio) + .5)
    for tmpLghtPos in GameData.GameConst.FEATURE_LGHT_POS:
        tmpLghtXPos = int((float(tmpLghtPos[0]) * simRatio) + .5)
        tmpLghtYPos = int((float(tmpLghtPos[1]) * simRatio) + .5)
        featureSimLghtPos.append((tmpLghtXPos, tmpLghtYPos))
        featOn.append(False)
        tmpRect = pygame.Rect(tmpLghtXPos - simLghtRadius, tmpLghtYPos - simLghtRadius, simLghtRadius * 2, simLghtRadius * 2)
        clearFeatRect.append(tmpRect)

## Init the general illumination lights
#
#  Figures out the size and sets up the clear rects to update the general illumination lights
#
#  @return None
def initGenIllumLights():
    global simLghtRadius
    global simRatio
    
    simLghtRadius = int((float(GameData.GameConst.LGHT_RADIUS) * simRatio) + .5)
    for tmpLghtPos in GameData.GameConst.GI_LGHT_POS:
        tmpLghtXPos = int((float(tmpLghtPos[0]) * simRatio) + .5)
        tmpLghtYPos = int((float(tmpLghtPos[1]) * simRatio) + .5)
        giSimLghtPos.append((tmpLghtXPos, tmpLghtYPos))
        tmpRect = pygame.Rect(tmpLghtXPos - simLghtRadius, tmpLghtYPos - simLghtRadius, simLghtRadius * 2, simLghtRadius * 2)
        clearGiRect.append(tmpRect)

## Create the display screen
#
#  Figures out the size and sets up the clear rects to update the general illumination lights
#
#  @param  mode          [in]   Either full screen or windowed mode
#  @return None
def createScreen(mode):
    global screen
    global simWidth
    global simHeight
    global background
    global vidXPos
    global vidHeight
    global vidWidth
    global imageArr

    print "simWidth, simHeight:  %d, %d" % (simWidth, simHeight)
    screen=pygame.display.set_mode((simWidth, simHeight),mode, 24)
    pygame.display.set_caption("Pinball Framework")

    # Fill background
    background = pygame.Surface(screen.get_size())
    background.fill((0, 0, 0))
    background.convert()
    screen.blit(background, (0, 0))
    if len(GameData.Images.BGND_GRAPHIC_FILES) != 0:
        for index in xrange(len(GameData.Images.BGND_GRAPHIC_FILES)):
            image = pygame.image.load(GameData.rulesDir + "/" + GameData.Images.BGND_GRAPHIC_FILES[index])
            if (mode & pygame.FULLSCREEN) == 0:
                image = pygame.transform.scale(image, (simWidth, simHeight))
            image.convert()
            imageArr.append(image)
        if (GameData.GameConst.INIT_BGND_IMAGE != DispConst.DISP_BLANK):
            screen.blit(imageArr[GameData.GameConst.INIT_BGND_IMAGE], (0, 0))

    # Show score positions
    text = digiFont.render("8888888888", 1, orangeColor)
    for index in xrange(GameData.GameConst.MAX_NUM_PLYRS):
        textpos = text.get_rect()
        textpos.midright = xPos[index + DispConst.DISP_PLAYER1], yPos[index + DispConst.DISP_PLAYER1]
        screen.blit(text, textpos)

    # Show player/credit positions
    text = digiFont.render("8", 1, orangeColor)
    textpos = text.get_rect()
    textpos.midright = xPos[DispConst.DISP_PLAYER_NUM], yPos[DispConst.DISP_PLAYER_NUM]
    screen.blit(text, textpos)
    text = digiFont.render("88", 1, orangeColor)
    textpos = text.get_rect()
    textpos.midright = xPos[DispConst.DISP_CREDIT_BALL_NUM], yPos[DispConst.DISP_CREDIT_BALL_NUM]
    screen.blit(text, textpos)

    #Show screen
    pygame.display.update()

    #Playing a sound
    pygame.mixer.init()
    createSndPlyr()
    giLightOn(True)

## Initialize display function
#
#  Initialize the display.  Initialize the sound mixer.  Set up
#  all the player displays, feature lights, general illumination lights,
#  and creates the screens.
#
#  @param  gameData       [in]   GameData object
#  @param  passedSimWidth [in]   Simulated screen width
#  @param  fullScr        [in]   True if full screen mode.
#  @return CMD_OK
def init(gameData, passedSimWidth, fullScr):
    global GameData
    global simWidth
    global simHeight
    global simRatio

    GameData = gameData
    simWidth = passedSimWidth
    if fullScr:
        mode = pygame.FULLSCREEN | pygame.NOFRAME
    else:
        mode = 0
    simRatio = float(simWidth)/float(GameData.GameConst.DISPLAY_RESOLUTION[GameData.GameConst.WIDTH_OFFSET])
    if (simWidth != GameData.GameConst.DISPLAY_RESOLUTION[GameData.GameConst.WIDTH_OFFSET]):
        print "Sim Ratio = %f" % simRatio
    simHeight = int((simRatio * float(GameData.GameConst.DISPLAY_RESOLUTION[GameData.GameConst.HEIGHT_OFFSET])) + .5)
    pygame.mixer.pre_init(44100, -16, 2, 2048) # setup mixer to avoid sound lag

    initScoreDisps()
    initFeatureLights()
    initGenIllumLights()
    createScreen(mode)
    return(errIntf.CMD_OK)

## Start the display thread
#
#  @return None
def start():
    thread.start_new_thread(dispThread, ("Disp Thread",))

## Exit the display thread
#
#  @return None
def dispExit():
    global runDispThread
    
    runDispThread = False

## Display thread
#
#  Update the display scores using update list.  Update feature lights
#  using the update list.  
#
#  @return None
def dispThread(unused):
    global runDispThread
    global updFeatList
    
    clock = pygame.time.Clock()
    while runDispThread:
        if GameData.updDisp != 0:
            update = GameData.updDisp
            GameData.updDisp &= ~update
            for index in xrange(DispConst.NUM_DISPS):
                if (update & (1 << index))!= 0:
                    updateDisp(index) 
        for tmpUpdFeat in updFeatList:
            updateFeatLight(tmpUpdFeat[0], tmpUpdFeat[1])
        updFeatList = []
        #Disp thread processing
        clock.tick(100)
