krayon/pinball-OPP/Eclipse/1009-HostCtl/src/com/wordpress/openpinballproject/hostctl/ParseRules.java

/*
 *===============================================================================
 *
 *                         OOOO
 *                       OOOOOOOO
 *      PPPPPPPPPPPPP   OOO    OOO   PPPPPPPPPPPPP
 *    PPPPPPPPPPPPPP   OOO      OOO   PPPPPPPPPPPPPP
 *   PPP         PPP   OOO      OOO   PPP         PPP
 *  PPP          PPP   OOO      OOO   PPP          PPP
 *  PPP          PPP   OOO      OOO   PPP          PPP
 *  PPP          PPP   OOO      OOO   PPP          PPP
 *   PPP         PPP   OOO      OOO   PPP         PPP
 *    PPPPPPPPPPPPPP   OOO      OOO   PPPPPPPPPPPPPP
 *     PPPPPPPPPPPPP   OOO      OOO   PPP
 *               PPP   OOO      OOO   PPP
 *               PPP   OOO      OOO   PPP
 *               PPP   OOO      OOO   PPP
 *               PPP    OOO    OOO    PPP
 *               PPP     OOOOOOOO     PPP
 *              PPPPP      OOOO      PPPPP
 *
 * @file:   ParseRules.java
 * @author: Hugh Spahr
 * @date:   2/06/2013
 *
 * @note:   Open Pinball Project
 *          Copyright© 2013, Hugh Spahr
 *
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
 *===============================================================================
 */
/**
 * Parse a rules file.
 *
 *===============================================================================
 */

package com.wordpress.openpinballproject.hostctl;

import java.io.BufferedReader;
import java.io.DataInputStream;
import java.io.FileInputStream;
import java.io.FileNotFoundException;
import java.io.IOException;
import java.io.InputStreamReader;
import java.io.PrintWriter;
import java.io.UnsupportedEncodingException;
import java.util.Collections;
import java.util.HashMap;
import java.util.Map;

public class ParseRules
{
   public static final int       STATE_IDLE              = 0;
   public static final int       STATE_NAME_SOL          = 1;
   public static final int       STATE_NAME_INP          = 2;
   public static final int       STATE_NAME_LED          = 3;
   public static final int       STATE_NAME_VAR          = 4;
   public static final int       STATE_NAME_IND_VAR      = 5;
   public static final int       STATE_NAME_MODE         = 6;
   public static final int       STATE_NAME_PROC_CHAIN   = 7;
   public static final int       STATE_NAME_LED_CHAIN    = 8;
   public static final int       STATE_NAME_SOUND        = 9;
   public static final int       STATE_NAME_VIDEO        = 10;
   public static final int       STATE_TICK_TIME         = 11;
   public static final int       STATE_TIMERS            = 12;
   public static final int       STATE_FIRST_MODE        = 13;
   private int                   state                   = STATE_IDLE;

   public static final int       SYMB_SOL_PIN            = 0x00000000;
   public static final int       SYMB_INP_PIN            = 0x00010000;
   public static final int       SYMB_LED_PIN            = 0x00020000;
   public static final int       SYMB_VAR                = 0x00030000;
   public static final int       SYMB_INDX_VAR           = 0x00040000;
   public static final int       SYMB_SND                = 0x00050000;
   public static final int       SYMB_BIG_VID            = 0x00060000;
   public static final int       SYMB_LITTLE_VID         = 0x00070000;
   public static final int       SYMB_PCHAIN             = 0x00080000;
   public static final int       SYMB_TIMER              = 0x00090000;
   public static final int       SYMB_MODE               = 0x000a0000;
   public static final int       SYMB_CONST              = 0x000b0000;
   public static final int       SYMB_LED_CHAIN				= 0x000c0000;
   public static final int       SYMB_PARAM_MASK         = 0x0000ffff;
   public static final int       SYMB_TYPE_MASK          = 0x00ff0000;

   public static int             allocInd = 0;
   public static HashMap<String, Integer>    hmSymbol;
   
   
   private static final Map<String, Integer> RSVD_STATE_MAP = (Map<String, Integer>) createMap();

   private static Map<String, Integer> createMap()
   {
       Map<String, Integer> result = new HashMap<String, Integer>();
       result.put("SOLENOID_CARDS", STATE_NAME_SOL);
       result.put("INPUT_CARDS", STATE_NAME_INP);
       result.put("LED_CARDS", STATE_NAME_LED);
       result.put("VARIABLES", STATE_NAME_VAR);
       result.put("INDEXED_VARIABLES", STATE_NAME_IND_VAR);
       result.put("MODES", STATE_NAME_MODE);
       result.put("PROCESS_CHAINS", STATE_NAME_PROC_CHAIN);
       result.put("LED_CHAINS", STATE_NAME_LED_CHAIN);
       result.put("SOUND_CLIPS", STATE_NAME_SOUND);
       result.put("VIDEO_CLIPS", STATE_NAME_VIDEO);
       result.put("TICK_TIME", STATE_TICK_TIME);
       result.put("TIMERS", STATE_TIMERS);
       result.put("FIRST_MODE", STATE_FIRST_MODE);
       return Collections.unmodifiableMap(result);
   }
   
   /*
    * ===============================================================================
    * 
    * Name: ParseRules
    * 
    * ===============================================================================
    */
   /**
    * Parse rules file
    * 
    * Read the the rules file looking for reserved words.  Hand the information to
    * the appropriate sub-classes.
    * 
    * @param   rulesFile - name of the rules file 
    * @return  None
    * 
    * @pre None 
    * @note None
    * 
    * ===============================================================================
    */
   public ParseRules(
      String                           rulesFile)
   {
      int                              offset;
      boolean                          done;
      int                              lineNum = 0;
      String[]                         tokens;
      Integer                          temp;
      
      GlobInfo.modeClass = new ModeClass();
      hmSymbol = new HashMap<String, Integer>();
      try
      {
         FileInputStream               fstream = new FileInputStream(rulesFile);
         DataInputStream               in = new DataInputStream(fstream);
         BufferedReader                br = new BufferedReader(new InputStreamReader(in));
         String                        strLine;
         
         /* Create generated code files */
         CreateGenCodeFiles();
         try
         {
            while (((strLine = br.readLine()) != null) && !GlobInfo.parseFail)
            {
               done = false;
               
               /* Remove everything after a '#' since it is a comment */
               offset = strLine.indexOf("#");
               if (offset != -1)
               {
                  strLine = strLine.substring(0, offset);
               }
               
               /* Guarantee spaces before and after () {} and [] for split */
               strLine = strLine.replaceAll("\\{", " \\{ ").replaceAll("\\}", " \\} ");
               strLine = strLine.replaceAll("\\[", " \\[ ").replaceAll("\\]", " \\] ");
               strLine = strLine.replaceAll("\\(", " \\( ").replaceAll("\\)", " \\) ");
               strLine = strLine.replaceAll("\\,", " \\, ");
               strLine = strLine.replaceAll("\\++", " \\++ ").replaceAll("\\--", " \\-- ");;
            
               /* Make sure that some tokens exist */
               tokens = strLine.trim().split("\\s+");
               if (tokens[0].equals(""))
               {
                  done = true;
               }
               
               if (!done)
               {
                  if (state == STATE_IDLE)
                  {
                     /* Look for keyword */
                     temp = RSVD_STATE_MAP.get(tokens[0]);
                     if (temp == null)
                     {
                        /* Could not find dictionary entry */
                        done = true;
                     }
                     else
                     {
                        state = temp.intValue();
                        processTokens(tokens);
                     }
                  }
                  else
                  {
                     processTokens(tokens);
                  }
               }
               // Print the content on the console
               lineNum++;
            }
            in.close();
            CloseGenCodeFiles();
         }
         catch (IOException e)
         {
            GlobInfo.hostCtl.printMsg("I/O exception reading rules file.");
            GlobInfo.parseFail = true;
         }
      }
      catch (FileNotFoundException e)
      {
         GlobInfo.hostCtl.printMsg("Rules file not found.");
         GlobInfo.parseFail = true;
      }
   } /* end ParseRules */
   
   /*
    * ===============================================================================
    * 
    * Name: processTokens
    * 
    * ===============================================================================
    */
   /**
    * Process tokens (fields) from rules file
    * 
    * Hand tokens to appropriate classes for processing.  This would be an unglorified
    * jump table, but alas, no jump tables in java.  (Grrrr).
    * 
    * @param   state - current processing state
    * @param   tokens - information to be processed 
    * @return  None
    * 
    * @pre None 
    * @note None
    * 
    * ===============================================================================
    */
   private void processTokens(
      String[]                         tokens)
   {
      switch (state)
      {
         case STATE_NAME_SOL:
         {
            if (GlobInfo.solClass == null)
            {
               GlobInfo.solClass = new SolenoidClass(tokens);
            }
            else
            {
               if (GlobInfo.solClass.addEntries(0, tokens))
               {
                  GlobInfo.hostCtl.printMsg("Finished processing SOLENOID_CARDS.");
                  state = STATE_IDLE;
               }
            }
            break;
         }
         case STATE_NAME_INP:
         {
            if (GlobInfo.inpCardClass == null)
            {
               GlobInfo.inpCardClass = new InpCardClass(tokens);
            }
            else
            {
               if (GlobInfo.inpCardClass.addEntries(0, tokens))
               {
                  GlobInfo.hostCtl.printMsg("Finished processing INPUT_CARDS.");
                  state = STATE_IDLE;
               }
            }
            break;
         }
         case STATE_NAME_LED:
         {
            if (GlobInfo.ledClass == null)
            {
               GlobInfo.ledClass = new LedClass(tokens);
            }
            else
            {
               if (GlobInfo.ledClass.addEntries(0, tokens))
               {
                  GlobInfo.hostCtl.printMsg("Finished processing LED_CARDS.");
                  state = STATE_IDLE;
               }
            }
            break;
         }
         case STATE_NAME_VAR:
         {
            if (GlobInfo.varClass == null)
            {
               GlobInfo.varClass = new VarClass(tokens);
            }
            else
            {
               if (GlobInfo.varClass.addEntries(0, tokens))
               {
                  GlobInfo.hostCtl.printMsg("Finished processing VARIABLES.");
                  state = STATE_IDLE;
               }
            }
            break;
         }
         case STATE_NAME_IND_VAR:
         {
            if (GlobInfo.indxVarClass == null)
            {
               GlobInfo.indxVarClass = new IndxVarClass(tokens);
            }
            else
            {
               if (GlobInfo.indxVarClass.addEntries(0, tokens))
               {
                  GlobInfo.hostCtl.printMsg("Finished processing INDEXED_VARIABLES.");
                  state = STATE_IDLE;
               }
            }
            break;
         }
         case STATE_NAME_MODE:
         {
            if (GlobInfo.parseModes == null)
            {
               GlobInfo.parseModes = new ParseModes(tokens);
            }
            else
            {
               if (GlobInfo.parseModes.addEntries(0, tokens))
               {
                  GlobInfo.hostCtl.printMsg("Finished processing MODES.");
                  state = STATE_IDLE;
               }
            }
            break;
         }
         case STATE_NAME_PROC_CHAIN:
         {
            if (GlobInfo.parsePChain == null)
            {
               GlobInfo.parsePChain = new ParsePChain(tokens);
            }
            else
            {
               if (GlobInfo.parsePChain.addEntries(0, tokens))
               {
                  GlobInfo.hostCtl.printMsg("Finished processing PROC_CHAINS.");
                  state = STATE_IDLE;
               }
            }
            break;
         }
         case STATE_NAME_LED_CHAIN:
         {
            if (GlobInfo.parseLedChain == null)
            {
               GlobInfo.parseLedChain = new ParseLedChain(tokens);
            }
            else
            {
               if (GlobInfo.parseLedChain.addEntries(0, tokens))
               {
                  GlobInfo.hostCtl.printMsg("Finished processing LED_CHAINS.");
                  state = STATE_IDLE;
               }
            }
            break;
         }
         case STATE_NAME_SOUND:
         {
            if (GlobInfo.sndClass == null)
            {
               GlobInfo.sndClass = new SoundClass(tokens);
            }
            else
            {
               if (GlobInfo.sndClass.addEntries(0, tokens))
               {
                  GlobInfo.hostCtl.printMsg("Finished processing SOUND_CLIPS.");
                  state = STATE_IDLE;
               }
            }
            break;
         }
         case STATE_NAME_VIDEO:
         {
            if (GlobInfo.vidClass == null)
            {
               GlobInfo.vidClass = new VideoClass(tokens);
            }
            else
            {
               if (GlobInfo.vidClass.addEntries(0, tokens))
               {
                  GlobInfo.hostCtl.printMsg("Finished processing VIDEO_CLIPS.");
                  state = STATE_IDLE;
               }
            }
            break;
         }
         case STATE_TICK_TIME:
         {
            try
            {
               GlobInfo.tick = Integer.parseInt(tokens[1]);
            }
            catch (NumberFormatException e)
            {
               GlobInfo.hostCtl.printMsg("TICK_TIME: Illegal tick time.");
               GlobInfo.parseFail = true;
            }
            state = STATE_IDLE;
            break;
         }
         case STATE_TIMERS:
         {
            if (GlobInfo.tmrClass == null)
            {
               GlobInfo.tmrClass = new TimerClass(tokens);
            }
            else
            {
               if (GlobInfo.tmrClass.addEntries(0, tokens))
               {
                  GlobInfo.hostCtl.printMsg("Finished processing TIMERS.");
                  state = STATE_IDLE;
               }
            }
            break;
         }
         case STATE_FIRST_MODE:
         {
         	break;
         }
      }
   } /* end processTokens */
   
   /*
    * ===============================================================================
    * 
    * Name: CreateGenCodeFiles
    * 
    * ===============================================================================
    */
   /**
    * Create Generated Code Files
    * 
    * Create the automatically generated code files
    * 
    * @param   None 
    * @return  None
    * 
    * @pre None 
    * @note None
    * 
    * ===============================================================================
    */
   private void CreateGenCodeFiles()
   {
   	try
   	{
   		PrintWriter 						fileConstClass = new PrintWriter("genCode/ConstClass.java", "UTF-8");
   		
      	GlobInfo.fileConstClass = fileConstClass;
      	GlobInfo.fileConstClass.println("package com.wordpress.openpinballproject.gencode;");
      	GlobInfo.fileConstClass.println("");
      	GlobInfo.fileConstClass.println("public class ConstClass");
      	GlobInfo.fileConstClass.println("{");
   	}
   	catch (UnsupportedEncodingException e)
   	{
   		/* HRS:  Need code here */
   	}
      catch (FileNotFoundException e)
      {
         GlobInfo.hostCtl.printMsg("ConstClass.java not created.");
         GlobInfo.parseFail = true;
      }
   	try
   	{
   		PrintWriter 						fileRulesClass = new PrintWriter("genCode/RulesClass.java", "UTF-8");
   		
      	GlobInfo.fileRulesClass = fileRulesClass;
      	GlobInfo.fileRulesClass.println("package com.wordpress.openpinballproject.gencode;");
      	GlobInfo.fileRulesClass.println("");
      	GlobInfo.fileRulesClass.println("import com.wordpress.openpinballproject.hostctl.GlobInfo;");
      	GlobInfo.fileRulesClass.println("import com.wordpress.openpinballproject.gencode.ConstClass;");
      	GlobInfo.fileRulesClass.println("import com.wordpress.openpinballproject.gencode.StdFuncs;");
      	GlobInfo.fileRulesClass.println("");
      	GlobInfo.fileRulesClass.println("public class RulesClass");
      	GlobInfo.fileRulesClass.println("{");
      	GlobInfo.fileRulesClass.println("   private int                         mode = 0;");
      	GlobInfo.fileRulesClass.println("   public static int[]                 Variable;");
      	GlobInfo.fileRulesClass.println("");
   	}
   	catch (UnsupportedEncodingException e)
   	{
   		/* HRS:  Need code here */
   	}
      catch (FileNotFoundException e)
      {
         GlobInfo.hostCtl.printMsg("RulesClass.java not created.");
         GlobInfo.parseFail = true;
      }
   } /* end CreateGenCodeFiles */
   
   /*
    * ===============================================================================
    * 
    * Name: CloseGenCodeFiles
    * 
    * ===============================================================================
    */
   /**
    * Close Generated Code Files
    * 
    * Close the automatically generated code files
    * 
    * @param   None 
    * @return  None
    * 
    * @pre None 
    * @note None
    * 
    * ===============================================================================
    */
   private void CloseGenCodeFiles()
   {
      if (GlobInfo.fileConstClass != null)
      {
      	GlobInfo.fileConstClass.println("}");
      	GlobInfo.fileConstClass.close();
      }
      if (GlobInfo.fileRulesClass != null)
      {
      	GlobInfo.fileRulesClass.println("}");
      	GlobInfo.fileRulesClass.close();
      }
   } /* end CloseGenCodeFiles */
   
} /* End ParseRules */
