krayon/pinball-OPP/(commit log)

2012-09-02 Added the EEPROM burner project in Kicad.
    [eprom.brd, eprom.sch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]
2012-11-25 Added parts in commonlib for display project. Added first version of the display driver board. Note: This version of the display driver board has not been fully reviewed.
    [1008.brd, 1008.disp1.sch, 1008.disp2.sch, 1008.disp3.sch, 1008.proc.sch, 1008.sch]
2012-11-25 Updates to finish the routing.
    [1008.brd]
2012-11-27 Added silkscreen for cutouts for connectors. Added connectors for distributing VDD. Move connectors closer to the edge. Add more clearance for mounting hardware. Change connectors to right angle beca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
    [1008.brd, 1008.disp1.sch, 1008.disp2.sch, 1008.disp3.sch, 1008.proc.sch, 1008.sch]
2012-11-27 Updated silkscreen.
    [1008.brd, 1008.disp1.sch, 1008.disp2.sch, 1008.disp3.sch, 1008.proc.sch, 1008.sch]
2012-11-28 Finished moving reference designators. Added silkscreen for picking player number and if main controller or player. Added silkscreen for board rev and assembly rev.
    [1008.brd]
2012-11-28 Added Gerber files. Changed via hole diameter for more annular ring tolerance. Fix solder mask on edge connectors.
    [1008.brd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]
2012-11-30 Initial check-in of stdlib, bootloader, and display driver firmware. The display driver firmware is just a skeleton.
2012-12-04 Added code for display driver firmware (1008). Added a boot indication LED, current limit resistor, and rs232 header support to the board.
    [1008.brd, 1008.disp1.sch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]
2012-12-05 Added part numbers to schematic. Generated BOM for project. Created spreadsheet file to total cost of project.
    [1008.csv, 1008.disp1.sch, 1008.disp2.sch, 1008.disp3.sch, 1008.mod.ods, 1008.proc.sch, 1008.sch, 1008.simp.csv]
2012-12-06 Added connectors, and shorting jumpers to BOM.
    [1008.mod.ods]
2012-12-07 Added solenoid driver board firmware.
2012-12-14 Fix location of APP_TABLE. Processor should use small memory model.
    [BDM_P&E_Multilink_CyclonePro.ini, digital.c, main.c, projintrpts.h, version.h]
2012-12-17 Change osc to slow. Fix addr compare to use input card.
    [BDM_P&E_Multilink_CyclonePro.ini, rs232proc.c, version.h]
2012-12-21 Changed serial transmit to use TDRE bit to increase transmit. Debugger sets processors to run at 8MHz bus clock. This could be increased to 10MHz in the future if necessary. Change addressing of card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
    [BDM_P&E_Multilink_CyclonePro.ini, derivative.h, digital.c, inpDrvTest.py, main.c, rs232Intf.py, rs232intf.h, rs232proc.c]
2012-12-21 Missed version file in solenoid project.
    [version.h]
2012-12-26 Only look at 1 input per loop to insure rs232 cmds aren't missed, if not using switch solenoid input, use it as a state input, re-enable jump to bootloader. Add test to continuously read solenoid inp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
    [BDM_P&E_Multilink_CyclonePro.ini, digital.c, inpDrvTest.py, main.c, rs232proc.c, solglob.h, version.h]
2013-01-08 Added CodeDownload to support field upgrades of teh code. Updated comments in HexMerge to match GPL. Upgraded Kicad library to add a couple more surface mount connectors.
2013-01-15 Initial check-in of Java host controller. This code is just a frame that contains a short video running on the backglass LCD, and four player's scores, and the beginning of the serial interface to th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
    [GlobInfo.java, SerIntf.java]
2013-01-17 Initial serial port interfacing to the hardware. Created thread for serial communication. Card status is now polled every 15ms.
2013-01-18 Finished debug frame for real-time feedback of switch inputs. Fixed rcv msg processing for solenoid/input switch reads. Added schematics for input board, solenoid driver, LED driver, RS232 interface,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
    [1001.brd, 1001.sch, 1003.brd, 1003.sch, 1004.brd, 1004.sch, 1006.brd, 1006.sch]
2013-01-30 Added second video with 's' key to swap between the videos. This was a test case to make sure that switches between videos could be done "rapidly". I'm currently populating multiple windows and just 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
    [GlobInfo.java]
2013-02-08 More updates to simplerules.txt. Finished the parsing of SOLENOID_CARDS. Added a couple new sounds.
2013-02-18 Added batch file in lib to switch to run on 64 bit machines.
2013-03-07 Many diverse changes: 1008 Williams display driver replacement: Add code to discover attached displays. Add valid player mask to not send new characters to unpopulated displays. Use controller displa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
    Disaster: Update simplerules.txt to look more C like. Begin code to parse PChains. Add TICK_TIME keyword and timers subsection.
    Kicad: Update parts library.
    [BDM_P&E_Multilink_CyclonePro.ini, GlobInfo.java, ParsePChain.java, ParseRules.java, dispglob.h, i2cproc.c]
2013-03-09 More work on parsing. Working on walking to the lowest level of boolean portion of if statement. Fixed syntax error in simplerules.txt which was found by the parser.
    [GlobInfo.java, LedClass.java, ParsePChain.java, ParseRules.java, SolenoidClass.java]
2013-03-12 Added 2nd char lookup table since two digits being driven by PCA9655 are driven slightly differently (bit 4 and 6 are swapped). Added another blank to char lookup tables to match defines. Changed i2c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
    [BDM_P&E_Multilink_CyclonePro.ini, i2cproc.c, version.h]
2013-03-15 More parsing work. Slow but steady. This version won't run probably.
    [ParsePChain.java, ParseRules.java]
2013-03-29 More parsing, current error includes not parsing subquantities properly in if statements.
    [GlobInfo.java, ParsePChain.java, ParseRules.java]
2013-04-25 Fixed standard library code for being SPI master.
    [stdlintf.h, stdlspi.c, version.h]
2013-09-11 Display changes: Add LED debugging for errors including i2c errors, blanking. Refresh all digits every 1 second. Upped to rev 00.00.05.
    HostCtl changes: Added three screen sizes instead of two. Add -title so titlebar can be used to move the window and debug. 64 bit dlls are the default.
    [digital.c, dispglob.h, i2cproc.c, main.c, version.h]
2013-12-02 Added initial version of interface document (not complete). Changed default python script to configure solenoids as flippers. Added price breakdown spreadsheet. Updated to support newer version of VL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
    [oppBrdCost.ods]
2013-12-19 Added -boot command to inpDrvTest.py to force board into bootloader for updating. Added first version of brdIntf.odt.
    [oppBrdCost.ods]
2013-12-23 Created HCS08MiniBoot.asm.slow.8k.sx so I don't need to remember if built for slow (16MHz) processors. Now the slow bootloader is built automatically. Bootloader is now passed in new parameters for f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
    [oppBrdCost.ods]
2014-01-05 Added solenoid wiring diagram to interface document. (Now in Docs directory) Fixed RS232 interface pinout match solenoid and input cards. Added build.bat to create zip files for each project. Added b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
    [1006.brd, 1006.kicad_pcb, 1006.sch, 1009.kicad_pcb, 1009.sch, 1010.kicad_pcb, 1010.sch]
2014-01-12 Initial check in of python pinball framework. It is mostly so that if my PC crashes I won't lose two days of work. It supports 4 players, credit/ball num fields, plays sounds, etc. Currently in the m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
    [startpin.py]
2014-02-02 Move the python script from being a prototype to the real code. Split the files out so that they functionality is contained within modules. Only bug fix is play the sounds more quickly when a key is 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
    [commHelp.py, commIntf.py, commThread.py, dispConstIntf.py, dispIntf.py, dispThread.py, errIntf.py, gameData.py]
2014-03-27 Created commThread as object to be passed to other comms modules. Added classes for each of the major components. Fixed a good number of bugs not found before with naming issues. (Now using PyDev whi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
    [commHelp.py, commIntf.py, commThread.py, dispThread.py, rulesData.py, rulesThread.py, startpin.py, tkinterThread.py]
2014-04-09 Move more variables to gameData. Added input and solenoid boards to debug window.
2014-04-12 Added support for LED cards and debug command frame. Updated to much better look and feel.
2014-04-13 Added INP_BRD_CFG and SOL_BRD_CFG which is used to configure the boards during startup.
2014-04-21 Transfer the simplerules.txt into rulesFunc.py. Added state strings, state enumeration, InpBitNames, SolBitNames, LedBitNames, Timers, and Sounds to rulesData.py. rulesFunc.py contains all of the rul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
2014-04-23 Added verification of inventory from cards to RuleData.INV_ADDR_LIST. Added errors for bad number of cards and cards don't match inventory addr list. GameData has currInpStatus and currSolStatus whic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
    [commHelp.py, commIntf.py, commThread.py, gameData.py, pygameFunc.py, rs232Intf.py]
2014-04-27 More major updates. Rules engine is now running. The LED engine is not running. Switches are feeding properly into the rules engine. Timers are currently stubbed out. Fakey interface has been broken 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
    [commHelp.py, commIntf.py, commThread.py, dispConstIntf.py, dispIntf.py, dispThread.py, errIntf.py, gameData.py]
2014-04-28 Added LED thread and LED update. Fixed rotate code. Changed position of some of the bits and display order for debug displays. Fix LED inlane code when ball is started.
    [commThread.py, ledThread.py, rulesData.py, startpin.py]
2014-04-30 Finished up doxygen documentation. Might help others understand flow of code a little better. Reorganized many files into subdirectories to clean up top directory. I don't believe that any new functi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
2014-05-05 Add LED chain processing. LED chain processing makes LEDs cycle between states without requiring the rules processor make LEDs change. Turn off all LEDs after leaving attract mode. Copy LED chain to 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
2014-05-07 Added creditBallNum to GameData since that information shares the same display. Added timer thread and sound chain processing. Added stdFunc for background music. Added globConst file which determine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
2014-05-19 Added Comms state and strings to CommIntf so debugger can print current states of communications. GameData.commState now stores current state of the comms. Removed SPECIAL_PLAY and INLANE_COMPLETE st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
2014-05-29 Add COMMs to hardware cards. This includes inventory, configuration (initial and update), and reading the inputs from solenoid/input cards. Add printed messages to console for errors in communication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
    Added initial vpt layout for PackBall. Not done.
    [commHelp.py, commIntf.py, commThread.py, dispThread.py, errIntf.py, gameData.py, ledThread.py]
2014-05-30 Added support for kicking solenoids. Make sure only try communicating if portID is set. Added support for a single background image (file name is in BGND_GRAPHIC_FILES list). Updated Doxygen to creat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
    [commHelp.py, commIntf.py, commThread.py, dispThread.py, errIntf.py, gameData.py, rulesData.py, startpin.py]
2014-06-04 Changed way update display works. Now uses bitfield and this allows background images to be updated. GameData now stores display values and update bitfield. Created image chain for automatically upda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
2014-06-05 Added RulesData.SCORE_HEIGHT so user can set height (in pixels) of displays. Added RulesData.SCORE_DISP_POS so user can place displays on screen. Each point marks the center of the display. The first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
2014-06-09 Added new GUI to simply read inputs from cards and kick individual solenoids. There was a previous non-GUI version, located in CodeWarrior8bit/1003-InpDrv/inpDrvTest.py. That required picking a test 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
2014-07-07 Started GenPyCode project. The Python project will eventually auto-generate the code necessary to run the pinball machine. Right now it simply verifies passed parameters are correct, and braces, pare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
    [GenPyCode.py, parseRules.py, procInpCards.py, procLedCards.py, procSolCards.py]
2014-07-13 Added parsing for SOLENOID_CARDS section. Auto-generates solBitNames.py file. Added description to end of solenoid row for use in debug frame.
2014-07-14 Finished inpBitNames.py, ledBitNames.py generation. Parse variables, indexed variables, sound and video.
2014-08-24 Added SS2 configs to inpDrvTest.py. Added 1011-IncandDrv and 1012-InpSolGen2 projects to Kicad. Added Mashup-010214 which contains four Incandescent driver boards, and one Input/Solenoid Generation 2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
    [1011.brd, 1011.sch, 1012-p1.sch, 1012-p2.sch, 1012.brd, 1012.sch]
2014-08-25 Updated drill size for vias to 20 mil to match FreeDFM. Changed soldermask relief to 5 mil. Added Mashup project which includes four incandescent driver boards, and a solenoid driver/input driver pai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
    [1011.brd, 1012.brd, Mashup-20140824.kicad_pcb]
2014-08-27 Added board cost files in documents.
    [BoardCosts.ods]
2014-09-06 Small code updates to fix PinBrdGui.py with correct passed parameters. Added playfield rewire document.
    [BoardCosts.ods]
2014-09-24 Pinball Framework: Added processing for simple commands (TICK_TIME, FIRST_MODE), timers, and started chain processing (not finished). Input bit names, solenoid bit names, and LED bit names. Added inp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
2014-09-24 Fix small problems in board cost spreadsheet.
    [BoardCosts.ods]
2014-09-27 Fix incandescent driver test to have bits in correct position. Add sleep so flashing can be seen.
2014-10-04 Fixes found since PyLint installed. General cleanup of GenPyCode and PinballFramework. Cleaned up init to use __init__. Updated imports to only use necessary objects. Added start of procChains.py fil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
    [GenPyCode.py, parseRules.py, procChains.py, procIndVars.py, procInpCards.py, procLedCards.py, procSimple.py, procSolCards.py]
2014-10-07 Add support for non-inverted drivers in IncandTest/incandDrvTest.py.
2015-01-18 Added parsing for LED chains, sound chains, video chains and code to create skeleton functions in rulesFunc.py. Filling out the chain functions in procChains.py is not done. Those can be filled out b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
2015-01-24 Added createRulesData.py to create the rulesData.py file. Started moving all information on solenoids into generated solBitNames.py, inputs into inpBitNames.py and LEDs into ledBitNames.py instead of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
    [GenPyCode.py, createRulesData.py, parseRules.py, procChains.py, procImage.py, procImageChains.py, procInpCards.py, procLedCards.py]
2015-01-29 First cut of createRulesData.py. Removed most of the extra code since now storing all information in a single file for solenoids, inputs boards, etc. The information isn't split across the rulesData.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
2015-02-08 GenPyCode: First full version. The -rulesFile=xxxxxx.txt parameter is the generating rules file. The -outDir=yyyy is the directory where the generated files will be saved.
    PinballFramework: Significant rewrite. The -ruleDir=yyyy is the directory with the generated rules files, and the user filled out rulesFunc.py (rulesFunc.py.gen is created by the generator to provide the shell of the called python functions found in the chain table). The pinball framework can now support multiple rules by changing a different rulesDir. This update cleanly separates rules from pinball framework. Removed rules directory since no longer used.
    BlueOctober: Rules have been moved to the BlueOct direct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
    [GenPyCode.py, commHelp.py, createRulesData.py, dispIntf.py, dispThread.py, gameData.py]
2015-02-10 Updates to get SS3 attract mode working. Added missing constants in gameConst.py. Updated images and sound clips in rules file.
    [gameData.py]
2015-02-20 Added INIT_BGND_IMAGE to gameConst.py. Added some more sounds to SS3 rules. Added new incandDrvTest.py test to walk a single bulb on each driver board for debugging purposes. Added simple input and s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
    [procChains.py, tkinterThread.py]
2015-03-04 Remove code in PROCESS_CHAINS of ss3rules.txt that isn't currently processed by GenPyCode. Change clock and latch parallel port bits to match interface board in incandDrvTest.py. Remove -invert suppo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
    [dispThread.py, gameData.py, procChains.py, pygameFunc.py, startpin.py, stdFuncs.py]
2015-03-08 Added support for updating multiple incandescent cards in an LED processing chain. Added support for passing lists to Led_Set function. Add parallel port support for updating incandescent cards. Fix 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
    [ledThread.py, procChains.py, procLedCards.py, procLedChains.py, stdFuncs.py, tkInpBrd.py, tkSolBrd.py]
2015-03-09 Update to PinBrdGui to support kicking solenoids. Rewrote the kick solenoid command. Old version was incorrect and actually sent the config command instead of the kick command. Kick command currently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
2015-03-11 Added standard LEDx_ALL_BITS_NAME to dictionary so it can be used for setting/clearing all LEDs on a card. Made attract mode light show significantly more jazzy. Updated KICK code in pinball framewor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
    [commHelp.py, ledThread.py, procLedCards.py]
2015-03-12 Update font file. Original font file did not work on XP because the size in the ttf was incorrect. The font file has been swapped for one that is correct.
    [dispThread.py]
2015-03-14 Slowed down blinking in attract mode. Reversed order of LED thread update so cards are being updated in correct order. List of LED lights are now copied instead of allowing LEDs to change during upda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
    [ledThread.py, stdFuncs.py, tkinterThread.py]
2015-03-22 Correct bit ordering to match hardware switch registers. Add LED bits for pop bumpers. Fix some initial bugs when interfacing with serial port on real hardware with pinball framework. Switch active l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
    [commHelp.py, commThread.py, ledThread.py, procLedCards.py]
2015-03-22 Increase speed of LEDs during attract mode. Make state input/solenoid bits active high. Fix mask for state bits in inputs/solenoids.
    [ledThread.py, solBrd.py]
2015-03-22 Fixed solenoid kicks in pinball framework. Added kicks for when games starts and balls end.
    [commHelp.py, commIntf.py]
2015-04-27 Renamed LEDs in SS3 rules to reflect purpose (not just generic names). Create simulated configuration arrays so update solenoid config works in simulation. Significant amounts of code added to custom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
    [commHelp.py, commThread.py, rulesThread.py]
2015-05-06 Added/implemented ball save timers. Solenoid kicks now work in simulation mode (i.e. don't crash framework). Timers now only return a single timeout event. (Makes it so different states don't need to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
    [commHelp.py, gameData.py, procChains.py, stdFuncs.py, timerThread.py]
2015-05-12 Jackpot available mode now happens after a mode is completed. Added some constants such as CONST_ALL_INLANES to make code look cleaner. Remove submodes in CustomFunc. (Now only used the ones containe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
    [stdFuncs.py]
2015-05-13 Lot's of generic python cleanup to add __init__ to classes. Finished coding all modes at easy level. Added proc_targets to when processing modes. Scoring is very questionable at this point (i.e. the 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
    [procChains.py, procImage.py]
2015-06-09 Changed kick of most solenoids because it was too strong. Init of attract mode now disables solenoids. CommThread was sharing same object as SolBrd.SolBitNames. They now have separate object lists. D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
    [commHelp.py, procChains.py, timerThread.py]
2015-06-13 Updated bulb measurements, input driver test parameters for Joe's/Johnny's boards, added sound comments.
    [BulbMeasurements.ods]
2015-06-13 Fix input card to allow reconfig to rise/fall edge. Previously, if configured for state mode, the card could not be reconfigured for edge mode. Update SS3 solenoid saved config so it matches config d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
    [digital.c, inpDrvTest.py, version.h]
2015-06-16 Added more callouts (one each time the mode selection is changed). Support for completing level and added callouts. Added command to check if cfg updates/kicks completed. Fixed bug where solenoid kic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
    [commIntf.py, commThread.py, procSolCards.py, procSound.py, pygameFunc.py]
2015-06-23 Fixed pop bumper LED locations in ss3rules.txt. Added scoring for most inputs. Fixed restore modes when switching between balls. When leaving jackpot mode, reset drop targets. Add kickout hole proces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
    [commHelp.py, stdFuncs.py]
2015-06-30 Replaced upper left pop with new solenoid that needs more kick. Clean up blinking LEDs at end of balls. Clear stateProg when entering/exiting modes. Fix target practice pop bumper selection. Fix trac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
2015-07-02 Move order of sounds so they can be easily indexed when a switch is hit. Restore pop bumper and slings config when a ball ends. Add code for deputy level. Call AddInputScore in all modes. Added many 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
2015-07-05 Added gallop timer so gallop sound doesn't play over itself.
2015-07-07 Fix kickout hole sound. Should now only play sound in normal mode so mode callouts are clearer.
2015-07-27 Added Gen2 boards including Incand drv, Input brd, Solenoid brd, and Intf brd.
    [1013.kicad_pcb, 1013.sch, 1014.kicad_pcb, 1014.sch, 1015.kicad_pcb, 1015.sch, 1016.kicad_pcb, 1016.sch]
2015-07-28 Updates to silkscreen and created mashup. These Gerbers sent to PCB house.
    [1013.kicad_pcb, 1013.sch, 1014.kicad_pcb, 1014.sch, 1015.kicad_pcb, 1015.sch, 1016.kicad_pcb, 1016.sch]
2015-07-29 Added OPP logo to all boards. Better late than never.
    [1013.kicad_pcb, 1014.kicad_pcb, 1015.kicad_pcb, 1016.kicad_pcb, Mashup-20150728.kicad_pcb]
2015-07-31 Fix labeling issue on the incandescent board.
    [1014.kicad_pcb, 1014.sch, Mashup-20150728.kicad_pcb]
2015-07-31 Added document that lists component/connector costs for all Gen2 boards.
    [Gen2Board.ods, Mashup-20150728.kicad_pcb]
2015-07-31 Add calculation of board prices without connectors.
    [Gen2Board.ods]
2015-08-11 Changed size of PCB sheets to 8.5" x 11". Added name/rev/board name to PCB sheets.
    [1013.kicad_pcb, 1014.kicad_pcb, 1015.kicad_pcb, 1016.kicad_pcb, Mashup-20150728.kicad_pcb]
2015-09-21 Added Creator test project to interface with Neopixels. This is a work in progress and currently does not work. It uses a timer to kick off Neopixel processing every 20ms, and an SCB configured as SP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
    [main.c, stdldigio.c, stdlintf.h, stdtypes.h]
2015-09-25 First check-in of Neopixel code which has a chance of doing something properly. This is a check-in before actually trying to do any debugging of the code. Right now there are no interrupts enabled, e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
2015-09-26 Added some debugging variables to Neopixel code. (Found underflows were occurring). Neopixel code is now working on Pioneer board.
2015-09-28 Added standard CY8CKIT-049-42xx bootloader blinking LED project. This is required so Neopixel library can link with the bootloader code. The bootloader component was added to the Neopixel project so 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
2015-11-18 Added Gen2 workspace to separate from prototyping Neopixel work. This is simply a check-in so if the hard-drive crashes, I won't lose anything. Code from the solenoid driver, and input driver have be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
    [main.c, rs232intf.h, stdldigio.c, stdlflash.c, stdlglob.h, stdlintf.h]
2015-11-25 Added rs232proc.c to process rs232 commands. Started moving validSwitch and stateMask to gen2g_info, so they can be shared between input/solenoid wing boards. (This will eventually simplify the code.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
2015-12-02 Add ability to store NV config during debug. Verified/fixed flash save/erase functions. Save num neopixels in config. Add more support for neopixels. Color table moved to gen2g_info. Added num neopix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
    [debug.c, main.c, rs232intf.h, rs232proc.c, stdlflash.c]
2015-12-10 Much improved input/solenoid board processing. Optimized to match 32 bit architecture. Now code is located in digital.c which does both input and solenoid processing. Cleaned up data structures to re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
    [digital.c, main.c, rs232intf.h, rs232proc.c, stdtypes.h]
2015-12-13 Added isr_spi.c and isr_uart.c to repository so build clean can fill out ISRs more easily. Added command processing and uart to the main loop. Fixed byte swap issue with returning wing configuration.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
    [main.c, rs232Intf.py, rs232proc.c, stdlintf.h, stdlser.c]
2015-12-16 Verified the following commands: Get serial number, get product ID, get version, set serial num, reset, go boot, and read gen2 inputs. NV Cfg bytes were removed since info is auto discovered from win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
    [debug.c, digital.c, rs232Intf.py, rs232proc.c, stdlflash.c, stdlintf.h, stdlser.c]
2015-12-27 Remove button.c from original prototype code. Switched from elapsed timer to simple ms tick count. Correct digital processing to look at correct bit. Correctly clear processor requested solenoid kick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
    [1017.kicad_pcb, 1017.sch]
2015-12-28 Added Commands.txt which gives example commands for easy cut/paste. Make it so only fast or slow incand blinking can be configured at once. Fix incand drive to match low side driver. Incand and Neo c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
    [rs232proc.c]
2015-12-29 Updated board interface document to remove first generation boards to make it more readable. Added wiring pictures for all the wing boards.
2015-12-29 Significantly updated board interface document. Removed first generation information to make the document more readable. Added CRC8 calculation Python code. Added PDF version of the document (even th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
2016-01-28 Gen2 firmware: Checking in to eliminate fear of losing a large bit of work. Gen2 firmware has been updated to add a new command to set all incandescent bulbs as either on or off in a single command. 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
    MPF:
    Initial MPF implementation for OPP hardware. All I can say is that it doesn't crash when the test machine boots. (If you start it, it will crash) More testing will happen in the next few days. Added MPFTest machine to match board sent to Brian so he can play with it. The MPFUpdates directory con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
    [attract_light_loop.yaml, config.yaml, debug.c, rs232intf.h]
2016-02-01 OPP Gen2 firmware: Added config individual solenoid, config individual input commands. This makes interfacing to MPF simpler. These commands have not been added to brdIntf document yet.
    MPFTest test machine:
    Added base mode. Added a group of LEDs for testing purposes.
    MPF OPP platform:
    More major upgrades. Currently switch updates are not getting requested.
2016-02-06 OPP Gen2 firmware: Change to default to state inputs even on solenoid switches. Makes interfacing with MPF easier. Add set individual neopixel command. Go boot command now calls Bootloadable_Load whi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
    BrdIntf:
    Added CONFIG_IND_SOL, CONFIG_IND_INP, and SET_IND_NEO command to interface document.
    MPF Test Machine:
    Fix title to not say SS3. Added a background image. Fixed scoring and printed score during a game. Added set individual neopixel command. Removed many debug statements, and fixed debug messages to use debug instead of info during logging. read_gen2_inp_resp has added calls to switch_controller.process_swit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
    [config.yaml, debug.c, digital.c, rs232intf.h, rs232proc.c]
2016-02-11 Added cyflash (based off cyflash vers 1.06 found at pypi). Nick Johnson wrote the original code and full kudos to him. I merely modified the code to work with the PSoC4 where it uses a simple twos co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
    [bootload.py]
2016-02-13 Gen2 Firmware: Added Gen2.rev0.1.0.0.cyacd as first official OPP Gen2 firmware image.
    Kicad:
    Finished surface mount Gen2 layout. Created panelized PCB for ITeadStudio order.
    [1017.kicad_pcb, Panel-20160212.kicad_pcb]
2016-03-15 Updated PDF of board interface document. (No changes to brdIntf.odt document). Updated Gen2Board.ods to include tax, and Molex connectors with proper spacing. (Regenerated pdf document).
    [Gen2Board.ods]
2016-04-08 Gen2 embedded code: Remove debug code that always overwrites NV configuration. Added Gen2.rev0.1.1.0.cyacd for downloading to boards.
    PopulateBrd document:
    Correct solenoid pinout picture.
    SolDrvG2 board:
    Move location of 4 pin switch input header to reduce interference with interface board. Update to use cheaper 6 pin Molex header. Add rev to copper layer.
    IntfBrdG2 board:
    Change future pin on ribbon cable connector to carry 12V. Make board slightly larger so it can be panellized by IteadStudio. Add better grounding. Move ribbon cable connectors so less interference with solenoid board input header. Add 3 pin header to make communicating with first board in chain easier (switch com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
    [1013.kicad_pcb, 1016.kicad_pcb, 1016.sch, 1017.kicad_pcb, 1017.sch, Panel-1013.kicad_pcb, Panel-1016.kicad_pcb, Panel-1017.kicad_pcb]
2016-04-24 Updated populateBrd.pdf to rev 0.3. Adds sections for new interface board, and surface mount incandescent board. Updated Gen2 penellized interface board to correct panellization issue.
    [Panel-1016.kicad_pcb]
2016-05-03 1014, Incandescent through-hole board: Swapped to cheaper through-hole connector. Added copper board revision. Panel-1014: Added panellization of the board. Added MPF documentation on how to use OPP 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
    [1014.kicad_pcb, 1014.sch, Panel-1014.kicad_pcb]
2016-05-06 Updated Gen2 board pricing including prices for bulk buy of parts for the Kickstarter project.
    [Gen2Board.ods]
2016-05-08 Added PSOC4200 board costs to Gen2Board.ods/pdf.
    [Gen2Board.ods]
2016-05-14 Updated Gen2Board.ods which now has a sheet that generates a parts list that can be ordered from Mouser. Added a testCfg.py that makes testing boards easier. (Wing 0 is incandescent wing, wing 1 is s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
    [Gen2Board.ods]
2016-05-14 Add PSOC 4200 boards into PartsList tab of Gen2Board.
    [Gen2Board.ods]
2016-05-14 Add column for quantities for Gen2Board.ods.
    [Gen2Board.ods]
2016-05-14 Fixed JJ row in Gen2Board.ods/pdf. BB row was incorrectly marked as paid.
    [Gen2Board.ods]
2016-05-15 Added AH and KB to Gen2Board.ods/pdf.
    [Gen2Board.ods]
2016-05-16 Updated Gen2Board.ods/pdf on Sunday night for parts purchases.
    [Gen2Board.ods]
2016-05-17 Hopefully final commit for the Gen2Board.ods/pdf file. Added JF to bought parts.
    [Gen2Board.ods]
2016-05-20 Added notes for big spenders in Gen2Board.ods/pdf. Added Joe's new sticker logo.
    [Gen2Board.ods]
2016-05-24 Added column to Gen2Board.ods/pdf to mark when packages shipped.
    [Gen2Board.ods]
2016-06-07 populateBrd.odt/pdf: Added more info on through hole incandescent boards. Fixed pictures overwriting text in PDF version.
2016-06-13 Added wiring diagrams at end of document. Fixed part number for 6 pin Molex connector in Gen2Board.ods.
    [Gen2Board.ods]
2016-06-18 Updated Gen2Test.py. Added way to easily read wing board configuration. Also added incandCfg which is used in SS3.
2016-06-19 Updated populateBrd.odt/pdf including: Added sections for modifying the PSoC 4200 processor board. Added pictures for connecting multiple boards together. Added instructions for programming cards.
    Updated some SS3 MPF files to try and get MPF 0.30 to work. Removed sound loop, so now attract show is working. Screen is not correct size.
    [attract_light_loop.yaml, config.yaml]
2016-07-10 Remove extra Creator project: CypBldrBLinkLED. Bootloader project is now contained within the Gen2 project. Added Set Serial Num/Get Serial Num command examples to Commands.txt. Default configuration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
2016-07-17 Correct problem with inpMask in unreleased firmware where solenoid inputs weren't reported properly. Corrected Gen2Test.py error where color table detection wasn't working properly. (Bug caused by up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
    [digital.c, rs232Intf.py]
2016-08-03 Gen2 Firmware: Rewrote digital and solenoid processing. Now supports solenoids input switch being any switch on the card. This also means that multiple solenoids can be kicked using a single input so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
    Gen2Test.py added wsCfg.py. RegrTestG2.py Added regression tests for on/off solenoids, delay solenoids, changing and clearing solenoid inputs
    Added wsCfg.py. Add SOL_INP_CLEAR_SOL constant to clear a solenoid's input.
    [digital.c, rs232Intf.py]
2016-08-03 Updating rs232Intf.py in Gen2Test, GenPyCode and RegrTestG2. (Added INCAND_SET_ON_OFF command). Added note that IncandTest is no longer valid so it is getting removed.
    [rs232Intf.py]
2016-08-05 Release firmware version 0.2.0.0, stored released version in Gen2Images. Added regression tests for all the incandescent commands. Added a flat to skip solenoid tests and skip incandescent tests if d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
2016-08-08 Added ON_OFF_SOL an DLY_KICK_SOL to solenoid configuration. Added SET_SOL_INPUT command. Removed brdIntf.rev0.8.pdf and added brdIntf.pdf so it is always updated to the latest version.
2016-08-19 Fix Gen2Test to only send input/solenoid configurations if there are input or solenoid boards.
2016-09-10 Added OPP board configurations for SS3.
2016-11-08 Update GenPyCode for Gen2 cards. Change INV_ADDR_LIST to include wing card configurations. Remove CARD_ORDER command and add NUM_GEN2_CARDS command. ProcInpCards/ProcSolCards/ProcLedCards now stores 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
2016-11-08 Added newly generated files to PinballFramework/SS3. Fixed bug in procInpCards where only one bit was being reported in the inpBitNames.py file.
    [procInpCards.py]
2016-11-12 Updates to pinball framework to support Gen2 hardware. First version that doesn't simply crash after starting. Haven't completed updating the communications with the Gen2 hardware. Cards are now base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
    [gameData.py, ledThread.py, rs232Intf.py, rulesData.py, solBrd.py]
2016-11-19 Update debug interface panel on pinball framework to display properly.
2016-12-01 GenPyCode: Switch input and LED bitfields to contain the wing number instead of a bitfield indicating the wing number. LEDxWy_ALL_BITS_MASK is now created for each LED wing board. ProcLedChains creat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
    PinballFramework: Fixes so it now gets to the first real game mode. LEDs were fixed and procChains now working. (Labels were messed up, but now fixed). Updated how debug info from TK is passed to pinball framework for simulation mode. Input bit names, LED bit names, and LED chains updated because of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
    [commHelp.py, commIntf.py, gameData.py, procInpCards.py]
2016-12-11 More updates to bring so PinballFramework works with Gen2 cards. Framework is currently running and can play full games again. There are some bugs, but it will be easier to test on the real machine. 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
    [procInpCards.py, procLedCards.py, procSolCards.py, stdFuncs.py]
2016-12-24 Added Kicad/1018-PwrFilter for the power filter board.
    [1018.kicad_pcb, 1018.sch, Panel-1018.kicad_pcb]
2016-12-25 Communications updates to support Gen2 hardware. Onto testing onto the real hardware. Updated initial inventory, all commands updated, LEDs now use commands instead bit banging on the parallel port. 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
2017-01-05 Added 1019 Bally interface board for driving Bally mid-70s to early 80 machines. It was specifically made for a Dolly Parton machine, but I made some efforts to make sure it would work for even machi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
    [1019.kicad_pcb, 1019.sch]
2017-01-08 More fixes for the pinball framework. At this point, games can be started, and score can be added. Games also end properly. Current issue is that solenoid status bits that are reported as one-shots a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
    [commHelp.py, commIntf.py, commThread.py, rulesThread.py, solBrd.py, stdFuncs.py]
2017-01-11 SS3 updates to fix rotating inlanes. Added bit masks for LED bits to make creating the mask easier.
    [procLedCards.py]
2017-02-04 Firmware version 0.2.0.1: Added RS232I_UPGRADE_OTHER_BRD (0x18) command. Make RS232 port transparent so other board can be upgraded. 65 EOM characters will end and reset the card.
    Gen2Test.py:
    Add support for -upgrade flag. When set, ../../Creator/Gen2Images directory is examined looking for newest version of the firmware. If there is a new version of firmware, it will upgrade each card one at a time, and rewrite the serial number into the flash (preserving it).
    [rs232Intf.py, rs232intf.h, rs232proc.c]
2017-03-11 Adding ss3BrdxCfg.py files for programming the configuration. Not sure why I never checked these in before. They are the updated versions for running 24V power supply.
2017-03-12 Added high side incandescent board to Gen2Test in Python. Basically switches if output from processor is active high or low.
2017-03-14 Support for synchronized blinking of incandescent boards. Added support for high side incandescent wings so turning on/off LEDs is same as low side incandescent wings.
2017-03-22 Support high side switched incandescent boards in the PinballFramework. Update solenoid initial kick values for lower (24V).
2017-04-11 Updates to Gen2Test to support switch matrices. Firmware changes necessary with absolutely no testing. Beginning of rules file for Dolly retheme. Added windows flag so people using non-windows platfo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
    [digital.c, rs232Intf.py, rs232intf.h, rs232proc.c]
2017-04-11 Adding version 0.2.0.3 of firmware after testing the switch matrix on Dolly. At this point, only switches can be read. Firing solenoids is not supported from the switch matrix...yet.
2017-04-15 Adding support in firmware for matrix inputs triggering solenoids. This code is completely untested. Fixed dollyBrd3Cfg.py to use an on/off solenoid instead if PWM solenoid. Add support in GenPyCode 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
    [digital.c, procInpCards.py, procSolCards.py, rs232Intf.py, rs232intf.h]
2017-04-29 GenPyCode updates: Add more support for switch matrices in GenPyCode. (Pass correct wing type to rulesData.py). Add import of rs232Intf to rulesData.py. Add rules subdirectory when creating rulesFunc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
    PinballFramework updates:
    Add support for switch matrixes in gameData.py and hwobj/inpBrd.py. Update rs232Intf.py to match other versions. Currently when running VH, it simply does not crash, no real game logic.
    [createRulesData.py, gameData.py]
2017-05-04 Updated brdIntf.odt/brdIntf.pdf to correct pinout documentation for solenoid wing board.
2017-05-06 VHRules.txt: Add more sounds and images.
    PinballFramework:
    Start adding support for read matrices. Added comm functions for READ_MATRIX_INP command. Add enough support for InpBrd so matrices can return current value. Add TK support so matrix inputs are shown in debug window. Matrix inputs from debug window aren't supported yet.
2017-05-11 PinballFramework: Changed framework so each wing always exists in the currWingInp, currDebugInp, currInpStatus, etc. Makes processing much simpler. Remove currMatrixData, matrix inputs are now dealt 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
    VH:
    With changes debug now being fed into rules properly. The machine now starts a game and players can be added. Added a few more graphics images to help player se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
2017-05-31 Creator: Switch column numbering order to match Bally documentation. Added Gen2.rev0.2.0.4.cyacd to support kicking solenoids using local input switch matrix.
    Gen2Test:
    Added configurations for dollyBrd2/Brd3 with correct input switches. Added -card option so test=1 could display any inputs from a card in the whole chain (not just the first). Added CFG_SOL_USE_MTRX_AUTO_CLR to support switch inputs kicking solenoids. This is the normal case since you want the input to the solenoid to clear automatically.
    GenPyCode: Updated VHrules.txt to correct solenoid locations. Molex pin numbers do not equal solenoid numbers. (Doh!)
    PinballFramework: inpBitNames.py/solBitNames.py updated to ref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
    [digital.c, procSolCards.py, rs232Intf.py]
2017-06-02 GenPyCode: Fix procSolCards to accept CFG_SOL_USE_MTRX_AUTO_CLR
    PinballFramework: Add CFG_SOL_USE_MTRX_AUTO_CLR to rs232Intf.py. Fix solBitNames.py generation when using CFG_SOL_USE_MTRX_AUTO_CLR flag. Default debug frame to pulse switches for matrix inputs (since that is normally the case). Correct debug solenoid inputs when using matrix inputs.
    VH: Start adding actual VH rules. Well, you can start a game and that's about it at this point. Rename functions in a more standard way.
    [procChains.py, procSolCards.py, rs232Intf.py, tkInpBrd.py]
2017-06-05 Update mostly involving Van Halen rules. CheckSolBit stdFunc was fixed to reflect the new number convention.
    [procChains.py, stdFuncs.py]
2017-06-07 More updates for Van Halen rules. No changes to the Pinball Framework have been made which means it is starting to stabilize. Nice!
    [procChains.py]
2017-06-09 Added jukebox mode for Van Halen. Added retry timers for saucer kickout.
2017-06-26 Gen2 Firmware: New vers rev 0.2.0.5. Guarantee that quick debounced transition will be held until a serial command reads and resets the value. Guarantees transitions won't be missed.
    PinballFramework: Lot's of switch matrix fixes. Framework now takes matrix state inputs and simulates an edge triggered input. Added new command to read actual state of matrix inputs so that is also available for things such as spinners that occur quickly. (CheckMatrixInpState) Initialization now clears the serial link to fix initialization problems that required a power cycle of OPP cards to synchronize properly. (Send a stream of EOMs and then read the stream to flush the input pipe). Disable solenoi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
    [commHelp.py, digital.c, rs232proc.c, stdFuncs.py]
2017-07-04 Updates for SS3 code when switching to Gen2Cards.
2017-07-04 Pinball Framework: Very aggressive clearing when communications get out of sync. This is probably because I'm sending new commands to update solenoid rules, and haven't dealt with it in the pinball f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
2017-10-11 Gen2, vers 0.2.0.6: Neopixels re-added to build. (Must now be configured as wing 2. Proc bit P2[0]). All other bits on a Neo wing presented as inputs. Heap switched to 1024 bytes to accommodate NeoPi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
    C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
    [digital.c, main.c, rs232Intf.py]
2017-11-02 Added screens for creating a meet. Fixed some initilization errors if program had not been opened previously. Next step, create player groups for a meet.
    [crtmeetvm.cpp, crtmeetvm.h, last.cpp, last.h, mainwindow.cpp, mainwindow.h, meet.cpp, meet.h]
2017-11-06 Added code to create pinball groups. Added viewmodel which displays groups for each of the meets. Removed extra action menus that didn't really do anything.
    [crtmeetvm.cpp, crtmeetvm.h, groups.cpp, groups.h, groupsvm.cpp, groupsvm.h, mainwindow.cpp, mainwindow.h]
2017-11-10 Finish group creation. Disable certain buttons during group creation such as changing the season. Disable checkboxes of players that are already allocated to groups. Add ability to create a new playe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
    [crtmeetvm.cpp, crtmeetvm.h, groups.cpp, groups.h, groupsvm.cpp, last.cpp, logfile.cpp, mainwindow.cpp]
2018-01-23 Rename 1012-InpSolGen2 to 1012-STM32F0InpSol to indicate it is for the STM32F0 Discovery board. 1012 is an untested and orphaned set of boards. Rename 1015-InpBrdG2 to 1015-SpiNeoPxl. 1015 basically 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
    Update 1013-SolDrvG2, 1014-IncandBrdG2, and 1016-IntfBrdG2 to version 4.0.7 of KiCad. Required updating the gnd and resistor symbols to match the new standard libraries.
    [1012-p1.sch, 1012-p2.sch, 1012.brd, 1012.sch, 1013.sch, 1014.sch, 1015.kicad_pcb, 1015.sch]
2018-01-23 Removed extra boards including first generation boards (1001, 1003, 1004, 1007, 1011), disp driver (1008), Pi Shield (1010), STM32F0 board (1012), Bally Intf (1019), EPROM burner, Mashups, and Panel-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
    [1001.brd, 1001.sch, 1003.brd, 1003.sch, 1004.brd, 1004.sch, 1007.brd, 1007.sch]
2018-01-25 Added new 1019-SolPlankG2. Board contains 8 solenoid drivers on a single board plus the interface connections. Haven't bothered panellizing it yet. Remove unused Creator/TestProj. Remove Kicad links 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
    [1015.kicad_pcb, 1015.sch, 1019.kicad_pcb, 1019.sch]
2018-01-25 Added 1020-IncandPlankG2 board into repository. Moved top left mounting hole on 1019-SolPlankG2 to allow a little more space for processor board.
    [1019.kicad_pcb, 1020.kicad_pcb, 1020.sch]
2018-02-10 Rev 0.2.0.7 of OPP firmware: Fixed bug reported by BorgDog where flippers would remain active even after switch inputs disabled. Bug was caused by not disabling solenoid if no inputs remained after r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
    Fix small bug that crept into Gen2Test.py. Looks like a cut/paste of rcvReadMatrixResp was placed in a random location within the file.
    [digital.c]
2018-02-11 Rev 0.3.0.0 of firmware: No changes from version 0.2.0.7, just indicating regression tests have been run. Added new regression test to verify removing input disables flipper coil. Small changes since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
2018-04-18 SolPlank: Increase via size to meet DFM minimum. Update build.bat to save to 1019.zip. Add build_notes.txt to describe setting up Kicad libraries, and creating Gerbers. Add 1019.zip for ease of order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
    IncandPlank: Increase via size to meet DFM minimum. Update build.bat to save to 1020.zip. Add build_notes.txt to describe setting up Kicad libraries, and creating Gerbers. Add 1019.zip for ease of ordering PCBs.
    VH: Last updates grabbed from machine before sending to Joe.
    [1019.kicad_pcb, 1020.kicad_pcb]
2018-04-25 Kicad: Rename Panel-1018/Gerber/Gerber.zip to Panel-1018.zip. Fix title on PCB legend. Create Panel-1019 and Panel-1020 to panelize solenoid and incandescent planks.
    [Panel-1018.kicad_pcb, Panel-1019.kicad_pcb, Panel-1020.kicad_pcb]
2018-10-06 Prototype code to add two OPP solenoid wings to Arduino Nano. Untested since I haven't received my Nano boards yet.
2018-10-11 Arduino: Add wait for switch idle to prevent solenoids being locked on.
    [NanoOPP.ino]
2018-10-13 OPP Firmware (version 0.3.0.1): Add CAN_CANCEL flag to allow cancelling of initial kick pulse with a solenoid. Update to PSOC creator 4.2.
2018-11-03 Gen2 firmware: Changed version to 1.0.0.0 after regression testing.
    Docs: Updated brdIntf.odt/brdIntf.pdf to add section on upgrading boards, reading switch matrix inputs, and CAN_CANCEL solenoid bit. Added WING_HI_SIDE_INCAND board type which inverts controls to match WING_INCAND board.
    Python: Merge rs232Intf.py files into one. Add CAN_CANCEL test to RegrTestG2.py.
    [commHelp.py, rs232Intf.py, tkinterThread.py]
2018-11-15 Arduino: Update Arduino nano program to give a single short pulse at the end of each main loop.
    [NanoOPP.ino]
2018-11-17 Arduino: Fix some bogs in original NanoOPP.ino. First version of NanoBareOPP.ino which is bare metal programming of two solenoid wings.
    [NanoBareOPP.ino]
2018-12-30 Arduino: Final update of arduino code with two working solenoid wings. Good number of bug fixes in this arduino version of code.
    [NanoBareOPP.ino]
2019-01-05 OPP Firmware vers 1.0.0.1: When reconfiguring solenoid, clear drive bit while changing state to SOL_STATE_IDLE. Note: This is prototype firmware that hasn't been regression tested.
2019-10-26 Rev 1.0.0.2 of PSOC firmware: Reclear solenoid drive signal continuously during SOL_STATE_IDLE and SOL_MIN_TIME_OFF.
2019-11-02 Rev 1.0.0.3 of OPP firmware: Remove rev 1.0.0.2 of firmware which didn't work. Corrected code to rewrite clearing of solenoids continuously during idles.
    [digital.c]
2019-11-12 Rev 1.0.0.4 of OPP firmware: Remove rev 1.0.0.2/1.0.0.1 of firmware which didn't work. Version 1.0.0.1 of firmware disabled solenoid MOSFETs during reconfiguration but did not verify a solenoid was c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
    [digital.c, rs232proc.c]
2019-12-20 Initial checkin of STM32 firmware. New folder is Stm32Workbench/OppGen3. No firmware built firmware versions have been included in this version.
    Includes updates to Gen2Test.py and RegrTestG2.py for linux support.
    [OppGen3 Debug.cfg, OppGen3.cfg]
2019-12-20 Rev 1.0.1.2 of OPP Stm32 firmware:
    Add delay before reading matrix row inputs.
    [OppGen3 Debug.cfg]
2019-12-29 Rev 1.0.1.3 of OPP Stm32 firmware:
    Fix PA14 and PA2 issues. Shift was in wrong direction causing PA14 to overwrite PA2.
    [digital.c, stdldigio.c]
2020-02-12 Non-versioned OPP Stm32 firmware:
    Initial NeoPixel code. Currently writes static colors to NeoPixels, but preparing for NeoPixel updates. Uses SPI DMA to update NeoPixels.
2020-02-24 Kicad updates: Added IncandWing (1014.zip), PwrFilter (1018.zip), updated Sol Panel (Panel-1013.zip), Incand Panel (Panel-1014.zip), and Pwr Filter Panel (Panel-1018.zip). Panels had a different dril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
    [1014.kicad_pcb, 1018.kicad_pcb, Panel-1013.kicad_pcb, Panel-1014.kicad_pcb, Panel-1018.kicad_pcb]
2020-02-24 Kicad: Missed SolWing (renamed from Gerber.zip to 1013.zip).
    [1013.kicad_pcb]
2020-02-25 Kicad: Some zip files had multiple copies of copper layers because 7zip can store multiple files of the same names with different dates. Cleared out Gerber directories and regenerated all files.
    [1014.kicad_pcb, 1016.kicad_pcb, 1017.kicad_pcb, Panel-1017.kicad_pcb]
2020-02-25 Kicad: Missed adding copper mask layers to zips. Added edge cuts to all individual wing boards.
    [1013.kicad_pcb, 1014.kicad_pcb, 1017.kicad_pcb, 1018.kicad_pcb, 1019.kicad_pcb, 1020.kicad_pcb, Panel-1013.kicad_pcb, Panel-1014.kicad_pcb]
2020-03-19 OPP STM32 version 2.0.0.0: Add Neopixel support for STM32. Clean USB serial processing. Removed incand synch since chains not supported. Neopixel now only supported using SPI2 DMA. Remove commands no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
    Documentation:
    brdIntf.odt/pdf updated to version 1.01. Adds updates for STM32 firmware and Neopixel fade command.
    Python:
    regrStm32Cfg.py - STM32 regression test configuration
    RegrTestGw.py - Add regression tests for Neopixels on STM32
2020-03-24 OPP STM32 version 2.0.0.1: Fix Neopixel fade support for STM32. (A one bit change with for so much pain)
    RegrTestGw.py - Update various regression tests for Neopixels to make it easier to use.
    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
2020-03-28 OPP STM32 version 2.0.0.2: Add initial pattern configuration for serial LEDs. Update documentation. Clean up implementation of pixel configuration.
2020-05-29 OPP STM32 version 2.0.0.3: Added NeoSol support and NeoWing can only be wing 0. Fix init of four incand wing setup where digital_init() wasn't called. Transmit four extra zeroed bytes for Neopixels s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
    Gen2Test.py - Add NeoSol support (card type 8)
    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
    [digital.c, main.c, rs232Intf.py, rs232intf.h]
2020-07-18 OPP STM32 version 2.0.0.4: Fix download configuration issue. Add support for input timing command, but no documentation. Start adding support for SPI wing (but not completed, yes, Jan, it is slowly c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
    [digital.c, main.c, rs232intf.h, rs232proc.c, spiintf.h, spiwing.c]
2020-07-20 OPP STM32 version 2.0.0.5: Hopefully add NeoSol support. Sadly, I forgot to mark the bits as solenoid bits.
2020-08-09 OPP STM32 version 2.0.0.6: Update NeoPixel process where fade calculation is done on a per byte basis. This removes the 32 fade record restriction at the cost of more processing and more memory. Test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
2020-11-04 Update Gen2Test.py to print firmware version in addition to wing configuration.
2021-01-29 OPP STM32 version 2.0.1.0: Generalized fade support so now fades are possible on incand wings. Full regression test. Cleaned up incand rotate processing.
    RegrTestG2.py - Add more flags to make various run configurations easier. (Added flag for skipping serial test and neopixel test)
    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
    [main.c, rs232intf.h, rs232proc.c, spiwing.c]
2021-02-07 OPP STM32 version 2.0.1.7: Support configurable switch matrix wait count threshold (offset of 16 in input config), and debounce (offset of 17 in input config). These allow switch matrix params to be 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
    Gen2Test.py - Add support for SPI, active low switch matrix, and lamp matrix wings.
    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
2021-02-12 OPP STM32 version 2.0.1.11: Changing incand/lampMatrix intensities to use usec durations.
2021-02-13 OPP STM32 version 2.0.1.11: Ooops, forgot to add firmware to images folder.
2021-02-27 OPP STM32 version 2.1.0.0: Official 2.1.0.0 release
    RegrTestG2.py - Added incandescent fade command tests.
    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
2021-03-16 OPP STM32 version 2.1.0.1: Add PB2 status LED. Switch read input sense of active low switch matrix and revert back to reverse column numbering. Reduce white wood lamp matrix test mode to 50% intensit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
    [digital.c, main.c, rs232proc.c]
2021-03-23 OPP STM32 version 2.1.0.4: This should hopefully fix switch matrix active low inputs so no type: NC is needed in MPF. Removed unused images that aren't "released" images.
    [digital.c]
2021-06-05 OPP firmware 2.2.0.0: Fix bug in Neopixels code that stopped updates after a long time. (floating input causing SPI state machine to move to fail state) Verify input numbers/fade offsets/etc from ser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
    [digital.c, rs232proc.c, spiwing.c]
2021-09-26 2.2.0.2: Add servo support for wing1 inputs (inpCfg byte >= 0x40). Add servo support to fade (0x3000 base offset) to allow moving of servos from current position to new position in commanded time. Cl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
    Update brdIntf.odt/pdf to include more fade examples, get timestamp command, and servo support.
2021-10-26 2.2.0.3: Add SPI serial LED (SK8922 and APA102) support.
    Update brdIntf.odt/pdf to add SPI serial config example.
2021-11-13 2.3.0.0: Add solenoid kick PWM command. (Reduces power of initial solenoid kick). Update hold PWM to use 1 ms period instead of 16 ms. (Should be less chatter). Update documentation with solenoid kic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
2021-12-03 Firmware 2.3.0.5: Minimize sound when PWMing hold solenoids. (Changes PWM to use 500 us pulse widths). Small update to brdIntf documentation.
